hah877298-a11y/handheld-thermal-imager/01_设计说明/打样与工艺说明.md

# 主板打样与工艺说明

版本 v1.2　导出日期 2026-10-25

## 一、板卡概述

| 项目 | 内容 |
|---|---|
| 主控 | STM32F103ZET6（LQFP-144，嘉立创 C8310） |
| 电源 | USB Micro-B 5V → F1 自恢复保险丝 0.5A → AMS1117-3.3（C498117）→ 3.3V |
| 显示 | 2.54mm 2×17 排母（LCD1），直插 ATK-MD0280 2.8 寸并口屏 |
| 存储 | TF 卡座 TF1（推拉式，C293569） |
| 人机 | 4 个轻触按键 SW1~SW4、2 个 LED、5V 有源蜂鸣器 LS1（Q1 SS8050 驱动） |
| 时钟 | 8MHz 主晶振 Y1 + 32.768kHz RTC 晶振 Y2 |
| 保护 | D2 USBLC6-2SC6（USB ESD）、D1 1N4148、L1 磁珠、C16/C19 储能 |
| 调试 | J1（5P）SWD + 串口，J2/J3（4P）备用 IO |

## 二、工艺参数（与嘉立创常规打样一致）

| 项目 | 参数 |
|---|---|
| 层数 | 2 层 |
| 外形尺寸 | 100.0 × 80.0 mm，四角 R3 圆弧 |
| 板厚 | 1.6 mm |
| 铜厚 | 1 oz（35 μm） |
| 材质 | FR-4 |
| 线宽 | 信号 8 mil，3.3V/5V 主干 20 mil |
| 最小间距 | 6 mil（设计规则按此校验） |
| 过孔 | 孔径 0.3 mm / 焊盘 0.7 mm（实测钻孔 12 mil、焊盘 27.6 mil） |
| 铺铜 | 顶层 +3V3，底层整层 GND（双面铺铜） |
| 阻焊/丝印 | 绿色阻焊 / 白色丝印（下单按默认即可） |

## 三、DRC 与自检结果

- PCB DRC：0 错误 0 违规，连续运行两次结果一致。
- 元件 57 个 / 焊盘 328 个 / 过孔 98 个 / 铺铜 2 块。
- 网络级核对：57 个器件逐引脚对比原理图网表，0 处差异；无未连接网络、无短路。
- 原理图 DRC：0 错误。剩余 43 条为警告（图元网格对齐、供应商编号标准化、同名网络标号、主控未使用引脚未加非连接叉），不影响电气连接与制板。
- 固件 Keil 全量重编译：Code=58058，RO=8210，RW=152，ZI=25168，0 error 0 warning。
- 板框闭合，100×80 mm 圆角矩形。
- Gerber 独立解压核对：顶层/底层铜皮、顶层/底层丝印、顶层/底层阻焊、板框、PTH/NPTH/VIA 三个钻孔文件齐全。

## 四、阻抗说明（如实说明）

本板为两层板，没有做 90 欧姆差分阻抗控制，也未串联 22 欧姆匹配电阻（D2 为 USBLC6 ESD 保护）。实测 USB_DP 约 57 mm + 座子侧 8 mm，USB_DM 约 74 mm + 座子侧 9 mm，各经过 2 个过孔。该长度与换层对 USB 2.0 全速（12 Mbps）一般仍可正常枚举，但信号完整性余量有限；若出现识别不稳，优先缩短 D-/D+ 走线、减少换层，或改四层板做阻抗控制。

## 五、交付文件位置

| 文件 | 位置 |
|---|---|
| Gerber 制板文件.zip | `02_原理图与PCB/`，嘉立创下单直接上传这个压缩包 |
| BOM物料清单.xlsx | `02_原理图与PCB/`，26 项 / 57 个位号 |
| SMT坐标文件.xlsx | `02_原理图与PCB/`，57 行，单位 mm |
| PCB版图_顶层底层.pdf | `02_原理图与PCB/`，顶层丝印 / 顶层铜皮 / 底层丝印 / 底层铜皮 |
| PCB预览/*.png | `02_原理图与PCB/PCB预览/`，四张单层图；底层无丝印内容属正常 |
| PCB_3D渲染图.png | `02_原理图与PCB/`，带元件 3D 效果图，用于汇报展示 |
| PCB_3D模型.step | `02_原理图与PCB/`，带元件，FreeCAD/SolidWorks 可直接打开 |
| 原理图.pdf | `02_原理图与PCB/` |
| EDA工程源文件.epro2 | `02_原理图与PCB/`，嘉立创 EDA 专业版，原理图 + PCB 全在里面 |
| 手焊物料清单.xlsx | `02_原理图与PCB/`，元件/模块/工具清单 + 焊接顺序 |
| ThermalImager_v1.2.hex | `04_烧录文件/`，ST-Link 直接烧录 |
| Keil 源码 | `03_固件工程/`，可直接编译 |

## 六、下单注意

1. 上传 Gerber 压缩包后系统会自动识别：2 层 / 100×80 mm / 1.6 mm，无需手工填层数。
2. 按老师要求自行焊接：下单时只选“PCB 打样”，不要勾选 SMT 贴片；元件按 `手焊物料清单.xlsx` 自行采购，全部为 0805 及以上封装，无 0402，适合手焊。
3. 若以后改走 SMT：USB1（Micro-B 母座）在 BOM 中没有立创编号，需在下单页面手动指定，或这一颗改手焊；J1/J2/J3/LCD1 排针排母建议手焊，SMT 时可以不贴。
4. 蜂鸣器 LS1 是 5V 有源蜂鸣器 TMB12A05，由 Q1 三极管驱动，不要装成无源蜂鸣器。
5. TF 卡座为推拉式（SD-47352-101），贴片时注意方向，丝印 1 脚有标记。
6. 红外模块用 GY-MCU90640（MLX90640），I2C 模式：PS 脚接 GND 后重新上电，共 5 根线。

## 七、已知限制

1. 底层没有丝印，全部丝印在顶层，不影响打板。
2. 屏幕用 2×17 排母直插，装配时注意排母高度和外壳开窗。
3. 本板为毕业设计验证板，未做 EMC 认证测试。
4. 电源支路存在局部线宽不足 20 mil 的情况：+3V3 / +5V / USB_5V / VDDA 主干为 20 mil，但芯片引脚附近的分支为 10~12 mil；GND 部分支路为 8 mil。DRC 通过，常规电流下可用，若后续加大负载或改版，应把电源分支统一加粗到 20 mil 以上。
5. 顶层铺铜为 +3V3 而非 GND，底层为完整 GND 平面；顶层 GND 焊盘已就近打地过孔连接底层。
6. USB 差分对走线偏长且各换层 2 次，详见第四节，属于已知余量不足项。

## 八、版本变更

- v1.2　全量复核原理图/网表/PCB/固件；PCB DRC 归零；重编译固件；补充固件与焊接清单；修正过孔与 USB 说明。
- v1.1　修正 SW4 的 WK_UP 网络并补线，清理 SW3/SW4 悬空焊盘上的误接网络，重铺双面铜皮，重新导出全部制造文件。
- v1.0　首版交付。
