hah877298-a11y/handheld-thermal-imager/01_设计说明/功能验收记录/功能5_冻结与SD卡拍照.md

# 功能 5 联调验收记录（画面冻结 / SD 卡拍照）

- 日期：2026-10-07
- 硬件：正点原子精英板 STM32F103ZET6（板载 SD 卡座，SDIO PC8~12+PD2）+ 16GB SD 卡（FAT32）+ GY-MCU90640
- 固件：SDIO 驱动（教程实验 38 移植）+ FatFs（实验 39 移植，单盘化）+ 自写 BMP 模块 + WK_UP 冻结/拍照
- 观测：LCD 冻结画面 + 蜂鸣提示 + 串口日志 + 电脑端 BMP 打开验证

## 一、验收结果（对照 spec 第 8 节 6 条，全部通过）

| # | 标准 | 结果 |
|---|---|---|
| 1 | SD 卡识别 | ✓ `SD OK, size=15193MB`（16GB 卡正确识别） |
| 2 | BMP 电脑可打开、内容与屏上一致 | ✓ 256×192、24bpp、147,510 字节；铁红热图+双色准心与屏上一致、无颠倒 |
| 3 | 文件名递增不覆盖 | ✓ 0001→0007 递增；启动扫描已有最大编号防重启覆盖 |
| 4 | 冻结/解冻交互正确，蜂鸣提示 | ✓ WK_UP 按下冻结+拍照+"滴"；再按 RESUME 恢复；串口 `SAVED/RESUME` 完整记录 |
| 5 | 无卡/写失败不挂死 | ✓ `SD init FAIL`/`FATFS mount FAIL`/`SAVE FAIL` 提示路径齐备 |
| 6 | 帧率无影响 | ✓ 冻结时帧循环暂停（无 F= 输出）；解冻后 3.94Hz / r=45ms 恢复，全程无 -8 |

## 二、联调中解决的关键问题

1. **SDIO 驱动依赖**：教程驱动引用 DMA 库函数 → 工程补注册 `stm32f10x_dma.c`（驱动本身无 malloc 依赖，已核实）
2. **diskio.c 单盘化**：教程为双盘版（SD + W25QXX SPI Flash），去除 w25qxx/malloc 依赖（EX_FLASH 分支加 `#if _VOLUMES > 1` 编译守卫），`ff_memalloc/free` 用 512B 静态缓冲替换
3. **ffconf 精简**：`_VOLUMES=1`、`_CODE_PAGE=1`（ASCII 文件名，免 170KB cc936 码表）、`_USE_LFN=0`（8.3 短名）、`_USE_MKFS=0`
4. **挂载对象生命周期**：FATFS 对象必须全局存活（局部对象出块即失效），挂载改用全局 `s_fs`
5. **BMP 24bpp 字节序**：首版按 RGB 序写像素 → 红蓝通道互换、铁红变蓝调；BMP 规范为 **BGR**，修复后颜色完全正确
6. **视频条纹现象**（非缺陷）：LCD 每帧 24 条带自上而下重刷（~15ms），手机相机 30fps 抓拍会撞上"上半屏新帧/下半屏旧帧"的中间态 → 视频出现水平色带；肉眼无感（视觉暂留），属显示刷新与相机帧率的时间混叠，论文可作"显示刷新机制"讨论素材

## 三、性能与资源

- 拍照耗时：冻结态内完成，SDIO 4bit 写 147KB ≈ 100~200ms（含逐行重渲染），不影响实时帧率
- 内存：全系统 RAM 24.6KB/64KB；拍照无需整帧大缓冲（从冻结的 768 点色阶场逐行重渲染，行缓冲仅 768B）

## 四、遗留事项

- [ ] 素材存档（冻结瞬间拍屏 + 电脑 BMP 打开截图 → `docs/截图存档/功能5/`）

## 五、毕设六大功能完成总览

| 功能 | 状态 |
|---|---|
| 1. MLX90640 实时读取 | ✅ 2026-10-03 验收 |
| 2. 双线性插值热力图 | ✅ 2026-10-05 验收 |
| 3. 高低温自动追踪 | ✅ 2026-10-05 验收 |
| 4. 按键切换调色板 | ✅ 2026-10-07 验收 |
| 5. 冻结 / SD 拍照 | ✅ 2026-10-07 验收（本记录） |
| 6. 超温预警 | ✅ 2026-10-07 验收 |
