hah877298-a11y/handheld-thermal-imager/01_设计说明/功能验收记录/功能6_超温预警.md

# 功能 6 联调验收记录（超温预警）

- 日期：2026-10-07
- 硬件：正点原子精英板 STM32F103ZET6（蜂鸣器 PB8）+ GY-MCU90640（PS 接 GND）
- 固件：HARDWARE/BEEP 蜂鸣器驱动 + main.c 报警状态机（施密特迟滞），-O2
- 观测：蜂鸣器 + LED0 + 热图边框颜色 + 串口 ALARM ON/OFF

## 一、验收结果（对照 spec 第 5 节 5 条，全部通过）

| # | 标准 | 结果 |
|---|---|---|
| 1 | 触发/解除阈值正确（50 进 48 出） | ✓ 串口实录：`ALARM ON tmax=60.5`（热水杯入画）→ `ALARM OFF`（移出） |
| 2 | 红边框/白边框切换、蜂鸣响/停 | ✓ 触发时边框红+蜂鸣断续响，解除恢复白+静默（现象符合） |
| 3 | 串口 ALARM ON/OFF 打印 | ✓ 触发/解除各打一行，带 tmax 值 |
| 4 | 帧率不受影响 | ✓ 3.94Hz（F 间隔 2.03s/8 帧），r=46ms，全程无 -8 |
| 5 | 场景拍屏 + 串口截图 | ✓ 已存 `docs/截图存档/功能6/` |

实测序列（杯子进出视野）：`ON(60.5) → OFF → ON(58.4) → OFF`——每次进出只触发/解除一次，无边界抖振，迟滞带 (48,50) 工作正常。

## 二、实现要点（论文素材）

- **施密特迟滞**：触发 50°C / 解除 48°C，2°C 迟滞带内保持原状态，防阈值边界抖动反复报警
- **三级报警联动**：蜂鸣器 ~2Hz 断续（帧计数 bit1 翻转驱动）、LED0 闪烁（复用帧循环）、热图边框红/白切换（仅状态切换时 4 次 LCD_Fill 重画，帧率零影响）
- 报警状态机 ~15 行纯逻辑，`tmax` 复用功能 2 的统计结果，无新增计算开销

## 三、遗留事项

- [x] 素材存档（红边框拍屏 + 串口 ALARM 序列截图 → `docs/截图存档/功能6/`）
- 可选升级（不阻塞毕设）：串口命令调阈值（发送 `T=55.5` 实时设置），论文可写"人机交互接口"
