hah877298-a11y/handheld-thermal-imager/02_原理图与PCB/PCB版图_顶层底层.pdf

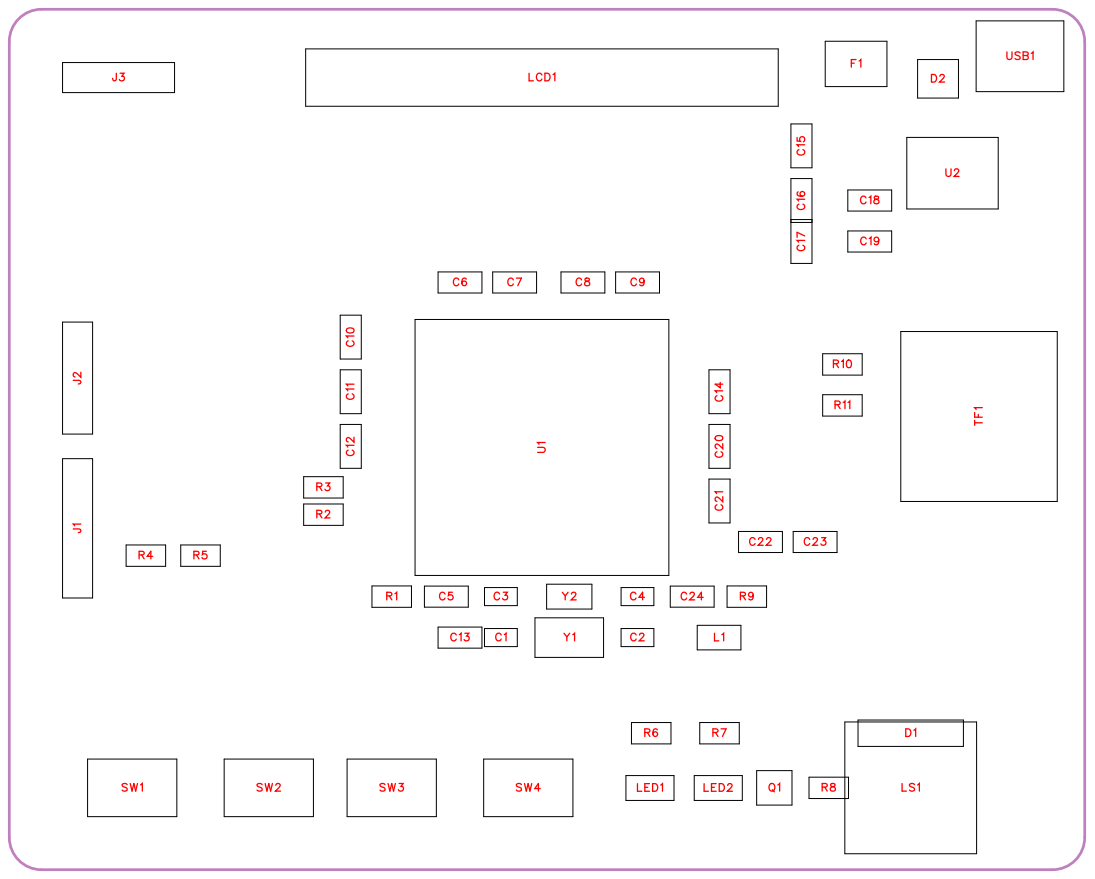
[picture p2: page 1]

No. | Quantity | Comment | Designator | Footprint | Value | Manufacture r Part | Manufacture r | Supplier Part | Supplier
1 | 2 | 22pF | C1,C2 | C0603 | 22pF | 0603N220J50 0 | N°Ñ(Walsin) | C107451 | LCSC
2 | 2 | 10pF | C3,C4 | C0603 | 10pF | CL10C100CB8 NNNC | SAMSUNG( ) C318677 | | LCSC
3 | 13 | 100nF | C5,C6,C8,C9,C10,C11,C12, C13,C15,C18,C22,C23,C24 | C0805 | 100nF | CC0805KKX7R 0BB104 | YAGEO(ýè) | C106243 | LCSC
4 | 4 | 10uF | C7,C14,C17,C20 | C0805 | 10uF | GRM21BR70J1 06KE76L | muRata(Q0) | C97916 | LCSC
5 | 2 | 22uF | C16,C19 | C0805 | 22uF | CL21A226MAQ NNNE | SAMSUNG( ) C45783 | | LCSC
6 | 1 | 4.7uF | C21 | C0805 | 4.7uF | EMK212B7475 KG-T | TAIYO YUDEN(*ñ) | C92762 | LCSC
7 | 1 | 1N4148 | D1 | DO-35_BD2.0 -L4.2-P8.20 -D0.5-RD | | 1N4148TR | onsemi(‰îŽ) | C84410 | LCSC
8 | 1 | USBLC6-2SC6D2 | | SOT-23-6_L2 .9-W1.6-P0. 95-LS2.8-BR | | USBLC6-2SC6ST(ÕJüS) | | C7519 | LCSC
9 | 1 | 0.5A | F1 | F1812 | | JK-MSMD050-30 | JK(ÑÑ) | C369168 | LCSC
10 | 1 | HDR1x5 | J1 | HDR-TH_5P-P 2.54-V-M | | MTP125-1105 S1 | MINTRON(U) C358687 | | LCSC
11 | 2 | HDR1x4 | J2,J3 | HDR-TH_4P-P 2.54-V-M | | | | C492403
12 | 1 | 600R@100MHzL1 | | L0805 | | GZ2012D601T F | Sunlord(zÜ) | C1017 | LCSC
13 | 1 | 2x17P | LCD1 | HDR-TH_34P-P2.54-V-F-R 2-C17-S2.54 -1 | | DS1023-2*17 SF11 | CONNFLY | C92264 | LCSC
14 | 2 | LED | LED1,LED2 | LED0805-R-R D | | SZYY0805R | yongyu(8ÕI5) Tj | T* () C434431 | LCSC
15 | 1 | BUZZER | LS1 | BUZ-TH_BD12 .0-P7.60-D0 .6-FD | | TMB12A05 | YUEXIN(¦¨) | C781860 | LCSC
16 | 1 | SS8050 | Q1 | SOT-23-3_L2 .9-W1.3-P1. 90-LS2.4-BR | | SS8050 | LGE(•I) | C402304 | LCSC
17 | 6 | 10k | R1,R2,R3,R9,R10,R11 | R0805 | 10k | RMCF0805FT1 0K0 | SEI(Stackpo) Tj | T* (le) Tj T* (Electronics) Tj | LCSC | T* (Inc.) C237755
18 | 2 | 4.7k | R4,R5 | R0805 | 4.7k | AC0805FR-07 4K7L | YAGEO(ýè) | C140869 | LCSC
19 | 3 | 1k | R6,R7,R8 | R0805 | 1k | ARG05BTC100 1 | I‰(Viking) | C309081 | LCSC

20 | 4 | TS-1187A | SW1,SW2,SW3,SW4 | SW-SMD_4P-L 5.1-W5.1-P3 .70-LS6.5-T L-2 | | TS-1187A-C-C-B | XKB Connect ivity(-ýd) | C318889 | LCSC
21 | 1 | TF-CARD | TF1 | SD-SMD_SD-4 7352-101 | | 473521001 | MOLEX | C293569 | LCSC
22 | 1 | STM32F103ZE T6 | U1 | LQFP-144_L2 0.0-W20.0-P 0.50-LS22.0 -BL | STM32F103ZE T6 | STM32F103ZE T6 | STMicroelec tronics | C8310 | LCSC
23 | 1 | AMS1117-3.3 | U2 | PG-SOT223-4 _L6.5-W3.5-P2.30-LS7.0 -BR | | AMS1117-3.3 | HGC(N ) | C498117 | LCSC
24 | 1 | USB_Micro-B | USB1 | USB_Micro
25 | 1 | 8MHz | Y1 | OSC-SMD_2P-L5.0-W3.2 | 8MHz | XSHEELNANF-8MHZ | TAITIEN(ðz5) Tj | T* (P) C242219 | LCSC
26 | 1 | 32.768kHz | Y2 | CRYSTAL-SMD _L3.2-W1.5-1 | 32.768kHz | SC-32S32.76 8kHz20PPM9p F | Seiko(¾å) | C97605 | LCSC

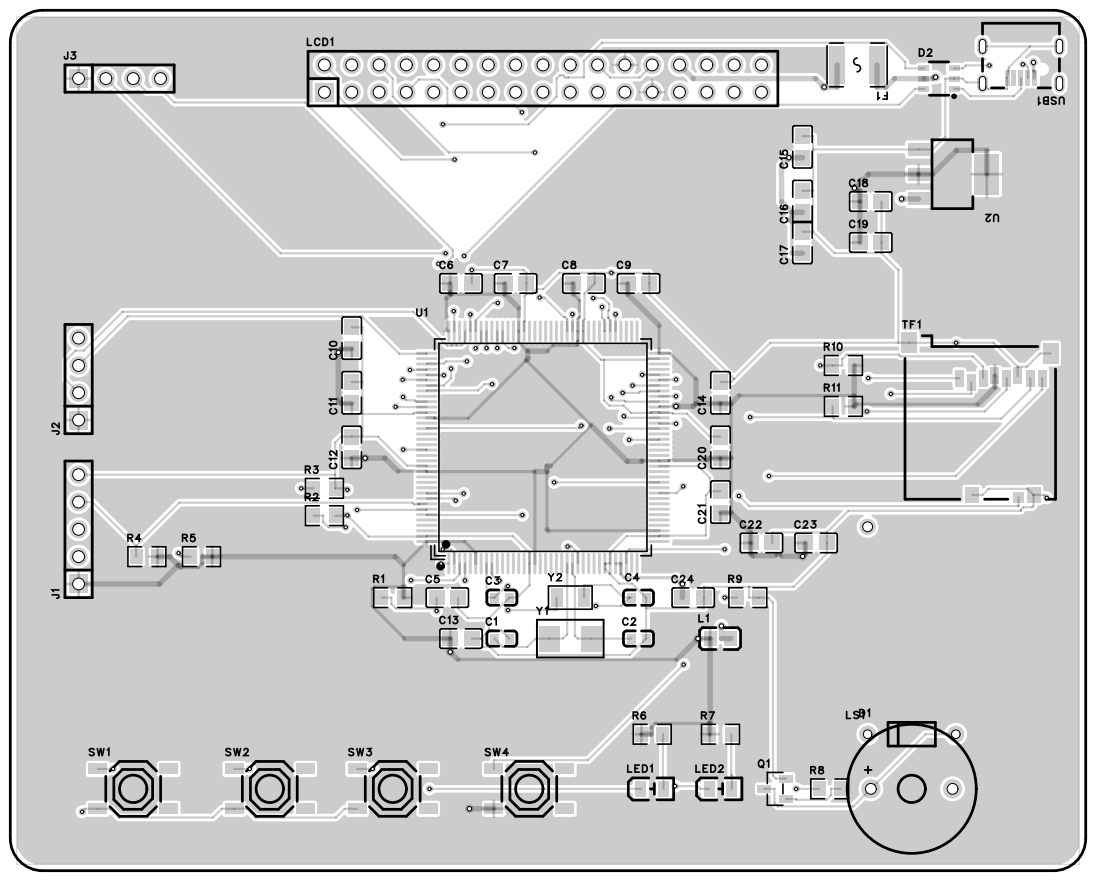
[picture p3: page 5]

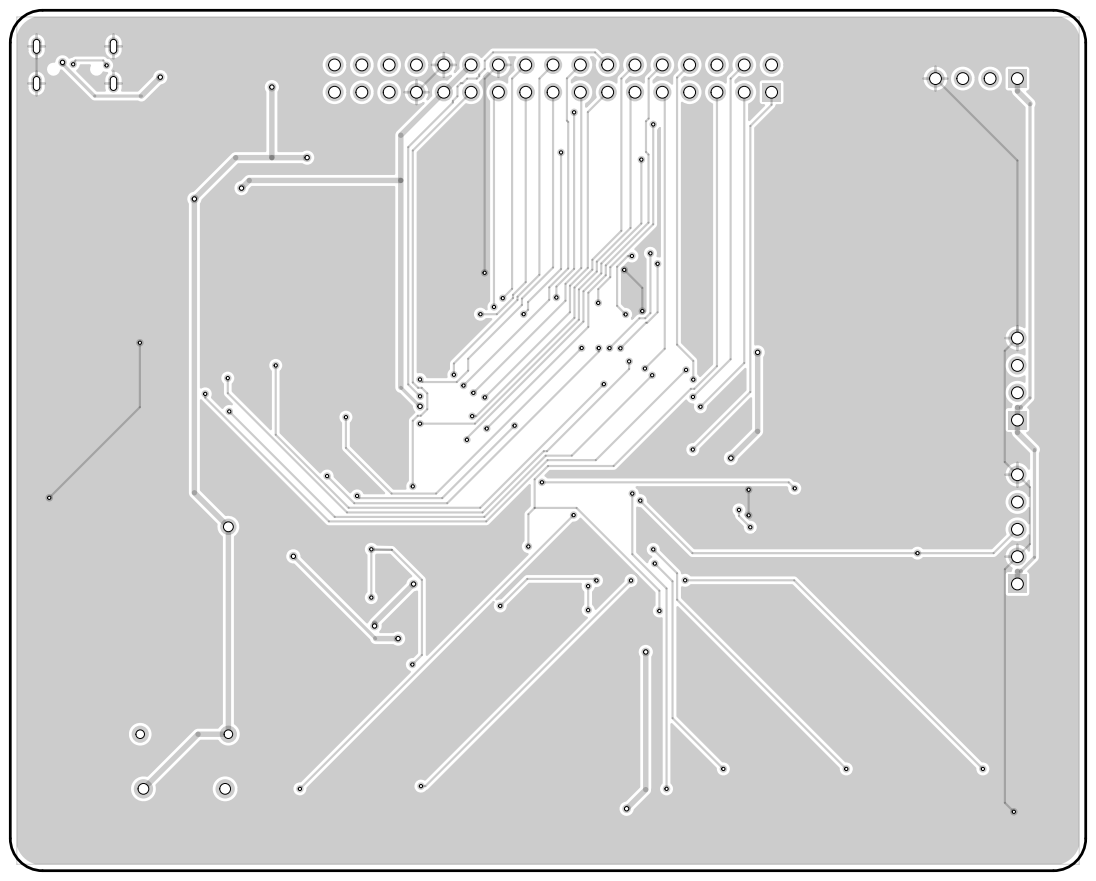
[picture p4: page 6]

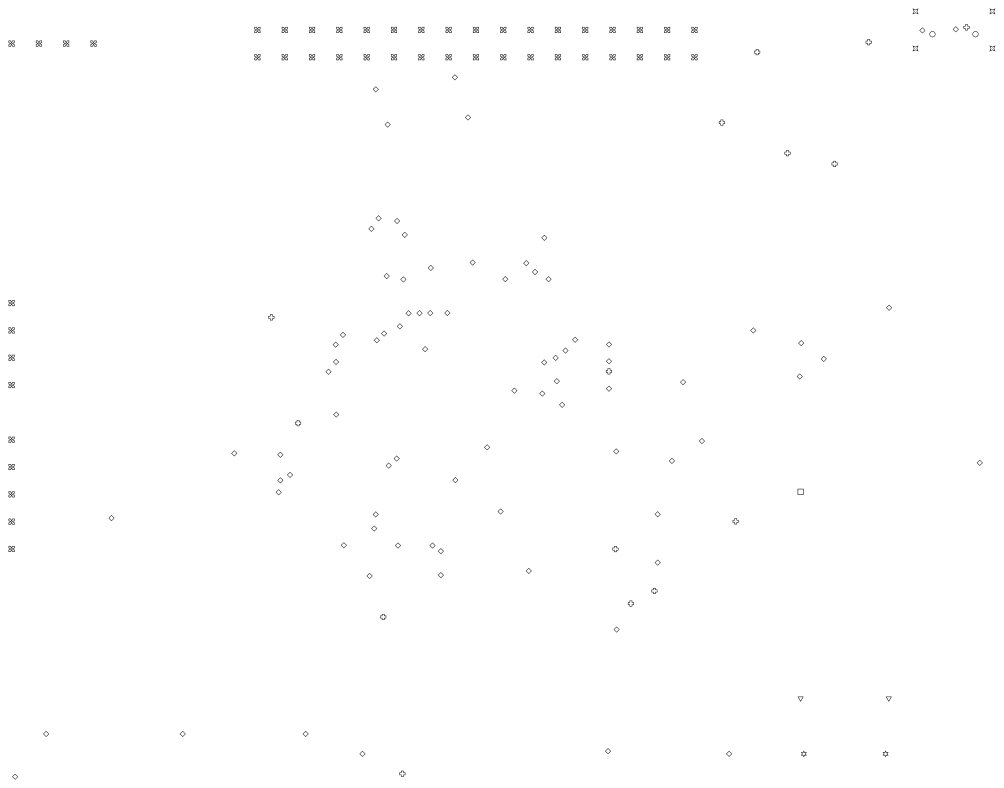
[picture p5: page 7]
