hah877298-a11y/handheld-thermal-imager/01_设计说明/功能验收证据/功能1/墙-LCD.jpg

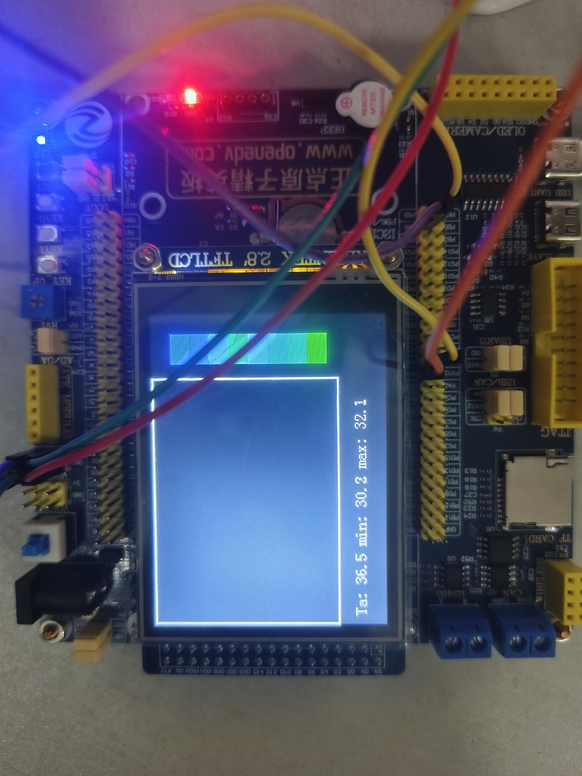
01_设计说明/功能验收证据/功能1/墙-LCD.jpg
