hah877298-a11y/handheld-thermal-imager/01_设计说明/功能验收证据/功能2/室温（按key0后）.jpg

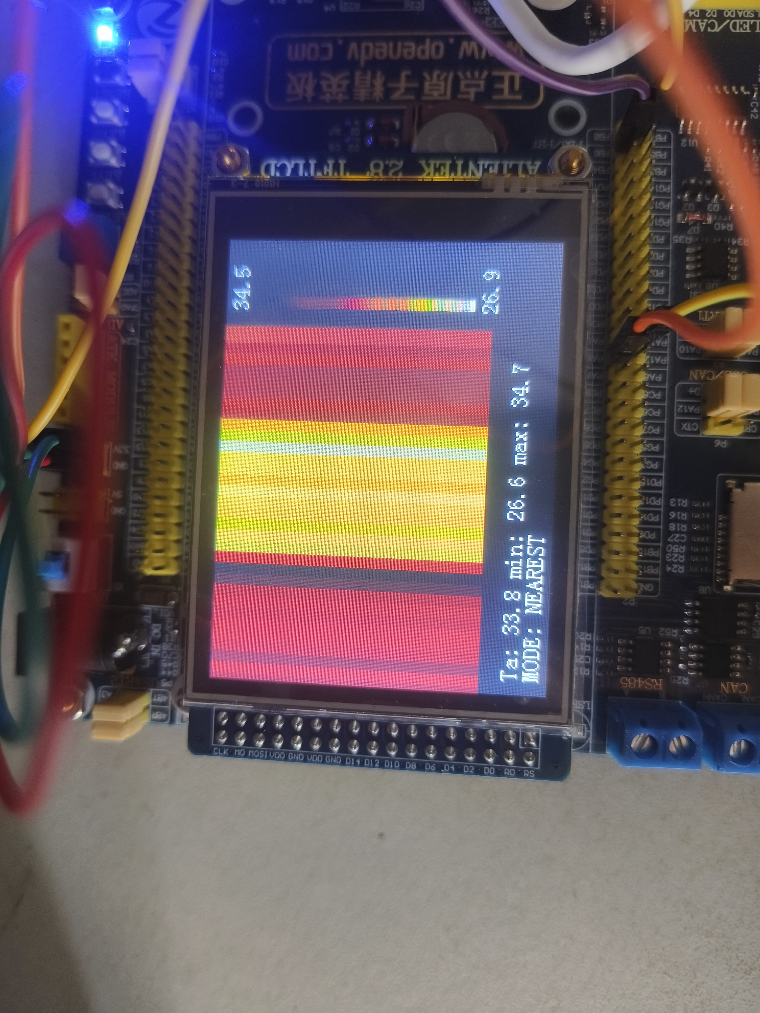
01_设计说明/功能验收证据/功能2/室温（按key0后）.jpg
