hah877298-a11y/handheld-thermal-imager/01_设计说明/功能验收证据/功能4/串口.jpg

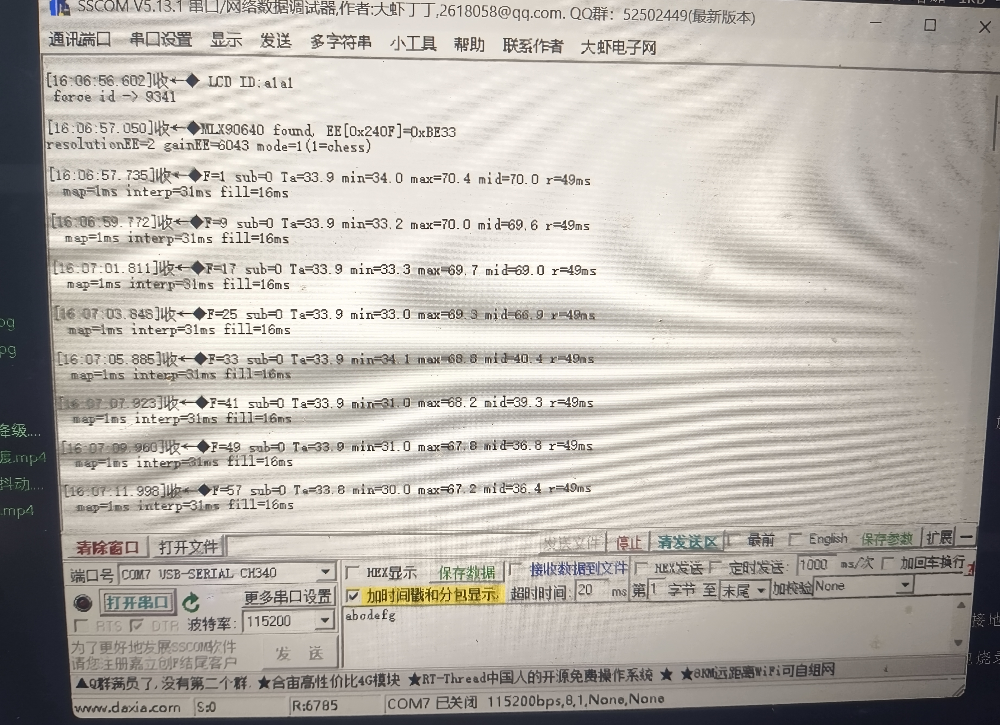
01_设计说明/功能验收证据/功能4/串口.jpg
