hah877298-a11y/handheld-thermal-imager/02_原理图与PCB/PCB预览/底层丝印.png

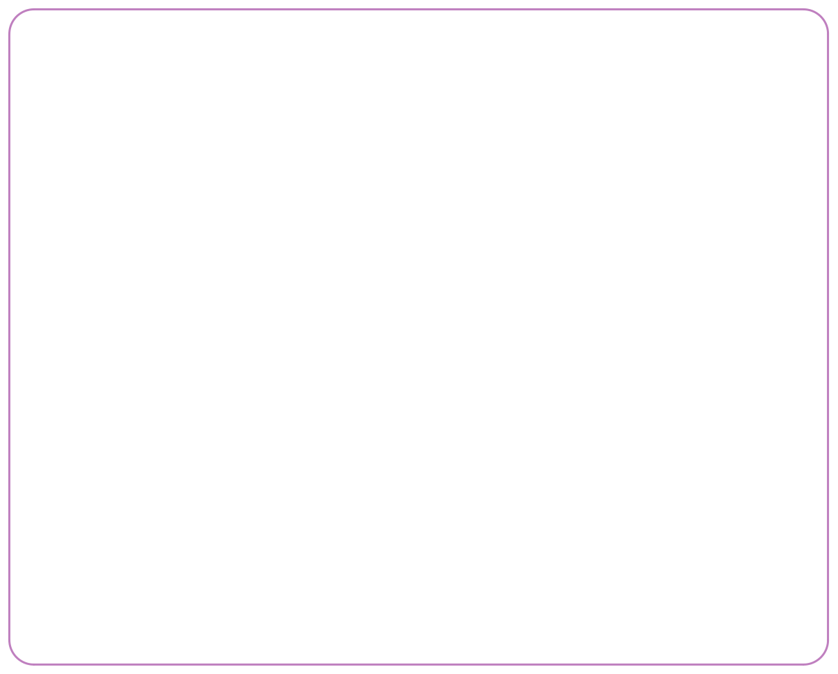
02_原理图与PCB/PCB预览/底层丝印.png
