hah877298-a11y/handheld-thermal-imager/02_原理图与PCB/器件方向标注.png

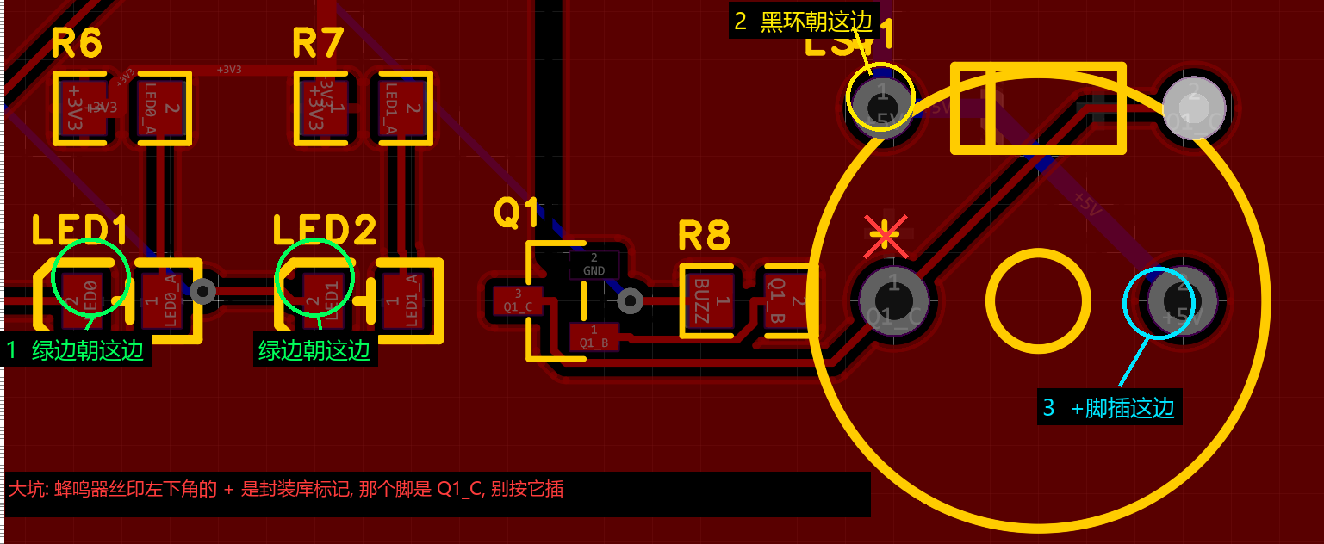
02_原理图与PCB/器件方向标注.png
