hah877298-a11y/handheld-thermal-imager/02_原理图与PCB/BOM物料清单.xlsx

No. | Quantity | Comment | Designator | Footprint | Value | Manufacturer Part | Manufacturer | Supplier Part | Supplier
1 | 2 | 22pF | C1,C2 | C0603 | 22pF | 0603N220J500 | 华新科(Walsin) | C107451 | LCSC
2 | 2 | 10pF | C3,C4 | C0603 | 10pF | CL10C100CB8NNNC | SAMSUNG(三星) | C318677 | LCSC
3 | 13 | 100nF | C5,C6,C8,C9,C10,C11,C12,C13,C15,C18,C22,C23,C24 | C0805 | 100nF | CC0805KKX7R0BB104 | YAGEO(国巨) | C106243 | LCSC
4 | 4 | 10uF | C7,C14,C17,C20 | C0805 | 10uF | GRM21BR70J106KE76L | muRata(村田) | C97916 | LCSC
5 | 2 | 22uF | C16,C19 | C0805 | 22uF | CL21A226MAQNNNE | SAMSUNG(三星) | C45783 | LCSC
6 | 1 | 4.7uF | C21 | C0805 | 4.7uF | EMK212B7475KG-T | TAIYO YUDEN(太诱) | C92762 | LCSC
7 | 1 | 1N4148 | D1 | DO-35_BD2.0-L4.2-P8.20-D0.5-RD |  | 1N4148TR | onsemi(安森美) | C84410 | LCSC
8 | 1 | USBLC6-2SC6 | D2 | SOT-23-6_L2.9-W1.6-P0.95-LS2.8-BR |  | USBLC6-2SC6 | ST(意法半导体) | C7519 | LCSC
9 | 1 | 0.5A | F1 | F1812 |  | JK-MSMD050-30 | JK(金科) | C369168 | LCSC
10 | 1 | HDR1x5 | J1 | HDR-TH_5P-P2.54-V-M |  | MTP125-1105S1 | MINTRON(明硕) | C358687 | LCSC
11 | 2 | HDR1x4 | J2,J3 | HDR-TH_4P-P2.54-V-M |  |  |  | C492403
12 | 1 | 600R@100MHz | L1 | L0805 |  | GZ2012D601TF | Sunlord(顺络) | C1017 | LCSC
13 | 1 | 2x17P | LCD1 | HDR-TH_34P-P2.54-V-F-R2-C17-S2.54-1 |  | DS1023-2*17SF11 | CONNFLY | C92264 | LCSC
14 | 2 | LED | LED1,LED2 | LED0805-R-RD |  | SZYY0805R | yongyu(永裕光电) | C434431 | LCSC
15 | 1 | BUZZER | LS1 | BUZ-TH_BD12.0-P7.60-D0.6-FD |  | TMB12A05 | YUEXIN(悦馨) | C781860 | LCSC
16 | 1 | SS8050 | Q1 | SOT-23-3_L2.9-W1.3-P1.90-LS2.4-BR |  | SS8050 | LGE(鲁光) | C402304 | LCSC
17 | 6 | 10k | R1,R2,R3,R9,R10,R11 | R0805 | 10k | RMCF0805FT10K0 | SEI(Stackpole Electronics Inc.) | C237755 | LCSC
18 | 2 | 4.7k | R4,R5 | R0805 | 4.7k | AC0805FR-074K7L | YAGEO(国巨) | C140869 | LCSC
19 | 3 | 1k | R6,R7,R8 | R0805 | 1k | ARG05BTC1001 | 光颉(Viking) | C309081 | LCSC
20 | 4 | TS-1187A | SW1,SW2,SW3,SW4 | SW-SMD_4P-L5.1-W5.1-P3.70-LS6.5-TL-2 |  | TS-1187A-C-C-B | XKB Connectivity(中国星坤) | C318889 | LCSC
21 | 1 | TF-CARD | TF1 | SD-SMD_SD-47352-101 |  | 473521001 | MOLEX | C293569 | LCSC
22 | 1 | STM32F103ZET6 | U1 | LQFP-144_L20.0-W20.0-P0.50-LS22.0-BL | STM32F103ZET6 | STM32F103ZET6 | STMicroelectronics | C8310 | LCSC
23 | 1 | AMS1117-3.3 | U2 | PG-SOT223-4_L6.5-W3.5-P2.30-LS7.0-BR |  | AMS1117-3.3 | HGC(华冠) | C498117 | LCSC
24 | 1 | USB_Micro-B | USB1 | USB_Micro
25 | 1 | 8MHz | Y1 | OSC-SMD_2P-L5.0-W3.2 | 8MHz | XSHEELNANF-8MHZ | TAITIEN(泰艺电子) | C242219 | LCSC
26 | 1 | 32.768kHz | Y2 | CRYSTAL-SMD_L3.2-W1.5-1 | 32.768kHz | SC-32S32.768kHz20PPM9pF | Seiko(精工) | C97605 | LCSC
