hah877298-a11y/handheld-thermal-imager/02_原理图与PCB/手焊物料清单.xlsx

Sheet: 现有与补买
现有器件核对与补买清单（2026-10-26）
类别 | 项目 | 规格 / 型号 | 数量 | 立创编号 | 参考价(元) | 结论 / 备注
现有核对 | ST-Link V2 仿真器 | 套件里的"仿真器" | 1 | — | — | 能用，接 J1 的 SWD 四线烧录
现有核对 | 母对母杜邦线 | 20cm | 若干 | — | — | 能用，接 MLX90640 模块和排针
现有核对 | 公对公 / 公对母杜邦线 | 20cm | 若干 | — | — | 备用，屏幕和排针都用母对母
现有核对 | 面包板、螺丝刀、鳄鱼夹 | — | — | — | — | 本项目用不上
现有核对 | C8T6 系统板、USB-TTL | — | — | — | — | 用不上，板上自带 ZET6 和 USB 座
现有核对 | 套件电阻(直插 1/4W) | — | — | — | — | 不能用：板上是 0805/0603 贴片
现有核对 | 两脚按键(照片左图) | 直插 2 脚 | 4 | — | — | 不能用：板上是 TS-1187A 贴片 4 脚，脚距 3.7mm，对不上也立不住
现有核对 | 5mm 直插 LED | — | — | — | — | 不能用：板上是 0805 贴片 LED
现有核对 | 蜂鸣器模块 | 套件小板 | — | — | — | 不能用：板上是 12mm 直插有源 TMB12A05
现有核对 | 0.96 寸 OLED、热敏模块 | — | — | — | — | 不能用：屏幕要 ATK-MD0280 2.8 寸 34P，测温要 MLX90640
板上必买 | STM32F103ZET6 | LQFP-144 0.5mm | 1 | C8310 | 30~45 | 全板最贵一颗，务必买正品
板上必买 | AMS1117-3.3 | SOT-223 | 1 | C498117 | 0.5
板上必买 | 22pF 贴片电容 | 0603 | 2 | C107451 | 0.1 | 8MHz 晶振负载电容，注意是 0603
板上必买 | 10pF 贴片电容 | 0603 | 2 | C318677 | 0.1 | 32.768k 负载电容，注意是 0603
板上必买 | 100nF 贴片电容 | 0805 | 13 | C106243 | 0.05 | 去耦，数量最多
板上必买 | 10uF 贴片电容 | 0805 | 4 | C97916 | 0.3
板上必买 | 22uF 贴片电容 | 0805 | 2 | C45783 | 1.2
板上必买 | 4.7uF 贴片电容 | 0805 | 1 | C92762 | 0.4
板上必买 | 10k 电阻 | 0805 | 6 | C237755 | 0.05
板上必买 | 4.7k 电阻 | 0805 | 2 | C140869 | 0.05 | I2C 上拉
板上必买 | 1k 电阻 | 0805 | 3 | C309081 | 0.05
板上必买 | 600R@100MHz 磁珠 | 0805 | 1 | C1017 | 0.2
板上必买 | 红色 LED | 0805 | 2 | C434431 | 0.1
板上必买 | 0.5A 自恢复保险丝 | 1812 | 1 | C369168 | 0.6
板上必买 | 1N4148 二极管 | DO-35 直插 | 1 | C84410 | 0.1 | 有极性，色环为负极
板上必买 | USBLC6-2SC6 ESD | SOT-23-6 | 1 | C7519 | 1.0
板上必买 | SS8050 三极管 | SOT-23 | 1 | C402304 | 0.2 | 驱动蜂鸣器
板上必买 | TS-1187A 轻触按键 | 贴片 4 脚 5.1x5.1 | 4 | C318889 | 0.2 | 替换你手上的两脚按键，建议买 10 只备损
板上必买 | MicroSD 卡座 | 贴片 SD-47352-101 | 1 | C293569 | 1.5 | 推拉式，认丝印 1 脚
板上必买 | Micro-B 母座 | 贴片 5P | 1 | 无编号 | 0.5 | BOM 里没编号，按实物图挑同款焊盘
板上必买 | 8MHz 无源晶振 | 贴片 5032 | 1 | C242219 | 1.5
板上必买 | 32.768kHz 晶振 | 贴片 3215 | 1 | C97605 | 2.0
板上必买 | 2x17 双排母 2.54 | 直插 34P | 1 | C92264 | 2.0 | 插 ATK-MD0280 屏幕
板上必买 | 1x5 排针 2.54 | 直插 | 1 | C358687 | 0.3 | SWD + 串口
板上必买 | 1x4 排针 2.54 | 直插 | 2 | C492403 | 0.2 | 备用 IO
板上必买 | 5V 有源蜂鸣器 | 直插 12mm TMB12A05 | 1 | C781860 | 1.5 | 必须是有源，别买无源
外部模块 | 2.8 寸 TFT LCD | ATK-MD0280 34P 2x17 | 1 | — | 45~60 | 别用套件里的 0.96 寸屏
外部模块 | 红外测温模块 | GY-MCU90640 (MLX90640) | 1 | — | 130~200 | 要 I2C 版，PS 脚接 GND 后重新上电
外部模块 | MicroSD 卡 | 8~32GB FAT32 | 1 | — | 15~30 | 32GB 以上格式化 exFAT 会初始化失败
工具 | 恒温烙铁 | 60W 以上，配尖头 | 1 | — | 60~110 | 没有就必须买
工具 | 焊锡丝 | 0.6mm 含铅或免洗 | 1 | — | 15~25 | 0.5mm 间距用细锡
工具 | 助焊剂 / 助焊笔 | — | 1 | — | 10~20 | 拖焊 LQFP 必需
工具 | 吸锡带 | 2mm | 1 | — | 5~10 | 引脚连锡时救场
工具 | 镊子 | 尖头 + 弯头 | 各1 | — | 10~20 | 贴片元件取放
工具 | 数字万用表 | 带通断档 | 1 | — | 30~60 | 上电前量 3V3 对地是否短路
工具 | 热风枪 / 风枪焊台 | 850 系列 | 1 | — | 150~250 | 0.5mm 间距 144 脚建议用风枪，或花 10~20 元找手机维修店帮吹 U1
工具 | 洗板水 / 无水酒精 | 500ml | 1 | — | 10 | 焊完清助焊剂
说明：价格为淘宝/立创参考价，仅估算，以实际下单为准。板上元件合计约 60~90 元（不含运费），外部模块 190~290 元，工具若全无约 280~500 元。
关键：0603 的 C1~C4 不要买成 0805；按键必须买 TS-1187A 贴片 4 脚，两脚插件装不上；蜂鸣器必须有源 5V。

Sheet: 板上元件
板上元件清单（共 26 项 / 57 个位号，全部随 PCB 一起采购）
序号 | 位号 | 数量 | 元件名称 / 数值 | 封装 | 立创编号 | 类型 | 极性 / 方向 | 焊接备注
1 | C1,C2 | 2 | 22pF 贴片电容 | 0603 | C107451 | 贴片 | 无极性 | 晶振负载电容，尽量贴近 Y1
2 | C3,C4 | 2 | 10pF 贴片电容 | 0603 | C318677 | 贴片 | 无极性 | 32.768kHz 晶振负载电容
3 | C5,C6,C8,C9,C10,C11,C12,C13,C15,C18,C22,C23,C24 | 13 | 100nF (0.1uF) 贴片电容 | 0805 | C106243 | 贴片 | 无极性 | 每个电源脚一颗，紧贴芯片放置
4 | C7,C14,C17,C20 | 4 | 10uF 贴片电容 | 0805 | C97916 | 贴片 | 无极性 | 电源滤波
5 | C16,C19 | 2 | 22uF 贴片电容 | 0805 | C45783 | 贴片 | 无极性 | 输入端储能，MLCC 无极性
6 | C21 | 1 | 4.7uF 贴片电容 | 0805 | C92762 | 贴片 | 无极性 | AMS1117 输出滤波
7 | D1 | 1 | 1N4148 开关二极管 | DO-35 直插 | C84410 | 直插 | 有极性：色环为阴极 | 丝印竖线一侧为阴极
8 | D2 | 1 | USBLC6-2SC6 ESD 保护 | SOT-23-6 | C7519 | 贴片 | 有方向：1 脚标记 | 靠近 USB 座放置
9 | F1 | 1 | 0.5A 自恢复保险丝 | 1812 | C369168 | 贴片 | 无极性 | USB 5V 输入串联
10 | J1 | 1 | 2.54mm 单排针 1x5 | 直插 1x5 | C358687 | 直插 | 有方向：1 脚方焊盘 | SWD + 串口调试口
11 | J2,J3 | 2 | 2.54mm 单排针 1x4 | 直插 1x4 | C492403 | 直插 | 有方向：1 脚方焊盘 | 备用 IO 引出
12 | L1 | 1 | 600R@100MHz 磁珠 | 0805 | C1017 | 贴片 | 无极性 | USB 电源滤波
13 | LCD1 | 1 | 2.54mm 双排母 2x17 | 直插 2x17 | C92264 | 直插 | 有方向：1 脚方焊盘 | 插 ATK-MD0280 屏幕模块
14 | LED1,LED2 | 2 | 红色 LED | 0805 | C434431 | 贴片 | 有极性：丝印缺口/短线为阴极 | 阴极朝 GND 方向
15 | LS1 | 1 | 5V 有源蜂鸣器 TMB12A05 | 直插 Φ12mm | C781860 | 直插 | 有极性：正极标记 | 必须买有源，不要买无源
16 | Q1 | 1 | SS8050 NPN 三极管 | SOT-23 | C402304 | 贴片 | 有方向：1 脚标记 | 驱动蜂鸣器
17 | R1,R2,R3,R9,R10,R11 | 6 | 10kΩ 电阻 | 0805 | C237755 | 贴片 | 无极性 | 上拉/下拉电阻
18 | R4,R5 | 2 | 4.7kΩ 电阻 | 0805 | C140869 | 贴片 | 无极性 | I2C 上拉
19 | R6,R7,R8 | 3 | 1kΩ 电阻 | 0805 | C309081 | 贴片 | 无极性 | LED 限流 / 三极管基极
20 | SW1,SW2,SW3,SW4 | 4 | 轻触按键 TS-1187A | 贴片 5.1x5.1mm | C318889 | 贴片 | 无极性 | 四脚按键，注意按帽方向
21 | TF1 | 1 | MicroSD 卡座（推拉式） | 贴片 SD-47352-101 | C293569 | 贴片 | 有方向：1 脚标记 | 丝印 1 脚对准板边标记
22 | U1 | 1 | STM32F103ZET6 主控 | LQFP-144 0.5mm | C8310 | 贴片 | 有方向：1 脚圆点 | 0.5mm 间距，建议拖焊 + 吸锡带
23 | U2 | 1 | AMS1117-3.3 稳压器 | SOT-223 | C498117 | 贴片 | 有方向：1 脚标记 | 注意散热焊盘朝铜皮
24 | USB1 | 1 | Micro-B 母座 5P | 贴片 Micro-B | 无（需自选） | 贴片 | 有方向：缺口朝板边 | BOM 无立创编号，按封装自选同款
25 | Y1 | 1 | 8MHz 无源晶振 | 贴片 5032 | C242219 | 贴片 | 无极性 | 紧贴 U1 晶振脚
26 | Y2 | 1 | 32.768kHz 无源晶振 | 贴片 3215 | C97605 | 贴片 | 无极性 | RTC 晶振，远离发热器件
说明：立创编号可直接在嘉立创/立创商城搜索下单；USB1 无立创编号，按“Micro-B 5P 贴片母座”自选同封装即可。总数量 57 与 BOM、坐标文件一致。

Sheet: 外部模块
需要另外购买的外部模块与线材（不焊在板上）
序号 | 名称 | 型号 / 规格 | 数量 | 备注
1 | 2.8 寸 TFT LCD 模块 | ATK-MD0280（34P 并口，2x17 排针） | 1 块 | 正点原子或同规格 ILI9341 并口模块；23 脚为 BL_CTRL 背光控制
2 | 红外热成像模块 | GY-MCU90640（MLX90640 BAA/BAB） | 1 块 | I2C 模式：PS 脚接 GND 后重新上电；5 线 VCC/GND/SCL/SDA/PS
3 | MicroSD 卡 | 8GB-32GB，FAT32 | 1 张 | 大于 32GB 需格式化为 FAT32，否则文件系统初始化失败
4 | ST-Link V2 调试器 | ST-Link V2（SWD 4 线） | 1 个 | 接 J1 的 3V3/SWDIO/SWCLK/GND，用于烧录与调试
5 | 杜邦线 | 母对母 20cm | 至少 5 根 | 连接 MLX90640 模块；屏幕直插排母不需要
6 | USB Micro-B 数据线 | 带数据传输功能 | 1 根 | 只能充电的线无法识别串口/供电调试
7 | 5V USB 电源 | 5V/1A 以上手机充电头 | 1 个 | 也可由电脑 USB 口供电，屏幕全亮时建议 1A
红外模块务必确认是 I2C 版本（PS 接 GND），不是串口版本；屏幕必须是 34P 2x17 并口，不是 SPI 版。

Sheet: 工具耗材
手焊工具与耗材（按已有工具跳过）
序号 | 名称 | 规格 | 数量 | 用途 / 备注
1 | 可调温电烙铁 | 60W，带 T12/936 头 | 1 把 | 焊接 LQFP-144 建议 330-350°C，刀头或马蹄头
2 | 焊锡丝 | 0.6mm，含松香 | 1 卷 | 细焊锡适合 0.5mm 间距引脚
3 | 助焊剂 | 免清洗助焊笔或针管 | 1 支 | 拖焊 LQFP 必需
4 | 吸锡带 | 2mm 宽 | 1 卷 | 清理 LQFP 连锡
5 | 镊子 | 尖头 + 弯头 | 各 1 把 | 贴片元件夹取
6 | 放大镜 / 手机微距 | 10 倍以上 | 1 个 | 检查 0.5mm 引脚连锡
7 | 数字万用表 | 带通断/直流电压档 | 1 台 | 上电前测短路，上电后测 3.3V
8 | 斜口钳 | 小号 | 1 把 | 剪排针、元件脚
9 | 洗板水 / 无水酒精 | 500ml | 1 瓶 | 焊后清洗助焊剂残留
10 | 防静电手环 | 可选 | 1 个 | 北方干燥环境建议使用
11 | 热风枪 | 可选，850 型 | 1 台 | 仅拆焊用；本板全部可电烙铁完成
标“可选”的两项没有也能完成整板焊接。

Sheet: 焊接顺序
建议焊接顺序（先电源、后主控、再外设，分阶段上电验证）
步骤 | 阶段 | 焊接内容 / 操作
1 | 来料检查 | 对照本表清点 57 个位号；万用表测 USB 5V 与 GND、3V3 与 GND 均不短路
2 | 电源部分 | USB1、F1、D1、L1、C16、C19、U2、C7/C14/C17/C20、C21 及电源脚 100nF
3 | 首次上电测试 | 只焊电源部分时插 USB，测 U2 输出 3.3V±0.1V；正常后再焊后面器件
4 | 主控 U1 | 先焊四角定位，再加助焊剂拖焊，吸锡带清连锡；焊完测 3V3-GND 不短路
5 | 晶振 | Y1 + C1/C2，Y2 + C3/C4，尽量贴近 U1 对应引脚，缩短环路
6 | 阻容 | 全部 0805 电阻电容按位号焊接，注意 R4/R5 为 4.7k，其余 10k/1k 不要混
7 | 人机交互 | SW1-SW4、LED1/LED2（注意极性）、R6/R7、Q1、R8、LS1（有源蜂鸣器）
8 | 存储与保护 | TF1（注意方向）、D2 USBLC6（靠近 USB 座）
9 | 接插件 | J1/J2/J3 排针、LCD1 双排母；排母先插上屏幕再焊，保证对位
10 | 烧录联调 | ST-Link 接 J1 烧录 固件_ThermalImager_v1.2.hex；依次测屏、按键、LED、蜂鸣器、SD、红外模块
关键：第 3 步必须先测到 3.3V 再焊 U1；U1 焊完再测一次 3V3 对 GND 不短路，避免整板返工。
