hah877298-a11y/handheld-thermal-imager/02_原理图与PCB/PCB_3D模型.step

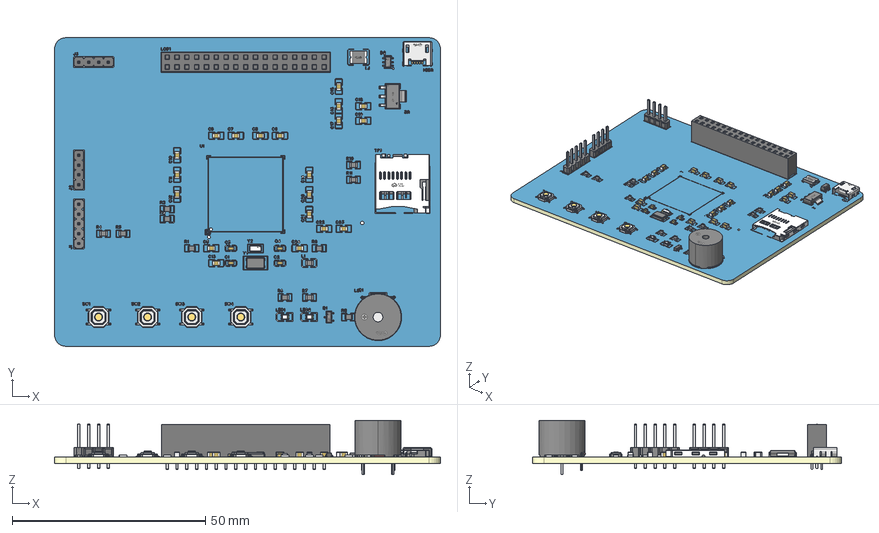
[picture p27: CAD file, 2026-11-04]
02_原理图与PCB/PCB_3D模型.step
100.0 x 80.0 x 14.0 mm
Board~pi6h
TopCopper~pi6h
BottomCopper~pi6h
TopSilkscreen~pi6h x 280
BottomSilkscreen~pi6h
TopFpcStiffener~pi6h
BottomFpcStiffener~pi6h
F1812~F1812_L4.5-W3.2-H1.0~kiP1
BUZ-TH_BD12.0-P7.60-D0.6-FD~BUZ-TH_D12.0-H9.5-P7.60~emkh
L0805~R0805_L2.0-W1.3-H0.6~YULm x 12
HDR-TH_5P-P2.54-V-M~HDR-TH_5P-P2.54-M-LI-1X5P~YDaC
C0603~C0603_L1.6-W0.8-H0.8~aZXp x 4
SW-SMD_4P-L5.1-W5.1-P3.70-LS6.5-TL-2~SW-SMD_4P-L5.2-W5.2-H1.5-LS6.4-P3.70~Tb1R x 4
C0805~C0805_L2.0-W1.3-H1.3~2Rtb x 20
SOT-23-3_L2.9-W1.3-P1.90-LS2.4-BR~SOT-23-3P_L2.9-W1.3-H1.0-LS2.4-P0.95~jdOb
HDR-TH_34P-P2.54-V-F-R2-C17-S2.54-1~HDR-TH_34P-P2.54-F-LI-2X17P~iKQQ
DO-35_BD2.0-L4.2-P8.20-D0.5-RD~DO-35_D1.9-L3.9-P8.2~hUUb
USB_Micro~MINI-USB-SMD_MICRO-4P-DIP~i1DE
LED0805-R-RD~LED0805-RD~PFW7 x 2
HDR-TH_4P-P2.54-V-M~HDR-TH_4P-P2.54-M-LI-1X4P~zc4y x 2
PG-SOT223-4_L6.5-W3.5-P2.30-LS7.0-BR~SOT-223-4P_L6.5-W3.5-H1.6-LS7.0-P2.30~01X5
OSC-SMD_2P-L5.0-W3.2~OSC-SMD-2P_L5.0-W3.2-H1.4~0gnj
CRYSTAL-SMD_L3.2-W1.5-1~CRYSTAL-SMD_L3.2-W1.5-1~sxPM
SD-SMD_SD-47352-101~SD-SMD_SD-47352-101~EpP3
SOT-23-6_L2.9-W1.6-P0.95-LS2.8-BR~SOT-23-6_L2.9-W1.6-H1.5-LS2.8-P0.95~knkJ
