hah877298-a11y/handheld-thermal-imager/02_原理图与PCB/原理图.pdf

1

2

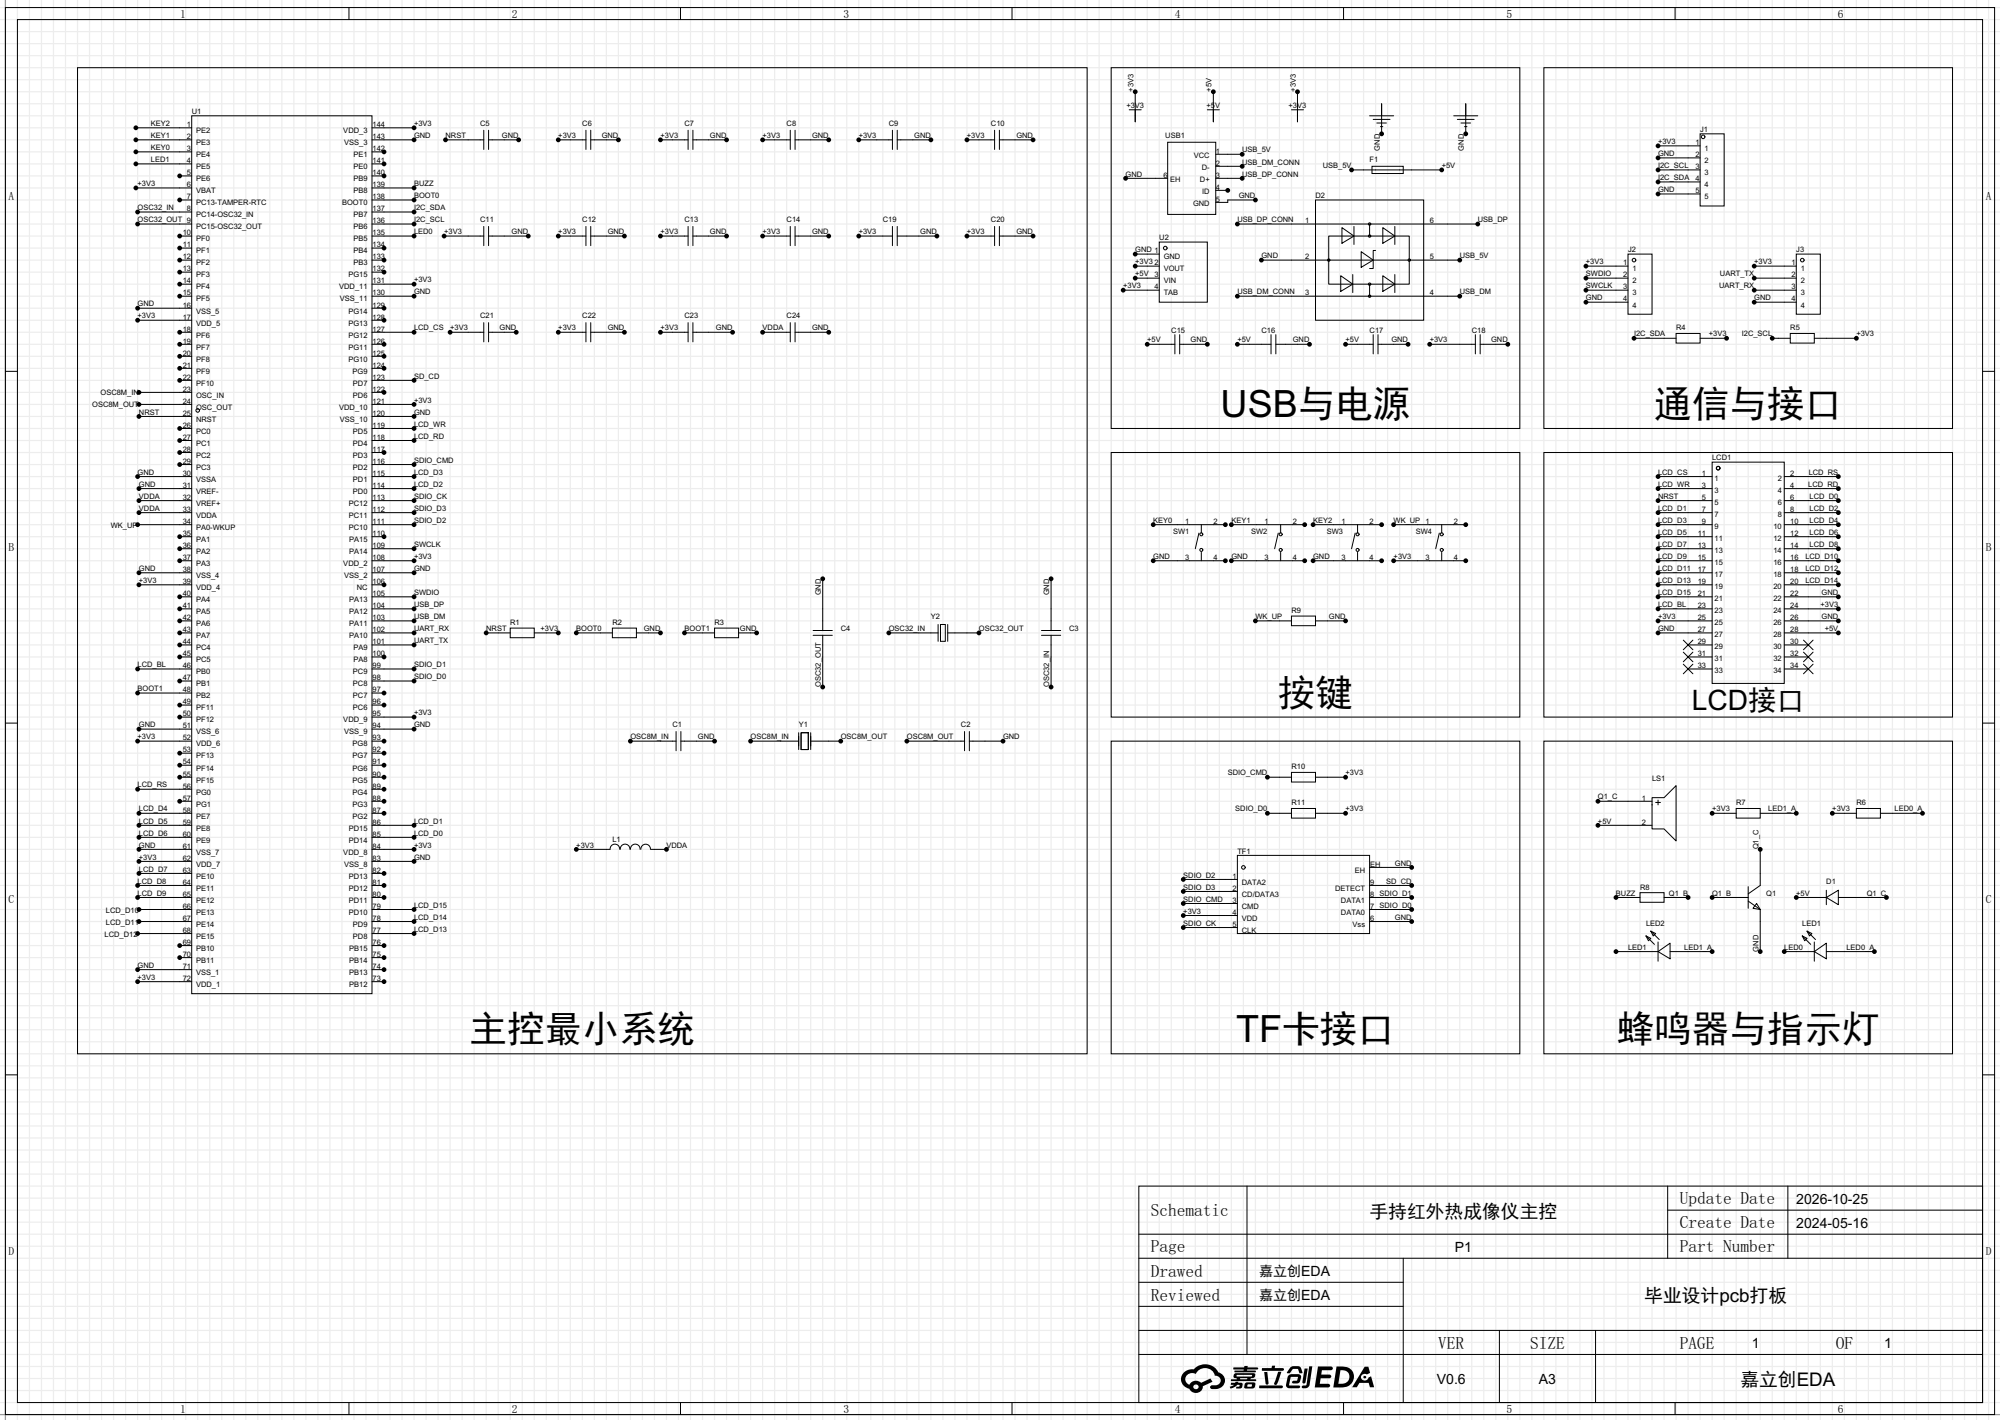
[picture p28: page 1]

+3V3 | 2
+5V | 3
