hah877298-a11y/handheld-thermal-imager/03_固件工程/HARDWARE/LCD/lcd.c

#include "lcd.h"
#include "stdlib.h"
#include "font.h" 
#include "usart.h"	 
#include "delay.h"	   
//////////////////////////////////////////////////////////////////////////////////	 
//锟斤拷锟斤拷锟斤拷只锟斤拷学习使锟矫ｏ拷未锟斤拷锟斤拷锟斤拷锟斤拷锟缴ｏ拷锟斤拷锟斤拷锟斤拷锟斤拷锟斤拷锟斤拷锟轿猴拷锟斤拷途
//ALIENTEK 战锟斤拷STM32F103锟斤拷锟斤拷锟斤拷V3
//2.4锟斤拷/2.8锟斤拷/3.5锟斤拷/4.3锟斤拷/7锟斤拷 TFT液锟斤拷锟斤拷锟斤拷	  
//支锟斤拷锟斤拷锟斤拷IC锟酵号帮拷锟斤拷:ILI9341/ILI9325/RM68042/RM68021/ILI9320/ILI9328/LGDP4531/LGDP4535/
//                  SPFD5408/1505/B505/C505/NT35310/NT35510/SSD1963锟斤拷		    
//锟斤拷锟斤拷原锟斤拷@ALIENTEK
//锟斤拷锟斤拷锟斤拷坛:www.openedv.com
//锟斤拷锟斤拷锟斤拷锟斤拷:2010/7/4
//锟芥本锟斤拷V2.9
//锟斤拷权锟斤拷锟叫ｏ拷锟斤拷锟斤拷鼐锟斤拷锟
//Copyright(C) 锟斤拷锟斤拷锟斤拷锟斤拷锟斤拷锟斤拷锟接科硷拷锟斤拷锟睫癸拷司 2014-2024
//All rights reserved	
//********************************************************************************
//V1.2锟睫革拷说锟斤拷
//支锟斤拷锟斤拷SPFD5408锟斤拷锟斤拷锟斤拷,锟斤拷锟斤拷锟揭猴拷锟絀D直锟接达拷印锟斤拷HEX锟斤拷式.锟斤拷锟斤拷榭碙CD锟斤拷锟斤拷IC.
//V1.3
//锟斤拷锟斤拷锟剿匡拷锟斤拷IO锟斤拷支锟斤拷
//锟睫革拷锟剿憋拷锟斤拷锟斤拷频募锟斤拷裕锟斤拷锟斤拷锟斤拷锟絍1.8锟斤拷锟皆猴拷目锟斤拷锟斤拷锟芥本锟斤拷
//锟斤拷锟斤拷1.8锟芥本之前(锟斤拷锟斤拷锟斤拷1.8)锟斤拷液锟斤拷模锟斤拷,锟斤拷锟睫革拷LCD_Init锟斤拷锟斤拷锟斤拷LCD_LED=1;为LCD_LED=1;
//V1.4
//锟睫革拷锟斤拷LCD_ShowChar锟斤拷锟斤拷锟斤拷使锟矫伙拷锟姐功锟杰伙拷锟街凤拷锟斤拷
//锟斤拷锟斤拷锟剿猴拷锟斤拷锟斤拷锟斤拷示锟斤拷支锟斤拷
//V1.5 20110730
//1,锟睫革拷锟斤拷B505液锟斤拷锟斤拷锟斤拷色锟斤拷锟斤拷锟絙ug.
//2,锟睫革拷锟剿匡拷锟斤拷IO锟斤拷锟斤拷锟斤拷锟斤拷锟斤拷锟斤拷锟矫凤拷式.
//V1.6 20111116
//1,锟斤拷锟斤拷锟絃GDP4535液锟斤拷锟斤拷锟斤拷锟斤拷支锟斤拷
//V1.7 20120713
//1,锟斤拷锟斤拷LCD_RD_DATA锟斤拷锟斤拷
//2,锟斤拷锟接讹拷ILI9341锟斤拷支锟斤拷
//3,锟斤拷锟斤拷ILI9325锟侥讹拷锟斤拷锟斤拷锟斤拷锟斤拷锟斤拷
//4,锟斤拷锟斤拷LCD_Scan_Dir锟斤拷锟斤拷(锟斤拷锟斤拷使锟斤拷)	  
//6,锟斤拷锟斤拷锟睫革拷锟剿诧拷锟斤拷原锟斤拷锟侥猴拷锟斤拷,锟斤拷锟斤拷应9341锟侥诧拷锟斤拷
//V1.8 20120905
//1,锟斤拷锟斤拷LCD锟斤拷要锟斤拷锟斤拷锟斤拷锟矫结构锟斤拷lcddev
//2,锟斤拷锟斤拷LCD_Display_Dir锟斤拷锟斤拷,支锟斤拷锟斤拷锟竭猴拷锟斤拷锟斤拷锟叫伙拷
//V1.9 20120911
//1,锟斤拷锟斤拷RM68042锟斤拷锟斤拷锟斤拷ID:6804锟斤拷锟斤拷锟斤拷锟斤拷6804锟斤拷支锟街猴拷锟斤拷锟斤拷示锟斤拷锟斤拷原锟津：改憋拷扫锟借方式锟斤拷
//锟斤拷锟斤拷6804锟斤拷锟斤拷锟斤拷锟斤拷失效锟斤拷锟皆癸拷锟杰多方锟斤拷锟斤拷锟斤拷锟叫ｏ拷锟斤拷时锟睫解。
//V2.0 20120924
//锟节诧拷硬锟斤拷锟斤拷位锟斤拷锟斤拷锟斤拷锟,ILI9341锟斤拷ID锟斤拷取锟结被锟斤拷锟斤拷锟9300,锟睫革拷LCD_Init,锟斤拷锟睫凤拷识锟斤拷
//锟斤拷锟斤拷锟斤拷锟斤拷锟斤拷锟絀D为9300/锟角凤拷ID锟斤拷,强锟斤拷指锟斤拷锟斤拷锟斤拷IC为ILI9341锟斤拷执锟斤拷9341锟侥筹拷始锟斤拷锟斤拷
//V2.1 20120930
//锟斤拷锟斤拷ILI9325锟斤拷锟斤拷色锟斤拷bug锟斤拷
//V2.2 20121007
//锟斤拷锟斤拷LCD_Scan_Dir锟斤拷bug锟斤拷
//V2.3 20130120
//锟斤拷锟斤拷6804支锟街猴拷锟斤拷锟斤拷示
//V2.4 20131120
//1,锟斤拷锟斤拷NT35310锟斤拷ID:5310锟斤拷锟斤拷锟斤拷锟斤拷锟斤拷支锟斤拷
//2,锟斤拷锟斤拷LCD_Set_Window锟斤拷锟斤拷,锟斤拷锟斤拷锟斤拷锟矫达拷锟斤拷,锟皆匡拷锟斤拷锟斤拷锟,锟饺斤拷锟斤拷锟斤拷,锟斤拷锟角该猴拷锟斤拷锟节猴拷锟斤拷时,锟斤拷支锟斤拷6804.
//V2.5 20140211
//1,锟斤拷锟斤拷NT35510锟斤拷ID:5510锟斤拷锟斤拷锟斤拷锟斤拷锟斤拷支锟斤拷
//V2.6 20140504
//1,锟斤拷锟斤拷ASCII 24*24锟斤拷锟斤拷锟街э拷锟(锟斤拷锟斤拷锟斤拷锟斤拷锟矫伙拷锟斤拷锟斤拷锟斤拷锟斤拷锟斤拷锟斤拷)  
//2,锟睫改诧拷锟街猴拷锟斤拷锟斤拷锟斤拷,锟斤拷支锟斤拷MDK -O2锟脚伙拷
//3,锟斤拷锟9341/35310/35510,写时锟斤拷锟斤拷锟斤拷为锟斤拷锟,锟斤拷锟斤拷锟杰碉拷锟斤拷锟斤拷俣锟
//4,去锟斤拷锟斤拷SSD1289锟斤拷支锟斤拷,锟斤拷为1289实锟斤拷锟斤拷太锟斤拷锟斤拷,锟斤拷锟斤拷锟斤拷要1us...锟斤拷直锟斤拷锟斤拷.锟斤拷锟绞猴拷F4使锟斤拷
//5,锟斤拷锟斤拷68042锟斤拷C505锟斤拷IC锟侥讹拷锟斤拷色锟斤拷锟斤拷锟斤拷bug.
//V2.7 20140710
//1,锟斤拷锟斤拷LCD_Color_Fill锟斤拷锟斤拷锟斤拷一锟斤拷bug. 
//2,锟斤拷锟斤拷LCD_Scan_Dir锟斤拷锟斤拷锟斤拷一锟斤拷bug.
//V2.8 20140721
//1,锟斤拷锟組DK使锟斤拷-O2锟脚伙拷时LCD_ReadPoint锟斤拷锟斤拷锟斤拷锟斤拷失效锟斤拷锟斤拷锟斤拷.
//2,锟斤拷锟斤拷LCD_Scan_Dir锟斤拷锟斤拷时锟斤拷锟矫碉拷扫锟借方式锟斤拷示锟斤拷全锟斤拷bug.
//V2.9 20141130
//1,锟斤拷锟斤拷锟斤拷SSD1963 LCD锟斤拷支锟斤拷.
//2,锟斤拷锟斤拷LCD_SSD_BackLightSet锟斤拷锟斤拷
//3,取锟斤拷ILI93XX锟斤拷Rxx锟侥达拷锟斤拷锟斤拷锟斤拷
//////////////////////////////////////////////////////////////////////////////////	 

//LCD锟侥伙拷锟斤拷锟斤拷色锟酵憋拷锟斤拷色	   
u16 POINT_COLOR=0x0000;	//锟斤拷锟斤拷锟斤拷色
u16 BACK_COLOR=0xFFFF;  //锟斤拷锟斤拷色 
  
//锟斤拷锟斤拷LCD锟斤拷要锟斤拷锟斤拷
//默锟斤拷为锟斤拷锟斤拷
_lcd_dev lcddev;
	 
//写锟侥达拷锟斤拷锟斤拷锟斤拷
//regval:锟侥达拷锟斤拷值
void LCD_WR_REG(u16 regval)
{   
	LCD->LCD_REG=regval;//写锟斤拷要写锟侥寄达拷锟斤拷锟斤拷锟	 
}
//写LCD锟斤拷锟斤拷
//data:要写锟斤拷锟街
void LCD_WR_DATA(u16 data)
{	 
	LCD->LCD_RAM=data;		 
}
//锟斤拷LCD锟斤拷锟斤拷
//锟斤拷锟斤拷值:锟斤拷锟斤拷锟斤拷值
u16 LCD_RD_DATA(void)
{
	vu16 ram;			//锟斤拷止锟斤拷锟脚伙拷
	ram=LCD->LCD_RAM;	
	return ram;	 
}					   
//写锟侥达拷锟斤拷
//LCD_Reg:锟侥达拷锟斤拷锟斤拷址
//LCD_RegValue:要写锟斤拷锟斤拷锟斤拷锟
void LCD_WriteReg(u16 LCD_Reg,u16 LCD_RegValue)
{	
	LCD->LCD_REG = LCD_Reg;		//写锟斤拷要写锟侥寄达拷锟斤拷锟斤拷锟	 
	LCD->LCD_RAM = LCD_RegValue;//写锟斤拷锟斤拷锟斤拷	    		 
}	   
//锟斤拷锟侥达拷锟斤拷
//LCD_Reg:锟侥达拷锟斤拷锟斤拷址
//锟斤拷锟斤拷值:锟斤拷锟斤拷锟斤拷锟斤拷锟斤拷
u16 LCD_ReadReg(u16 LCD_Reg)
{										   
	LCD_WR_REG(LCD_Reg);		//写锟斤拷要锟斤拷锟侥寄达拷锟斤拷锟斤拷锟
	delay_us(5);		  
	return LCD_RD_DATA();		//锟斤拷锟截讹拷锟斤拷锟斤拷值
}   
//锟斤拷始写GRAM
void LCD_WriteRAM_Prepare(void)
{
 	LCD->LCD_REG=lcddev.wramcmd;	  
}	 
//LCD写GRAM
//RGB_Code:锟斤拷色值
void LCD_WriteRAM(u16 RGB_Code)
{							    
	LCD->LCD_RAM = (lcddev.id==0X9341)?~RGB_Code:RGB_Code;//写十锟斤拷位GRAM
}
//锟斤拷ILI93xx锟斤拷锟斤拷锟斤拷锟斤拷锟斤拷为GBR锟斤拷式锟斤拷锟斤拷锟斤拷锟斤拷写锟斤拷锟绞憋拷锟轿猂GB锟斤拷式锟斤拷
//通锟斤拷锟矫猴拷锟斤拷转锟斤拷
//c:GBR锟斤拷式锟斤拷锟斤拷色值
//锟斤拷锟斤拷值锟斤拷RGB锟斤拷式锟斤拷锟斤拷色值
u16 LCD_BGR2RGB(u16 c)
{
	u16  r,g,b,rgb;   
	b=(c>>0)&0x1f;
	g=(c>>5)&0x3f;
	r=(c>>11)&0x1f;	 
	rgb=(b<<11)+(g<<5)+(r<<0);		 
	return(rgb);
} 
//锟斤拷mdk -O1时锟斤拷锟脚伙拷时锟斤拷要锟斤拷锟斤拷
//锟斤拷时i
void opt_delay(u8 i)
{
	while(i--);
}
//锟斤拷取锟斤拷某锟斤拷锟斤拷锟缴值	 
//x,y:锟斤拷锟斤拷
//锟斤拷锟斤拷值:锟剿碉拷锟斤拷锟缴
u16 LCD_ReadPoint(u16 x,u16 y)
{
 	u16 r=0,g=0,b=0;
	if(x>=lcddev.width||y>=lcddev.height)return 0;	//锟斤拷锟斤拷锟剿凤拷围,直锟接凤拷锟斤拷		   
	LCD_SetCursor(x,y);	    
	if(lcddev.id==0X9341||lcddev.id==0X6804||lcddev.id==0X5310||lcddev.id==0X1963)LCD_WR_REG(0X2E);//9341/6804/3510/1963 锟斤拷锟酵讹拷GRAM指锟斤拷
	else if(lcddev.id==0X5510)LCD_WR_REG(0X2E00);	//5510 锟斤拷锟酵讹拷GRAM指锟斤拷
	else LCD_WR_REG(0X22);      		 			//锟斤拷锟斤拷IC锟斤拷锟酵讹拷GRAM指锟斤拷
	if(lcddev.id==0X9320)opt_delay(2);				//FOR 9320,锟斤拷时2us	    
 	r=LCD_RD_DATA();								//dummy Read	   
	if(lcddev.id==0X1963)return r;					//1963直锟接讹拷锟酵匡拷锟斤拷 
	opt_delay(2);	  
 	r=LCD_RD_DATA();  		  						//实锟斤拷锟斤拷锟斤拷锟斤拷色
 	if(lcddev.id==0X9341||lcddev.id==0X5310||lcddev.id==0X5510)		//9341/NT35310/NT35510要锟斤拷2锟轿讹拷锟斤拷
 	{
		opt_delay(2);	  
		b=LCD_RD_DATA(); 
		g=r&0XFF;		//锟斤拷锟斤拷9341/5310/5510,锟斤拷一锟轿讹拷取锟斤拷锟斤拷RG锟斤拷值,R锟斤拷前,G锟节猴拷,锟斤拷占8位
		g<<=8;
	} 
	if(lcddev.id==0X9325||lcddev.id==0X4535||lcddev.id==0X4531||lcddev.id==0XB505||lcddev.id==0XC505)return r;	//锟解几锟斤拷IC直锟接凤拷锟斤拷锟斤拷色值
	else if(lcddev.id==0X9341||lcddev.id==0X5310||lcddev.id==0X5510)return (((r>>11)<<11)|((g>>10)<<5)|(b>>11));//ILI9341/NT35310/NT35510锟斤拷要锟斤拷式转锟斤拷一锟斤拷
	else return LCD_BGR2RGB(r);						//锟斤拷锟斤拷IC
}			 
//LCD锟斤拷锟斤拷锟斤拷示
void LCD_DisplayOn(void)
{					   
	if(lcddev.id==0X9341||lcddev.id==0X6804||lcddev.id==0X5310||lcddev.id==0X1963)LCD_WR_REG(0X29);	//锟斤拷锟斤拷锟斤拷示
	else if(lcddev.id==0X5510)LCD_WR_REG(0X2900);	//锟斤拷锟斤拷锟斤拷示
	else LCD_WriteReg(0X07,0x0173); 				 	//锟斤拷锟斤拷锟斤拷示
}	 
//LCD锟截憋拷锟斤拷示
void LCD_DisplayOff(void)
{	   
	if(lcddev.id==0X9341||lcddev.id==0X6804||lcddev.id==0X5310||lcddev.id==0X1963)LCD_WR_REG(0X28);	//锟截憋拷锟斤拷示
	else if(lcddev.id==0X5510)LCD_WR_REG(0X2800);	//锟截憋拷锟斤拷示
	else LCD_WriteReg(0X07,0x0);//锟截憋拷锟斤拷示 
}   
//锟斤拷锟矫癸拷锟轿伙拷锟
//Xpos:锟斤拷锟斤拷锟斤拷
//Ypos:锟斤拷锟斤拷锟斤拷
void LCD_SetCursor(u16 Xpos, u16 Ypos)
{
 	if(lcddev.id==0X9341||lcddev.id==0X5310)
	{		    
		LCD_WR_REG(lcddev.setxcmd); 
		LCD_WR_DATA(Xpos>>8);LCD_WR_DATA(Xpos&0XFF); 			 
		LCD_WR_REG(lcddev.setycmd); 
		LCD_WR_DATA(Ypos>>8);LCD_WR_DATA(Ypos&0XFF); 		
	}else if(lcddev.id==0X6804)
	{
		if(lcddev.dir==1)Xpos=lcddev.width-1-Xpos;//锟斤拷锟斤拷时锟斤拷锟斤拷
		LCD_WR_REG(lcddev.setxcmd); 
		LCD_WR_DATA(Xpos>>8);LCD_WR_DATA(Xpos&0XFF); 
		LCD_WR_REG(lcddev.setycmd); 
		LCD_WR_DATA(Ypos>>8);LCD_WR_DATA(Ypos&0XFF); 
	}else if(lcddev.id==0X1963)
	{  			 		
		if(lcddev.dir==0)//x锟斤拷锟斤拷锟斤拷要锟戒换
		{
			Xpos=lcddev.width-1-Xpos;
			LCD_WR_REG(lcddev.setxcmd); 
			LCD_WR_DATA(0);LCD_WR_DATA(0); 		
			LCD_WR_DATA(Xpos>>8);LCD_WR_DATA(Xpos&0XFF);		 	 
		}else
		{
			LCD_WR_REG(lcddev.setxcmd); 
			LCD_WR_DATA(Xpos>>8);LCD_WR_DATA(Xpos&0XFF); 		
			LCD_WR_DATA((lcddev.width-1)>>8);LCD_WR_DATA((lcddev.width-1)&0XFF);		 	 			
		}	
		LCD_WR_REG(lcddev.setycmd); 
		LCD_WR_DATA(Ypos>>8);LCD_WR_DATA(Ypos&0XFF); 		
		LCD_WR_DATA((lcddev.height-1)>>8);LCD_WR_DATA((lcddev.height-1)&0XFF); 			 		
		
	}else if(lcddev.id==0X5510)
	{
		LCD_WR_REG(lcddev.setxcmd);LCD_WR_DATA(Xpos>>8); 		
		LCD_WR_REG(lcddev.setxcmd+1);LCD_WR_DATA(Xpos&0XFF);			 
		LCD_WR_REG(lcddev.setycmd);LCD_WR_DATA(Ypos>>8);  		
		LCD_WR_REG(lcddev.setycmd+1);LCD_WR_DATA(Ypos&0XFF);			
	}else
	{
		if(lcddev.dir==1)Xpos=lcddev.width-1-Xpos;//锟斤拷锟斤拷锟斤拷实锟斤拷锟角碉拷转x,y锟斤拷锟斤拷
		LCD_WriteReg(lcddev.setxcmd, Xpos);
		LCD_WriteReg(lcddev.setycmd, Ypos);
	}	 
} 		 
//锟斤拷锟斤拷LCD锟斤拷锟皆讹拷扫锟借方锟斤拷
//注锟斤拷:锟斤拷锟斤拷锟斤拷锟斤拷锟斤拷锟杰伙拷锟杰碉拷锟剿猴拷锟斤拷锟斤拷锟矫碉拷影锟斤拷(锟斤拷锟斤拷锟斤拷9341/6804锟斤拷锟斤拷锟斤拷锟斤拷锟斤拷),
//锟斤拷锟斤拷,一锟斤拷锟斤拷锟斤拷为L2R_U2D锟斤拷锟斤拷,锟斤拷锟斤拷锟斤拷锟轿锟斤拷锟斤拷扫锟借方式,锟斤拷锟杰碉拷锟斤拷锟斤拷示锟斤拷锟斤拷锟斤拷.
//dir:0~7,锟斤拷锟斤拷8锟斤拷锟斤拷锟斤拷(锟斤拷锟藉定锟斤拷锟絣cd.h)
//9320/9325/9328/4531/4535/1505/b505/5408/9341/5310/5510/1963锟斤拷IC锟窖撅拷实锟绞诧拷锟斤拷	   	   
void LCD_Scan_Dir(u8 dir)
{
	u16 regval=0;
	u16 dirreg=0;
	u16 temp;  
	if((lcddev.dir==1&&lcddev.id!=0X6804&&lcddev.id!=0X1963)||(lcddev.dir==0&&lcddev.id==0X1963))//锟斤拷锟斤拷时锟斤拷锟斤拷6804锟斤拷1963锟斤拷锟侥憋拷扫锟借方锟斤拷锟斤拷锟斤拷时1963锟侥变方锟斤拷
	{			   
		switch(dir)//锟斤拷锟斤拷转锟斤拷
		{
			case 0:dir=6;break;
			case 1:dir=7;break;
			case 2:dir=4;break;
			case 3:dir=5;break;
			case 4:dir=1;break;
			case 5:dir=0;break;
			case 6:dir=3;break;
			case 7:dir=2;break;	     
		}
	} 
	if(lcddev.id==0x9341||lcddev.id==0X6804||lcddev.id==0X5310||lcddev.id==0X5510||lcddev.id==0X1963)//9341/6804/5310/5510/1963,锟斤拷锟解处锟斤拷
	{
		switch(dir)
		{
			case L2R_U2D://锟斤拷锟斤拷锟斤拷,锟斤拷锟较碉拷锟斤拷
				if(lcddev.id==0X9341)regval|=(1<<7)|(1<<6)|(0<<5);else regval|=(0<<7)|(0<<6)|(0<<5);
				break;
			case L2R_D2U://锟斤拷锟斤拷锟斤拷,锟斤拷锟铰碉拷锟斤拷
				regval|=(1<<7)|(0<<6)|(0<<5); 
				break;
			case R2L_U2D://锟斤拷锟揭碉拷锟斤拷,锟斤拷锟较碉拷锟斤拷
				regval|=(0<<7)|(1<<6)|(0<<5); 
				break;
			case R2L_D2U://锟斤拷锟揭碉拷锟斤拷,锟斤拷锟铰碉拷锟斤拷
				regval|=(1<<7)|(1<<6)|(0<<5); 
				break;	 
			case U2D_L2R://锟斤拷锟较碉拷锟斤拷,锟斤拷锟斤拷锟斤拷
				regval|=(0<<7)|(0<<6)|(1<<5); 
				break;
			case U2D_R2L://锟斤拷锟较碉拷锟斤拷,锟斤拷锟揭碉拷锟斤拷
				regval|=(0<<7)|(1<<6)|(1<<5); 
				break;
			case D2U_L2R://锟斤拷锟铰碉拷锟斤拷,锟斤拷锟斤拷锟斤拷
				regval|=(1<<7)|(0<<6)|(1<<5); 
				break;
			case D2U_R2L://锟斤拷锟铰碉拷锟斤拷,锟斤拷锟揭碉拷锟斤拷
				regval|=(1<<7)|(1<<6)|(1<<5); 
				break;	 
		}
		if(lcddev.id==0X5510)dirreg=0X3600;
		else dirreg=0X36;
 		if((lcddev.id!=0X5310)&&(lcddev.id!=0X5510)&&(lcddev.id!=0X1963))regval|=0X08;//5310/5510/1963锟斤拷锟斤拷要BGR   
		if(lcddev.id==0X6804)regval|=0x02;//6804锟斤拷BIT6锟斤拷9341锟侥凤拷锟斤拷	   
		LCD_WriteReg(dirreg,regval);
		if(lcddev.id!=0X1963&&lcddev.id!=0X9341)//9341: skip swap, display mapping is identity at MADCTL=0xA8
		{
			if(regval&0X20)
			{
				if(lcddev.width<lcddev.height)//锟斤拷锟斤拷X,Y
				{
					temp=lcddev.width;
					lcddev.width=lcddev.height;
					lcddev.height=temp;
				}
			}else  
			{
				if(lcddev.width>lcddev.height)//锟斤拷锟斤拷X,Y
				{
					temp=lcddev.width;
					lcddev.width=lcddev.height;
					lcddev.height=temp;
				}
			}  
		}
		if(lcddev.id==0X5510)
		{
			LCD_WR_REG(lcddev.setxcmd);LCD_WR_DATA(0); 
			LCD_WR_REG(lcddev.setxcmd+1);LCD_WR_DATA(0); 
			LCD_WR_REG(lcddev.setxcmd+2);LCD_WR_DATA((lcddev.width-1)>>8); 
			LCD_WR_REG(lcddev.setxcmd+3);LCD_WR_DATA((lcddev.width-1)&0XFF); 
			LCD_WR_REG(lcddev.setycmd);LCD_WR_DATA(0); 
			LCD_WR_REG(lcddev.setycmd+1);LCD_WR_DATA(0); 
			LCD_WR_REG(lcddev.setycmd+2);LCD_WR_DATA((lcddev.height-1)>>8); 
			LCD_WR_REG(lcddev.setycmd+3);LCD_WR_DATA((lcddev.height-1)&0XFF);
		}else
		{
			LCD_WR_REG(lcddev.setxcmd); 
			LCD_WR_DATA(0);LCD_WR_DATA(0);
			LCD_WR_DATA((lcddev.height-1)>>8);LCD_WR_DATA((lcddev.height-1)&0XFF);
			LCD_WR_REG(lcddev.setycmd); 
			LCD_WR_DATA(0);LCD_WR_DATA(0);
			LCD_WR_DATA((lcddev.width-1)>>8);LCD_WR_DATA((lcddev.width-1)&0XFF);  
		}
  	}else 
	{
		switch(dir)
		{
			case L2R_U2D://锟斤拷锟斤拷锟斤拷,锟斤拷锟较碉拷锟斤拷
				regval|=(1<<5)|(1<<4)|(0<<3); 
				break;
			case L2R_D2U://锟斤拷锟斤拷锟斤拷,锟斤拷锟铰碉拷锟斤拷
				regval|=(0<<5)|(1<<4)|(0<<3); 
				break;
			case R2L_U2D://锟斤拷锟揭碉拷锟斤拷,锟斤拷锟较碉拷锟斤拷
				regval|=(1<<5)|(0<<4)|(0<<3);
				break;
			case R2L_D2U://锟斤拷锟揭碉拷锟斤拷,锟斤拷锟铰碉拷锟斤拷
				regval|=(0<<5)|(0<<4)|(0<<3); 
				break;	 
			case U2D_L2R://锟斤拷锟较碉拷锟斤拷,锟斤拷锟斤拷锟斤拷
				regval|=(1<<5)|(1<<4)|(1<<3); 
				break;
			case U2D_R2L://锟斤拷锟较碉拷锟斤拷,锟斤拷锟揭碉拷锟斤拷
				regval|=(1<<5)|(0<<4)|(1<<3); 
				break;
			case D2U_L2R://锟斤拷锟铰碉拷锟斤拷,锟斤拷锟斤拷锟斤拷
				regval|=(0<<5)|(1<<4)|(1<<3); 
				break;
			case D2U_R2L://锟斤拷锟铰碉拷锟斤拷,锟斤拷锟揭碉拷锟斤拷
				regval|=(0<<5)|(0<<4)|(1<<3); 
				break;	 
		} 
		dirreg=0X03;
		regval|=1<<12; 
		LCD_WriteReg(dirreg,regval);
	}
}     
//锟斤拷锟斤拷
//x,y:锟斤拷锟斤拷
//POINT_COLOR:锟剿碉拷锟斤拷锟缴
void LCD_DrawPoint(u16 x,u16 y)
{
	LCD_SetCursor(x,y);		//锟斤拷锟矫癸拷锟轿伙拷锟 
	LCD_WriteRAM_Prepare();	//锟斤拷始写锟斤拷GRAM
	LCD->LCD_RAM=POINT_COLOR; 
}
//锟斤拷锟劫伙拷锟斤拷
//x,y:锟斤拷锟斤拷
//color:锟斤拷色
void LCD_Fast_DrawPoint(u16 x,u16 y,u16 color)
{
	if(lcddev.id==0X9341)color=~color;	//stuck inversion: software complement
	if(lcddev.id==0X9341||lcddev.id==0X5310)
	{
		LCD_WR_REG(lcddev.setxcmd); 
		LCD_WR_DATA(x>>8);LCD_WR_DATA(x&0XFF);  			 
		LCD_WR_REG(lcddev.setycmd); 
		LCD_WR_DATA(y>>8);LCD_WR_DATA(y&0XFF); 		 	 
	}else if(lcddev.id==0X5510)
	{
		LCD_WR_REG(lcddev.setxcmd);LCD_WR_DATA(x>>8);  
		LCD_WR_REG(lcddev.setxcmd+1);LCD_WR_DATA(x&0XFF);	  
		LCD_WR_REG(lcddev.setycmd);LCD_WR_DATA(y>>8);  
		LCD_WR_REG(lcddev.setycmd+1);LCD_WR_DATA(y&0XFF); 
	}else if(lcddev.id==0X1963)
	{
		if(lcddev.dir==0)x=lcddev.width-1-x;
		LCD_WR_REG(lcddev.setxcmd); 
		LCD_WR_DATA(x>>8);LCD_WR_DATA(x&0XFF); 		
		LCD_WR_DATA(x>>8);LCD_WR_DATA(x&0XFF); 		
		LCD_WR_REG(lcddev.setycmd); 
		LCD_WR_DATA(y>>8);LCD_WR_DATA(y&0XFF); 		
		LCD_WR_DATA(y>>8);LCD_WR_DATA(y&0XFF); 		
	}else if(lcddev.id==0X6804)
	{		    
		if(lcddev.dir==1)x=lcddev.width-1-x;//锟斤拷锟斤拷时锟斤拷锟斤拷
		LCD_WR_REG(lcddev.setxcmd); 
		LCD_WR_DATA(x>>8);LCD_WR_DATA(x&0XFF);			 
		LCD_WR_REG(lcddev.setycmd); 
		LCD_WR_DATA(y>>8);LCD_WR_DATA(y&0XFF); 		
	}else
	{
 		if(lcddev.dir==1)x=lcddev.width-1-x;//锟斤拷锟斤拷锟斤拷实锟斤拷锟角碉拷转x,y锟斤拷锟斤拷
		LCD_WriteReg(lcddev.setxcmd,x);
		LCD_WriteReg(lcddev.setycmd,y);
	}			 
	LCD->LCD_REG=lcddev.wramcmd; 
	LCD->LCD_RAM=color; 
}	 
//SSD1963 锟斤拷锟斤拷锟斤拷锟斤拷
//pwm:锟斤拷锟斤拷燃锟,0~100.越锟斤拷越锟斤拷.
void LCD_SSD_BackLightSet(u8 pwm)
{	
	LCD_WR_REG(0xBE);	//锟斤拷锟斤拷PWM锟斤拷锟
	LCD_WR_DATA(0x05);	//1锟斤拷锟斤拷PWM频锟斤拷
	LCD_WR_DATA(pwm*2.55);//2锟斤拷锟斤拷PWM占锟秸憋拷
	LCD_WR_DATA(0x01);	//3锟斤拷锟斤拷C
	LCD_WR_DATA(0xFF);	//4锟斤拷锟斤拷D
	LCD_WR_DATA(0x00);	//5锟斤拷锟斤拷E
	LCD_WR_DATA(0x00);	//6锟斤拷锟斤拷F
}

//锟斤拷锟斤拷LCD锟斤拷示锟斤拷锟斤拷
//dir:0,锟斤拷锟斤拷锟斤拷1,锟斤拷锟斤拷
void LCD_Display_Dir(u8 dir)
{
	if(dir==0)			//锟斤拷锟斤拷
	{
		lcddev.dir=0;	//锟斤拷锟斤拷
		lcddev.width=240;
		lcddev.height=320;
		if(lcddev.id==0X9341){lcddev.width=320;lcddev.height=240;}	//landscape 320x240 for thermal imager
		if(lcddev.id==0X9341||lcddev.id==0X6804||lcddev.id==0X5310)
		{
			lcddev.wramcmd=0X2C;
	 		lcddev.setxcmd=0X2A;
			lcddev.setycmd=0X2B;  	 
			if(lcddev.id==0X6804||lcddev.id==0X5310)
			{
				lcddev.width=320;
				lcddev.height=480;
			}
		}else if(lcddev.id==0x5510)
		{
			lcddev.wramcmd=0X2C00;
	 		lcddev.setxcmd=0X2A00;
			lcddev.setycmd=0X2B00; 
			lcddev.width=480;
			lcddev.height=800;
		}else if(lcddev.id==0X1963)
		{
			lcddev.wramcmd=0X2C;	//锟斤拷锟斤拷写锟斤拷GRAM锟斤拷指锟斤拷 
			lcddev.setxcmd=0X2B;	//锟斤拷锟斤拷写X锟斤拷锟斤拷指锟斤拷
			lcddev.setycmd=0X2A;	//锟斤拷锟斤拷写Y锟斤拷锟斤拷指锟斤拷
			lcddev.width=480;		//锟斤拷锟矫匡拷锟斤拷480
			lcddev.height=800;		//锟斤拷锟矫高讹拷800  
		}else
		{
			lcddev.wramcmd=0X22;
	 		lcddev.setxcmd=0X20;
			lcddev.setycmd=0X21;  
		}
	}else 				//锟斤拷锟斤拷
	{	  				
		lcddev.dir=1;	//锟斤拷锟斤拷
		lcddev.width=320;
		lcddev.height=240;
		if(lcddev.id==0X9341||lcddev.id==0X5310)
		{
			lcddev.wramcmd=0X2C;
	 		lcddev.setxcmd=0X2A;
			lcddev.setycmd=0X2B;  	 
		}else if(lcddev.id==0X6804)	 
		{
 			lcddev.wramcmd=0X2C;
	 		lcddev.setxcmd=0X2B;
			lcddev.setycmd=0X2A; 
		}else if(lcddev.id==0x5510)
		{
			lcddev.wramcmd=0X2C00;
	 		lcddev.setxcmd=0X2A00;
			lcddev.setycmd=0X2B00; 
			lcddev.width=800;
			lcddev.height=480;
		}else if(lcddev.id==0X1963)
		{
			lcddev.wramcmd=0X2C;	//锟斤拷锟斤拷写锟斤拷GRAM锟斤拷指锟斤拷 
			lcddev.setxcmd=0X2A;	//锟斤拷锟斤拷写X锟斤拷锟斤拷指锟斤拷
			lcddev.setycmd=0X2B;	//锟斤拷锟斤拷写Y锟斤拷锟斤拷指锟斤拷
			lcddev.width=800;		//锟斤拷锟矫匡拷锟斤拷800
			lcddev.height=480;		//锟斤拷锟矫高讹拷480  
		}else
		{
			lcddev.wramcmd=0X22;
	 		lcddev.setxcmd=0X21;
			lcddev.setycmd=0X20;  
		}
		if(lcddev.id==0X6804||lcddev.id==0X5310)
		{ 	 
			lcddev.width=480;
			lcddev.height=320; 			
		}
	} 
	if(lcddev.id==0X9341)LCD_WriteReg(0X36,0XC8);	//belt&braces: hw landscape, MY=1+MX=1
	LCD_Scan_Dir(DFT_SCAN_DIR);	//默锟斤拷扫锟借方锟斤拷
}	 
//锟斤拷锟矫达拷锟斤拷,锟斤拷锟皆讹拷锟斤拷锟矫伙拷锟斤拷锟斤拷锟疥到锟斤拷锟斤拷锟斤拷锟较斤拷(sx,sy).
//sx,sy:锟斤拷锟斤拷锟斤拷始锟斤拷锟斤拷(锟斤拷锟较斤拷)
//width,height:锟斤拷锟节匡拷锟饺和高讹拷,锟斤拷锟斤拷锟斤拷锟0!!
//锟斤拷锟斤拷锟叫:width*height. 
void LCD_Set_Window(u16 sx,u16 sy,u16 width,u16 height)
{    
	u8 hsareg,heareg,vsareg,veareg;
	u16 hsaval,heaval,vsaval,veaval; 
	u16 twidth,theight;
	twidth=sx+width-1;
	theight=sy+height-1;
	if(lcddev.id==0X9341||lcddev.id==0X5310||lcddev.id==0X6804||(lcddev.dir==1&&lcddev.id==0X1963))
	{
		LCD_WR_REG(lcddev.setxcmd); 
		LCD_WR_DATA(sx>>8); 
		LCD_WR_DATA(sx&0XFF);	 
		LCD_WR_DATA(twidth>>8); 
		LCD_WR_DATA(twidth&0XFF);  
		LCD_WR_REG(lcddev.setycmd); 
		LCD_WR_DATA(sy>>8); 
		LCD_WR_DATA(sy&0XFF); 
		LCD_WR_DATA(theight>>8); 
		LCD_WR_DATA(theight&0XFF); 
	}else if(lcddev.id==0X1963)//1963锟斤拷锟斤拷锟斤拷锟解处锟斤拷
	{
		sx=lcddev.width-width-sx; 
		height=sy+height-1; 
		LCD_WR_REG(lcddev.setxcmd); 
		LCD_WR_DATA(sx>>8); 
		LCD_WR_DATA(sx&0XFF);	 
		LCD_WR_DATA((sx+width-1)>>8); 
		LCD_WR_DATA((sx+width-1)&0XFF);  
		LCD_WR_REG(lcddev.setycmd); 
		LCD_WR_DATA(sy>>8); 
		LCD_WR_DATA(sy&0XFF); 
		LCD_WR_DATA(height>>8); 
		LCD_WR_DATA(height&0XFF); 		
	}else if(lcddev.id==0X5510)
	{
		LCD_WR_REG(lcddev.setxcmd);LCD_WR_DATA(sx>>8);  
		LCD_WR_REG(lcddev.setxcmd+1);LCD_WR_DATA(sx&0XFF);	  
		LCD_WR_REG(lcddev.setxcmd+2);LCD_WR_DATA(twidth>>8);   
		LCD_WR_REG(lcddev.setxcmd+3);LCD_WR_DATA(twidth&0XFF);   
		LCD_WR_REG(lcddev.setycmd);LCD_WR_DATA(sy>>8);   
		LCD_WR_REG(lcddev.setycmd+1);LCD_WR_DATA(sy&0XFF);  
		LCD_WR_REG(lcddev.setycmd+2);LCD_WR_DATA(theight>>8);   
		LCD_WR_REG(lcddev.setycmd+3);LCD_WR_DATA(theight&0XFF);  
	}else	//锟斤拷锟斤拷锟斤拷锟斤拷IC
	{
		if(lcddev.dir==1)//锟斤拷锟斤拷
		{
			//锟斤拷锟斤拷值
			hsaval=sy;				
			heaval=theight;
			vsaval=lcddev.width-twidth-1;
			veaval=lcddev.width-sx-1;				
		}else
		{ 
			hsaval=sx;				
			heaval=twidth;
			vsaval=sy;
			veaval=theight;
		} 
		hsareg=0X50;heareg=0X51;//水平锟斤拷锟津窗口寄达拷锟斤拷
		vsareg=0X52;veareg=0X53;//锟斤拷直锟斤拷锟津窗口寄达拷锟斤拷	   							  
		//锟斤拷锟矫寄达拷锟斤拷值
		LCD_WriteReg(hsareg,hsaval);
		LCD_WriteReg(heareg,heaval);
		LCD_WriteReg(vsareg,vsaval);
		LCD_WriteReg(veareg,veaval);		
		LCD_SetCursor(sx,sy);	//锟斤拷锟矫癸拷锟轿伙拷锟
	}
}
//锟斤拷始锟斤拷lcd
//锟矫筹拷始锟斤拷锟斤拷锟斤拷锟斤拷锟皆筹拷始锟斤拷锟斤拷锟斤拷ILI93XX液锟斤拷,锟斤拷锟斤拷锟斤拷锟斤拷锟斤拷锟斤拷锟角伙拷锟斤拷ILI9320锟斤拷!!!
//锟斤拷锟斤拷锟斤拷锟酵号碉拷锟斤拷锟斤拷芯片锟斤拷没锟叫诧拷锟斤拷! 
void LCD_Init(void)
{ 					
 	GPIO_InitTypeDef GPIO_InitStructure;
	FSMC_NORSRAMInitTypeDef  FSMC_NORSRAMInitStructure;
  FSMC_NORSRAMTimingInitTypeDef  readWriteTiming; 
	FSMC_NORSRAMTimingInitTypeDef  writeTiming;
	
  RCC_AHBPeriphClockCmd(RCC_AHBPeriph_FSMC,ENABLE);	//使锟斤拷FSMC时锟斤拷
	RCC_APB2PeriphClockCmd(RCC_APB2Periph_GPIOB|RCC_APB2Periph_GPIOD|RCC_APB2Periph_GPIOE|RCC_APB2Periph_GPIOG,ENABLE);//使锟斤拷PORTB,D,E,G锟皆硷拷AFIO锟斤拷锟矫癸拷锟斤拷时锟斤拷

 
 	GPIO_InitStructure.GPIO_Pin = GPIO_Pin_0;				 //PB0 锟斤拷锟斤拷锟斤拷锟 锟斤拷锟斤拷
 	GPIO_InitStructure.GPIO_Mode = GPIO_Mode_Out_PP; 		 //锟斤拷锟斤拷锟斤拷锟
 	GPIO_InitStructure.GPIO_Speed = GPIO_Speed_50MHz;
 	GPIO_Init(GPIOB, &GPIO_InitStructure);
	
 	//PORTD锟斤拷锟斤拷锟斤拷锟斤拷锟斤拷锟  
	GPIO_InitStructure.GPIO_Pin = GPIO_Pin_0|GPIO_Pin_1|GPIO_Pin_4|GPIO_Pin_5|GPIO_Pin_8|GPIO_Pin_9|GPIO_Pin_10|GPIO_Pin_14|GPIO_Pin_15;				 //	//PORTD锟斤拷锟斤拷锟斤拷锟斤拷锟斤拷锟  
 	GPIO_InitStructure.GPIO_Mode = GPIO_Mode_AF_PP; 		 //锟斤拷锟斤拷锟斤拷锟斤拷锟斤拷锟   
 	GPIO_InitStructure.GPIO_Speed = GPIO_Speed_50MHz;
 	GPIO_Init(GPIOD, &GPIO_InitStructure); 
  	 
	//PORTE锟斤拷锟斤拷锟斤拷锟斤拷锟斤拷锟  
	GPIO_InitStructure.GPIO_Pin = GPIO_Pin_7|GPIO_Pin_8|GPIO_Pin_9|GPIO_Pin_10|GPIO_Pin_11|GPIO_Pin_12|GPIO_Pin_13|GPIO_Pin_14|GPIO_Pin_15;				 //	//PORTD锟斤拷锟斤拷锟斤拷锟斤拷锟斤拷锟  
 	GPIO_InitStructure.GPIO_Mode = GPIO_Mode_AF_PP; 		 //锟斤拷锟斤拷锟斤拷锟斤拷锟斤拷锟   
 	GPIO_InitStructure.GPIO_Speed = GPIO_Speed_50MHz;
 	GPIO_Init(GPIOE, &GPIO_InitStructure);    	    	 											 

   	//	//PORTG12锟斤拷锟斤拷锟斤拷锟斤拷锟斤拷锟 A0	
	GPIO_InitStructure.GPIO_Pin = GPIO_Pin_0|GPIO_Pin_12;	 //	//PORTD锟斤拷锟斤拷锟斤拷锟斤拷锟斤拷锟  
 	GPIO_InitStructure.GPIO_Mode = GPIO_Mode_AF_PP; 		 //锟斤拷锟斤拷锟斤拷锟斤拷锟斤拷锟   
 	GPIO_InitStructure.GPIO_Speed = GPIO_Speed_50MHz;
 	GPIO_Init(GPIOG, &GPIO_InitStructure); 

	readWriteTiming.FSMC_AddressSetupTime = 0x0F;	 //锟斤拷址锟斤拷锟斤拷时锟戒（ADDSET锟斤拷为2锟斤拷HCLK 1/36M=27ns
  readWriteTiming.FSMC_AddressHoldTime = 0x00;	 //锟斤拷址锟斤拷锟斤拷时锟戒（ADDHLD锟斤拷模式A未锟矫碉拷	
  readWriteTiming.FSMC_DataSetupTime = 0x0f;		 // 锟斤拷锟捷憋拷锟斤拷时锟斤拷为16锟斤拷HCLK,锟斤拷为液锟斤拷锟斤拷锟斤拷IC锟侥讹拷锟斤拷锟捷碉拷时锟斤拷锟劫度诧拷锟斤拷太锟届，锟斤拷锟斤拷锟1289锟斤拷锟絀C锟斤拷
  readWriteTiming.FSMC_BusTurnAroundDuration = 0x00;
  readWriteTiming.FSMC_CLKDivision = 0x00;
  readWriteTiming.FSMC_DataLatency = 0x00;
  readWriteTiming.FSMC_AccessMode = FSMC_AccessMode_A;	 //模式A 
    

	writeTiming.FSMC_AddressSetupTime = 0x01;	 //锟斤拷址锟斤拷锟斤拷时锟戒（ADDSET锟斤拷为1锟斤拷HCLK  
  writeTiming.FSMC_AddressHoldTime = 0x00;	 //锟斤拷址锟斤拷锟斤拷时锟戒（A		
  writeTiming.FSMC_DataSetupTime = 0x02;		 ////锟斤拷锟捷憋拷锟斤拷时锟斤拷为4锟斤拷HCLK	
  writeTiming.FSMC_BusTurnAroundDuration = 0x00;
  writeTiming.FSMC_CLKDivision = 0x00;
  writeTiming.FSMC_DataLatency = 0x00;
  writeTiming.FSMC_AccessMode = FSMC_AccessMode_A;	 //模式A 

 
  FSMC_NORSRAMInitStructure.FSMC_Bank = FSMC_Bank1_NORSRAM4;//  锟斤拷锟斤拷锟斤拷锟斤拷使锟斤拷NE4 锟斤拷也锟酵讹拷应BTCR[6],[7]锟斤拷
  FSMC_NORSRAMInitStructure.FSMC_DataAddressMux = FSMC_DataAddressMux_Disable; // 锟斤拷锟斤拷锟斤拷锟斤拷锟捷碉拷址
  FSMC_NORSRAMInitStructure.FSMC_MemoryType =FSMC_MemoryType_SRAM;// FSMC_MemoryType_SRAM;  //SRAM   
  FSMC_NORSRAMInitStructure.FSMC_MemoryDataWidth = FSMC_MemoryDataWidth_16b;//锟芥储锟斤拷锟斤拷锟捷匡拷锟斤拷为16bit   
  FSMC_NORSRAMInitStructure.FSMC_BurstAccessMode =FSMC_BurstAccessMode_Disable;// FSMC_BurstAccessMode_Disable; 
  FSMC_NORSRAMInitStructure.FSMC_WaitSignalPolarity = FSMC_WaitSignalPolarity_Low;
	FSMC_NORSRAMInitStructure.FSMC_AsynchronousWait=FSMC_AsynchronousWait_Disable; 
  FSMC_NORSRAMInitStructure.FSMC_WrapMode = FSMC_WrapMode_Disable;   
  FSMC_NORSRAMInitStructure.FSMC_WaitSignalActive = FSMC_WaitSignalActive_BeforeWaitState;  
  FSMC_NORSRAMInitStructure.FSMC_WriteOperation = FSMC_WriteOperation_Enable;	//  锟芥储锟斤拷写使锟斤拷
  FSMC_NORSRAMInitStructure.FSMC_WaitSignal = FSMC_WaitSignal_Disable;   
  FSMC_NORSRAMInitStructure.FSMC_ExtendedMode = FSMC_ExtendedMode_Enable; // 锟斤拷写使锟矫诧拷同锟斤拷时锟斤拷
  FSMC_NORSRAMInitStructure.FSMC_WriteBurst = FSMC_WriteBurst_Disable; 
  FSMC_NORSRAMInitStructure.FSMC_ReadWriteTimingStruct = &readWriteTiming; //锟斤拷写时锟斤拷
  FSMC_NORSRAMInitStructure.FSMC_WriteTimingStruct = &writeTiming;  //写时锟斤拷

  FSMC_NORSRAMInit(&FSMC_NORSRAMInitStructure);  //锟斤拷始锟斤拷FSMC锟斤拷锟斤拷

 	FSMC_NORSRAMCmd(FSMC_Bank1_NORSRAM4, ENABLE);  // 使锟斤拷BANK1 
		
 
	delay_ms(50); 					// delay 50 ms 
  	lcddev.id=LCD_ReadReg(0x0000);	//锟斤拷ID锟斤拷9320/9325/9328/4531/4535锟斤拷IC锟斤拷   
  	if(lcddev.id<0XFF||lcddev.id==0XFFFF||lcddev.id==0X9300)//锟斤拷锟斤拷ID锟斤拷锟斤拷确,锟斤拷锟斤拷lcddev.id==0X9300锟叫断ｏ拷锟斤拷为9341锟斤拷未锟斤拷锟斤拷位锟斤拷锟斤拷锟斤拷禄岜伙拷锟斤拷锟9300
	{	
 		//锟斤拷锟斤拷9341 ID锟侥讹拷取		
		LCD_WR_REG(0XD3);				   
		lcddev.id=LCD_RD_DATA();	//dummy read 	
 		lcddev.id=LCD_RD_DATA();	//锟斤拷锟斤拷0X00
  		lcddev.id=LCD_RD_DATA();   	//锟斤拷取93								   
 		lcddev.id<<=8;
		lcddev.id|=LCD_RD_DATA();  	//锟斤拷取41 	   			   
 		if(lcddev.id!=0X9341)		//锟斤拷9341,锟斤拷锟斤拷锟角诧拷锟斤拷6804
		{	
 			LCD_WR_REG(0XBF);				   
			lcddev.id=LCD_RD_DATA(); 	//dummy read 	 
	 		lcddev.id=LCD_RD_DATA();   	//锟斤拷锟斤拷0X01			   
	 		lcddev.id=LCD_RD_DATA(); 	//锟斤拷锟斤拷0XD0 			  	
	  		lcddev.id=LCD_RD_DATA();	//锟斤拷锟斤拷锟斤拷锟0X68 
			lcddev.id<<=8;
	  		lcddev.id|=LCD_RD_DATA();	//锟斤拷锟斤拷锟斤拷锟0X04	  
			if(lcddev.id!=0X6804)		//也锟斤拷锟斤拷6804,锟斤拷锟皆匡拷锟斤拷锟角诧拷锟斤拷NT35310
			{ 
				LCD_WR_REG(0XD4);				   
				lcddev.id=LCD_RD_DATA();//dummy read  
				lcddev.id=LCD_RD_DATA();//锟斤拷锟斤拷0X01	 
				lcddev.id=LCD_RD_DATA();//锟斤拷锟斤拷0X53	
				lcddev.id<<=8;	 
				lcddev.id|=LCD_RD_DATA();	//锟斤拷锟斤拷锟斤拷锟0X10	 
				if(lcddev.id!=0X5310)		//也锟斤拷锟斤拷NT35310,锟斤拷锟皆匡拷锟斤拷锟角诧拷锟斤拷NT35510
				{
					LCD_WR_REG(0XDA00);	
					lcddev.id=LCD_RD_DATA();		//锟斤拷锟斤拷0X00	 
					LCD_WR_REG(0XDB00);	
					lcddev.id=LCD_RD_DATA();		//锟斤拷锟斤拷0X80
					lcddev.id<<=8;	
					LCD_WR_REG(0XDC00);	
					lcddev.id|=LCD_RD_DATA();		//锟斤拷锟斤拷0X00		
					if(lcddev.id==0x8000)lcddev.id=0x5510;//NT35510锟斤拷锟截碉拷ID锟斤拷8000H,为锟斤拷锟斤拷锟斤拷锟斤拷,锟斤拷锟斤拷强锟斤拷锟斤拷锟斤拷为5510
					if(lcddev.id!=0X5510)			//也锟斤拷锟斤拷NT5510,锟斤拷锟皆匡拷锟斤拷锟角诧拷锟斤拷SSD1963
					{
						LCD_WR_REG(0XA1);
						lcddev.id=LCD_RD_DATA();
						lcddev.id=LCD_RD_DATA();	//锟斤拷锟斤拷0X57
						lcddev.id<<=8;	 
						lcddev.id|=LCD_RD_DATA();	//锟斤拷锟斤拷0X61	
						if(lcddev.id==0X5761)lcddev.id=0X1963;//SSD1963锟斤拷锟截碉拷ID锟斤拷5761H,为锟斤拷锟斤拷锟斤拷锟斤拷,锟斤拷锟斤拷强锟斤拷锟斤拷锟斤拷为1963
					}
				}
			}
 		}  	
	} 
 	printf(" LCD ID:%x\r\n",lcddev.id);
	if(lcddev.id==0XA1A1||lcddev.id==0X0000||lcddev.id==0XFFFF)//compat: force unknown ID to 9341
	{
		printf(" force id -> 9341\r\n");
		lcddev.id=0X9341;
	} //锟斤拷印LCD ID   
	if(lcddev.id==0X9341)	//9341锟斤拷始锟斤拷
	{	 
		LCD_WR_REG(0xCF);  
		LCD_WR_DATA(0x00); 
		LCD_WR_DATA(0xC1); 
		LCD_WR_DATA(0X30); 
		LCD_WR_REG(0xED);  
		LCD_WR_DATA(0x64); 
		LCD_WR_DATA(0x03); 
		LCD_WR_DATA(0X12); 
		LCD_WR_DATA(0X81); 
		LCD_WR_REG(0xE8);  
		LCD_WR_DATA(0x85); 
		LCD_WR_DATA(0x10); 
		LCD_WR_DATA(0x7A); 
		LCD_WR_REG(0xCB);  
		LCD_WR_DATA(0x39); 
		LCD_WR_DATA(0x2C); 
		LCD_WR_DATA(0x00); 
		LCD_WR_DATA(0x34); 
		LCD_WR_DATA(0x02); 
		LCD_WR_REG(0xF7);  
		LCD_WR_DATA(0x20); 
		LCD_WR_REG(0xEA);  
		LCD_WR_DATA(0x00); 
		LCD_WR_DATA(0x00); 
		LCD_WR_REG(0xC0);    //Power control 
		LCD_WR_DATA(0x1B);   //VRH[5:0] 
		LCD_WR_REG(0xC1);    //Power control 
		LCD_WR_DATA(0x01);   //SAP[2:0];BT[3:0] 
		LCD_WR_REG(0xC5);    //VCM control 
		LCD_WR_DATA(0x30); 	 //3F
		LCD_WR_DATA(0x30); 	 //3C
		LCD_WR_REG(0xC7);    //VCM control2 
		LCD_WR_DATA(0XB7); 
		LCD_WR_REG(0x36);    // Memory Access Control 
		LCD_WR_DATA(0xC8);   //hw landscape: MY=1+MX=1, MV=0 (MY un-mirrors horizontal, MX un-flips vertical)
		LCD_WR_REG(0x3A);   
		LCD_WR_DATA(0x55); 
		LCD_WR_REG(0xB1);   
		LCD_WR_DATA(0x00);   
		LCD_WR_DATA(0x1A); 
		LCD_WR_REG(0xB6);    // Display Function Control 
		LCD_WR_DATA(0x0A); 
		LCD_WR_DATA(0xA2); 
		LCD_WR_REG(0xF2);    // 3Gamma Function Disable 
		LCD_WR_DATA(0x00); 
		LCD_WR_REG(0x26);    //Gamma curve selected 
		LCD_WR_DATA(0x01); 
		LCD_WR_REG(0xE0);    //Set Gamma 
		LCD_WR_DATA(0x0F); 
		LCD_WR_DATA(0x2A); 
		LCD_WR_DATA(0x28); 
		LCD_WR_DATA(0x08); 
		LCD_WR_DATA(0x0E); 
		LCD_WR_DATA(0x08); 
		LCD_WR_DATA(0x54); 
		LCD_WR_DATA(0XA9); 
		LCD_WR_DATA(0x43); 
		LCD_WR_DATA(0x0A); 
		LCD_WR_DATA(0x0F); 
		LCD_WR_DATA(0x00); 
		LCD_WR_DATA(0x00); 
		LCD_WR_DATA(0x00); 
		LCD_WR_DATA(0x00); 		 
		LCD_WR_REG(0XE1);    //Set Gamma 
		LCD_WR_DATA(0x00); 
		LCD_WR_DATA(0x15); 
		LCD_WR_DATA(0x17); 
		LCD_WR_DATA(0x07); 
		LCD_WR_DATA(0x11); 
		LCD_WR_DATA(0x06); 
		LCD_WR_DATA(0x2B); 
		LCD_WR_DATA(0x56); 
		LCD_WR_DATA(0x3C); 
		LCD_WR_DATA(0x05); 
		LCD_WR_DATA(0x10); 
		LCD_WR_DATA(0x0F); 
		LCD_WR_DATA(0x3F); 
		LCD_WR_DATA(0x3F); 
		LCD_WR_DATA(0x0F); 
		LCD_WR_REG(0x2B); 
		LCD_WR_DATA(0x00);
		LCD_WR_DATA(0x00);
		LCD_WR_DATA(0x00);
		LCD_WR_DATA(0xef);
		LCD_WR_REG(0x2A); 
		LCD_WR_DATA(0x00);
		LCD_WR_DATA(0x00);
		LCD_WR_DATA(0x01);
		LCD_WR_DATA(0x3f);	 
		LCD_WR_REG(0x33);   //VSCRDEF: vertical scroll disable, TFA=0 VSA=320 BFA=0
	LCD_WR_DATA(0x00);
	LCD_WR_DATA(0x00);
	LCD_WR_DATA(0x00);
	LCD_WR_DATA(0xF0);
	LCD_WR_DATA(0x00);
	LCD_WR_DATA(0x00);
	LCD_WR_REG(0x37);   //VSCRSADD: scroll offset = 0
	LCD_WR_DATA(0x00);
	LCD_WR_DATA(0x00);
	LCD_WR_REG(0x30);   //PTLAR: partial area = full screen (purge stuck partial state)
	LCD_WR_DATA(0x00);LCD_WR_DATA(0x00);	//SC=0
	LCD_WR_DATA(0x01);LCD_WR_DATA(0x3F);	//EC=319(hw landscape)
	LCD_WR_DATA(0x00);LCD_WR_DATA(0x00);	//SP=0
	LCD_WR_DATA(0x00);LCD_WR_DATA(0xEF);	//EP=239(hw landscape)
	//0x12 removed: Partial Mode ON poisoned this panel's state machine (freeze zones)
	LCD_WR_REG(0x13);   //Normal Display Mode ON
	LCD_WR_REG(0x11); //Exit Sleep
		delay_ms(120);
		LCD_WR_REG(0x29); //display on	
	}else if(lcddev.id==0x6804) //6804锟斤拷始锟斤拷
	{
		LCD_WR_REG(0X11);
		delay_ms(20);
		LCD_WR_REG(0XD0);//VCI1  VCL  VGH  VGL DDVDH VREG1OUT power amplitude setting
		LCD_WR_DATA(0X07); 
		LCD_WR_DATA(0X42); 
		LCD_WR_DATA(0X1D); 
		LCD_WR_REG(0XD1);//VCOMH VCOM_AC amplitude setting
		LCD_WR_DATA(0X00);
		LCD_WR_DATA(0X1a);
		LCD_WR_DATA(0X09); 
		LCD_WR_REG(0XD2);//Operational Amplifier Circuit Constant Current Adjust , charge pump frequency setting
		LCD_WR_DATA(0X01);
		LCD_WR_DATA(0X22);
		LCD_WR_REG(0XC0);//REV SM GS 
		LCD_WR_DATA(0X10);
		LCD_WR_DATA(0X3B);
		LCD_WR_DATA(0X00);
		LCD_WR_DATA(0X02);
		LCD_WR_DATA(0X11);
		
		LCD_WR_REG(0XC5);// Frame rate setting = 72HZ  when setting 0x03
		LCD_WR_DATA(0X03);
		
		LCD_WR_REG(0XC8);//Gamma setting
		LCD_WR_DATA(0X00);
		LCD_WR_DATA(0X25);
		LCD_WR_DATA(0X21);
		LCD_WR_DATA(0X05);
		LCD_WR_DATA(0X00);
		LCD_WR_DATA(0X0a);
		LCD_WR_DATA(0X65);
		LCD_WR_DATA(0X25);
		LCD_WR_DATA(0X77);
		LCD_WR_DATA(0X50);
		LCD_WR_DATA(0X0f);
		LCD_WR_DATA(0X00);	  
						  
   		LCD_WR_REG(0XF8);
		LCD_WR_DATA(0X01);	  

 		LCD_WR_REG(0XFE);
 		LCD_WR_DATA(0X00);
 		LCD_WR_DATA(0X02);
		
		LCD_WR_REG(0X20);//Exit invert mode

		LCD_WR_REG(0X36);
		LCD_WR_DATA(0X08);//原锟斤拷锟斤拷a
		
		LCD_WR_REG(0X3A);
		LCD_WR_DATA(0X55);//16位模式	  
		LCD_WR_REG(0X2B);
		LCD_WR_DATA(0X00);
		LCD_WR_DATA(0X00);
		LCD_WR_DATA(0X01);
		LCD_WR_DATA(0X3F);
		
		LCD_WR_REG(0X2A);
		LCD_WR_DATA(0X00);
		LCD_WR_DATA(0X00);
		LCD_WR_DATA(0X01);
		LCD_WR_DATA(0XDF);
		delay_ms(120);
		LCD_WR_REG(0X29); 	 
 	}else if(lcddev.id==0x5310)
	{ 
		LCD_WR_REG(0xED);
		LCD_WR_DATA(0x01);
		LCD_WR_DATA(0xFE);

		LCD_WR_REG(0xEE);
		LCD_WR_DATA(0xDE);
		LCD_WR_DATA(0x21);

		LCD_WR_REG(0xF1);
		LCD_WR_DATA(0x01);
		LCD_WR_REG(0xDF);
		LCD_WR_DATA(0x10);

		//VCOMvoltage//
		LCD_WR_REG(0xC4);
		LCD_WR_DATA(0x8F);	  //5f

		LCD_WR_REG(0xC6);
		LCD_WR_DATA(0x00);
		LCD_WR_DATA(0xE2);
		LCD_WR_DATA(0xE2);
		LCD_WR_DATA(0xE2);
		LCD_WR_REG(0xBF);
		LCD_WR_DATA(0xAA);

		LCD_WR_REG(0xB0);
		LCD_WR_DATA(0x0D);
		LCD_WR_DATA(0x00);
		LCD_WR_DATA(0x0D);
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

		LCD_WR_REG(0xF3);
		LCD_WR_DATA(0x00);

		LCD_WR_REG(0xF9);
		LCD_WR_DATA(0x06);
		LCD_WR_DATA(0x10);
		LCD_WR_DATA(0x29);
		LCD_WR_DATA(0x00);

		LCD_WR_REG(0x3A);
		LCD_WR_DATA(0x55);	//66

		LCD_WR_REG(0x11);
		delay_ms(100);
		LCD_WR_REG(0x29);
		LCD_WR_REG(0x35);
		LCD_WR_DATA(0x00);

		LCD_WR_REG(0x51);
		LCD_WR_DATA(0xFF);
		LCD_WR_REG(0x53);
		LCD_WR_DATA(0x2C);
		LCD_WR_REG(0x55);
		LCD_WR_DATA(0x82);
		LCD_WR_REG(0x2c);
	}else if(lcddev.id==0x5510)
	{
		LCD_WriteReg(0xF000,0x55);
		LCD_WriteReg(0xF001,0xAA);
		LCD_WriteReg(0xF002,0x52);
		LCD_WriteReg(0xF003,0x08);
		LCD_WriteReg(0xF004,0x01);
		//AVDD Set AVDD 5.2V
		LCD_WriteReg(0xB000,0x0D);
		LCD_WriteReg(0xB001,0x0D);
		LCD_WriteReg(0xB002,0x0D);
		//AVDD ratio
		LCD_WriteReg(0xB600,0x34);
		LCD_WriteReg(0xB601,0x34);
		LCD_WriteReg(0xB602,0x34);
		//AVEE -5.2V
		LCD_WriteReg(0xB100,0x0D);
		LCD_WriteReg(0xB101,0x0D);
		LCD_WriteReg(0xB102,0x0D);
		//AVEE ratio
		LCD_WriteReg(0xB700,0x34);
		LCD_WriteReg(0xB701,0x34);
		LCD_WriteReg(0xB702,0x34);
		//VCL -2.5V
		LCD_WriteReg(0xB200,0x00);
		LCD_WriteReg(0xB201,0x00);
		LCD_WriteReg(0xB202,0x00);
		//VCL ratio
		LCD_WriteReg(0xB800,0x24);
		LCD_WriteReg(0xB801,0x24);
		LCD_WriteReg(0xB802,0x24);
		//VGH 15V (Free pump)
		LCD_WriteReg(0xBF00,0x01);
		LCD_WriteReg(0xB300,0x0F);
		LCD_WriteReg(0xB301,0x0F);
		LCD_WriteReg(0xB302,0x0F);
		//VGH ratio
		LCD_WriteReg(0xB900,0x34);
		LCD_WriteReg(0xB901,0x34);
		LCD_WriteReg(0xB902,0x34);
		//VGL_REG -10V
		LCD_WriteReg(0xB500,0x08);
		LCD_WriteReg(0xB501,0x08);
		LCD_WriteReg(0xB502,0x08);
		LCD_WriteReg(0xC200,0x03);
		//VGLX ratio
		LCD_WriteReg(0xBA00,0x24);
		LCD_WriteReg(0xBA01,0x24);
		LCD_WriteReg(0xBA02,0x24);
		//VGMP/VGSP 4.5V/0V
		LCD_WriteReg(0xBC00,0x00);
		LCD_WriteReg(0xBC01,0x78);
		LCD_WriteReg(0xBC02,0x00);
		//VGMN/VGSN -4.5V/0V
		LCD_WriteReg(0xBD00,0x00);
		LCD_WriteReg(0xBD01,0x78);
		LCD_WriteReg(0xBD02,0x00);
		//VCOM
		LCD_WriteReg(0xBE00,0x00);
		LCD_WriteReg(0xBE01,0x64);
		//Gamma Setting
		LCD_WriteReg(0xD100,0x00);
		LCD_WriteReg(0xD101,0x33);
		LCD_WriteReg(0xD102,0x00);
		LCD_WriteReg(0xD103,0x34);
		LCD_WriteReg(0xD104,0x00);
		LCD_WriteReg(0xD105,0x3A);
		LCD_WriteReg(0xD106,0x00);
		LCD_WriteReg(0xD107,0x4A);
		LCD_WriteReg(0xD108,0x00);
		LCD_WriteReg(0xD109,0x5C);
		LCD_WriteReg(0xD10A,0x00);
		LCD_WriteReg(0xD10B,0x81);
		LCD_WriteReg(0xD10C,0x00);
		LCD_WriteReg(0xD10D,0xA6);
		LCD_WriteReg(0xD10E,0x00);
		LCD_WriteReg(0xD10F,0xE5);
		LCD_WriteReg(0xD110,0x01);
		LCD_WriteReg(0xD111,0x13);
		LCD_WriteReg(0xD112,0x01);
		LCD_WriteReg(0xD113,0x54);
		LCD_WriteReg(0xD114,0x01);
		LCD_WriteReg(0xD115,0x82);
		LCD_WriteReg(0xD116,0x01);
		LCD_WriteReg(0xD117,0xCA);
		LCD_WriteReg(0xD118,0x02);
		LCD_WriteReg(0xD119,0x00);
		LCD_WriteReg(0xD11A,0x02);
		LCD_WriteReg(0xD11B,0x01);
		LCD_WriteReg(0xD11C,0x02);
		LCD_WriteReg(0xD11D,0x34);
		LCD_WriteReg(0xD11E,0x02);
		LCD_WriteReg(0xD11F,0x67);
		LCD_WriteReg(0xD120,0x02);
		LCD_WriteReg(0xD121,0x84);
		LCD_WriteReg(0xD122,0x02);
		LCD_WriteReg(0xD123,0xA4);
		LCD_WriteReg(0xD124,0x02);
		LCD_WriteReg(0xD125,0xB7);
		LCD_WriteReg(0xD126,0x02);
		LCD_WriteReg(0xD127,0xCF);
		LCD_WriteReg(0xD128,0x02);
		LCD_WriteReg(0xD129,0xDE);
		LCD_WriteReg(0xD12A,0x02);
		LCD_WriteReg(0xD12B,0xF2);
		LCD_WriteReg(0xD12C,0x02);
		LCD_WriteReg(0xD12D,0xFE);
		LCD_WriteReg(0xD12E,0x03);
		LCD_WriteReg(0xD12F,0x10);
		LCD_WriteReg(0xD130,0x03);
		LCD_WriteReg(0xD131,0x33);
		LCD_WriteReg(0xD132,0x03);
		LCD_WriteReg(0xD133,0x6D);
		LCD_WriteReg(0xD200,0x00);
		LCD_WriteReg(0xD201,0x33);
		LCD_WriteReg(0xD202,0x00);
		LCD_WriteReg(0xD203,0x34);
		LCD_WriteReg(0xD204,0x00);
		LCD_WriteReg(0xD205,0x3A);
		LCD_WriteReg(0xD206,0x00);
		LCD_WriteReg(0xD207,0x4A);
		LCD_WriteReg(0xD208,0x00);
		LCD_WriteReg(0xD209,0x5C);
		LCD_WriteReg(0xD20A,0x00);

		LCD_WriteReg(0xD20B,0x81);
		LCD_WriteReg(0xD20C,0x00);
		LCD_WriteReg(0xD20D,0xA6);
		LCD_WriteReg(0xD20E,0x00);
		LCD_WriteReg(0xD20F,0xE5);
		LCD_WriteReg(0xD210,0x01);
		LCD_WriteReg(0xD211,0x13);
		LCD_WriteReg(0xD212,0x01);
		LCD_WriteReg(0xD213,0x54);
		LCD_WriteReg(0xD214,0x01);
		LCD_WriteReg(0xD215,0x82);
		LCD_WriteReg(0xD216,0x01);
		LCD_WriteReg(0xD217,0xCA);
		LCD_WriteReg(0xD218,0x02);
		LCD_WriteReg(0xD219,0x00);
		LCD_WriteReg(0xD21A,0x02);
		LCD_WriteReg(0xD21B,0x01);
		LCD_WriteReg(0xD21C,0x02);
		LCD_WriteReg(0xD21D,0x34);
		LCD_WriteReg(0xD21E,0x02);
		LCD_WriteReg(0xD21F,0x67);
		LCD_WriteReg(0xD220,0x02);
		LCD_WriteReg(0xD221,0x84);
		LCD_WriteReg(0xD222,0x02);
		LCD_WriteReg(0xD223,0xA4);
		LCD_WriteReg(0xD224,0x02);
		LCD_WriteReg(0xD225,0xB7);
		LCD_WriteReg(0xD226,0x02);
		LCD_WriteReg(0xD227,0xCF);
		LCD_WriteReg(0xD228,0x02);
		LCD_WriteReg(0xD229,0xDE);
		LCD_WriteReg(0xD22A,0x02);
		LCD_WriteReg(0xD22B,0xF2);
		LCD_WriteReg(0xD22C,0x02);
		LCD_WriteReg(0xD22D,0xFE);
		LCD_WriteReg(0xD22E,0x03);
		LCD_WriteReg(0xD22F,0x10);
		LCD_WriteReg(0xD230,0x03);
		LCD_WriteReg(0xD231,0x33);
		LCD_WriteReg(0xD232,0x03);
		LCD_WriteReg(0xD233,0x6D);
		LCD_WriteReg(0xD300,0x00);
		LCD_WriteReg(0xD301,0x33);
		LCD_WriteReg(0xD302,0x00);
		LCD_WriteReg(0xD303,0x34);
		LCD_WriteReg(0xD304,0x00);
		LCD_WriteReg(0xD305,0x3A);
		LCD_WriteReg(0xD306,0x00);
		LCD_WriteReg(0xD307,0x4A);
		LCD_WriteReg(0xD308,0x00);
		LCD_WriteReg(0xD309,0x5C);
		LCD_WriteReg(0xD30A,0x00);

		LCD_WriteReg(0xD30B,0x81);
		LCD_WriteReg(0xD30C,0x00);
		LCD_WriteReg(0xD30D,0xA6);
		LCD_WriteReg(0xD30E,0x00);
		LCD_WriteReg(0xD30F,0xE5);
		LCD_WriteReg(0xD310,0x01);
		LCD_WriteReg(0xD311,0x13);
		LCD_WriteReg(0xD312,0x01);
		LCD_WriteReg(0xD313,0x54);
		LCD_WriteReg(0xD314,0x01);
		LCD_WriteReg(0xD315,0x82);
		LCD_WriteReg(0xD316,0x01);
		LCD_WriteReg(0xD317,0xCA);
		LCD_WriteReg(0xD318,0x02);
		LCD_WriteReg(0xD319,0x00);
		LCD_WriteReg(0xD31A,0x02);
		LCD_WriteReg(0xD31B,0x01);
		LCD_WriteReg(0xD31C,0x02);
		LCD_WriteReg(0xD31D,0x34);
		LCD_WriteReg(0xD31E,0x02);
		LCD_WriteReg(0xD31F,0x67);
		LCD_WriteReg(0xD320,0x02);
		LCD_WriteReg(0xD321,0x84);
		LCD_WriteReg(0xD322,0x02);
		LCD_WriteReg(0xD323,0xA4);
		LCD_WriteReg(0xD324,0x02);
		LCD_WriteReg(0xD325,0xB7);
		LCD_WriteReg(0xD326,0x02);
		LCD_WriteReg(0xD327,0xCF);
		LCD_WriteReg(0xD328,0x02);
		LCD_WriteReg(0xD329,0xDE);
		LCD_WriteReg(0xD32A,0x02);
		LCD_WriteReg(0xD32B,0xF2);
		LCD_WriteReg(0xD32C,0x02);
		LCD_WriteReg(0xD32D,0xFE);
		LCD_WriteReg(0xD32E,0x03);
		LCD_WriteReg(0xD32F,0x10);
		LCD_WriteReg(0xD330,0x03);
		LCD_WriteReg(0xD331,0x33);
		LCD_WriteReg(0xD332,0x03);
		LCD_WriteReg(0xD333,0x6D);
		LCD_WriteReg(0xD400,0x00);
		LCD_WriteReg(0xD401,0x33);
		LCD_WriteReg(0xD402,0x00);
		LCD_WriteReg(0xD403,0x34);
		LCD_WriteReg(0xD404,0x00);
		LCD_WriteReg(0xD405,0x3A);
		LCD_WriteReg(0xD406,0x00);
		LCD_WriteReg(0xD407,0x4A);
		LCD_WriteReg(0xD408,0x00);
		LCD_WriteReg(0xD409,0x5C);
		LCD_WriteReg(0xD40A,0x00);
		LCD_WriteReg(0xD40B,0x81);

		LCD_WriteReg(0xD40C,0x00);
		LCD_WriteReg(0xD40D,0xA6);
		LCD_WriteReg(0xD40E,0x00);
		LCD_WriteReg(0xD40F,0xE5);
		LCD_WriteReg(0xD410,0x01);
		LCD_WriteReg(0xD411,0x13);
		LCD_WriteReg(0xD412,0x01);
		LCD_WriteReg(0xD413,0x54);
		LCD_WriteReg(0xD414,0x01);
		LCD_WriteReg(0xD415,0x82);
		LCD_WriteReg(0xD416,0x01);
		LCD_WriteReg(0xD417,0xCA);
		LCD_WriteReg(0xD418,0x02);
		LCD_WriteReg(0xD419,0x00);
		LCD_WriteReg(0xD41A,0x02);
		LCD_WriteReg(0xD41B,0x01);
		LCD_WriteReg(0xD41C,0x02);
		LCD_WriteReg(0xD41D,0x34);
		LCD_WriteReg(0xD41E,0x02);
		LCD_WriteReg(0xD41F,0x67);
		LCD_WriteReg(0xD420,0x02);
		LCD_WriteReg(0xD421,0x84);
		LCD_WriteReg(0xD422,0x02);
		LCD_WriteReg(0xD423,0xA4);
		LCD_WriteReg(0xD424,0x02);
		LCD_WriteReg(0xD425,0xB7);
		LCD_WriteReg(0xD426,0x02);
		LCD_WriteReg(0xD427,0xCF);
		LCD_WriteReg(0xD428,0x02);
		LCD_WriteReg(0xD429,0xDE);
		LCD_WriteReg(0xD42A,0x02);
		LCD_WriteReg(0xD42B,0xF2);
		LCD_WriteReg(0xD42C,0x02);
		LCD_WriteReg(0xD42D,0xFE);
		LCD_WriteReg(0xD42E,0x03);
		LCD_WriteReg(0xD42F,0x10);
		LCD_WriteReg(0xD430,0x03);
		LCD_WriteReg(0xD431,0x33);
		LCD_WriteReg(0xD432,0x03);
		LCD_WriteReg(0xD433,0x6D);
		LCD_WriteReg(0xD500,0x00);
		LCD_WriteReg(0xD501,0x33);
		LCD_WriteReg(0xD502,0x00);
		LCD_WriteReg(0xD503,0x34);
		LCD_WriteReg(0xD504,0x00);
		LCD_WriteReg(0xD505,0x3A);
		LCD_WriteReg(0xD506,0x00);
		LCD_WriteReg(0xD507,0x4A);
		LCD_WriteReg(0xD508,0x00);
		LCD_WriteReg(0xD509,0x5C);
		LCD_WriteReg(0xD50A,0x00);
		LCD_WriteReg(0xD50B,0x81);

		LCD_WriteReg(0xD50C,0x00);
		LCD_WriteReg(0xD50D,0xA6);
		LCD_WriteReg(0xD50E,0x00);
		LCD_WriteReg(0xD50F,0xE5);
		LCD_WriteReg(0xD510,0x01);
		LCD_WriteReg(0xD511,0x13);
		LCD_WriteReg(0xD512,0x01);
		LCD_WriteReg(0xD513,0x54);
		LCD_WriteReg(0xD514,0x01);
		LCD_WriteReg(0xD515,0x82);
		LCD_WriteReg(0xD516,0x01);
		LCD_WriteReg(0xD517,0xCA);
		LCD_WriteReg(0xD518,0x02);
		LCD_WriteReg(0xD519,0x00);
		LCD_WriteReg(0xD51A,0x02);
		LCD_WriteReg(0xD51B,0x01);
		LCD_WriteReg(0xD51C,0x02);
		LCD_WriteReg(0xD51D,0x34);
		LCD_WriteReg(0xD51E,0x02);
		LCD_WriteReg(0xD51F,0x67);
		LCD_WriteReg(0xD520,0x02);
		LCD_WriteReg(0xD521,0x84);
		LCD_WriteReg(0xD522,0x02);
		LCD_WriteReg(0xD523,0xA4);
		LCD_WriteReg(0xD524,0x02);
		LCD_WriteReg(0xD525,0xB7);
		LCD_WriteReg(0xD526,0x02);
		LCD_WriteReg(0xD527,0xCF);
		LCD_WriteReg(0xD528,0x02);
		LCD_WriteReg(0xD529,0xDE);
		LCD_WriteReg(0xD52A,0x02);
		LCD_WriteReg(0xD52B,0xF2);
		LCD_WriteReg(0xD52C,0x02);
		LCD_WriteReg(0xD52D,0xFE);
		LCD_WriteReg(0xD52E,0x03);
		LCD_WriteReg(0xD52F,0x10);
		LCD_WriteReg(0xD530,0x03);
		LCD_WriteReg(0xD531,0x33);
		LCD_WriteReg(0xD532,0x03);
		LCD_WriteReg(0xD533,0x6D);
		LCD_WriteReg(0xD600,0x00);
		LCD_WriteReg(0xD601,0x33);
		LCD_WriteReg(0xD602,0x00);
		LCD_WriteReg(0xD603,0x34);
		LCD_WriteReg(0xD604,0x00);
		LCD_WriteReg(0xD605,0x3A);
		LCD_WriteReg(0xD606,0x00);
		LCD_WriteReg(0xD607,0x4A);
		LCD_WriteReg(0xD608,0x00);
		LCD_WriteReg(0xD609,0x5C);
		LCD_WriteReg(0xD60A,0x00);
		LCD_WriteReg(0xD60B,0x81);

		LCD_WriteReg(0xD60C,0x00);
		LCD_WriteReg(0xD60D,0xA6);
		LCD_WriteReg(0xD60E,0x00);
		LCD_WriteReg(0xD60F,0xE5);
		LCD_WriteReg(0xD610,0x01);
		LCD_WriteReg(0xD611,0x13);
		LCD_WriteReg(0xD612,0x01);
		LCD_WriteReg(0xD613,0x54);
		LCD_WriteReg(0xD614,0x01);
		LCD_WriteReg(0xD615,0x82);
		LCD_WriteReg(0xD616,0x01);
		LCD_WriteReg(0xD617,0xCA);
		LCD_WriteReg(0xD618,0x02);
		LCD_WriteReg(0xD619,0x00);
		LCD_WriteReg(0xD61A,0x02);
		LCD_WriteReg(0xD61B,0x01);
		LCD_WriteReg(0xD61C,0x02);
		LCD_WriteReg(0xD61D,0x34);
		LCD_WriteReg(0xD61E,0x02);
		LCD_WriteReg(0xD61F,0x67);
		LCD_WriteReg(0xD620,0x02);
		LCD_WriteReg(0xD621,0x84);
		LCD_WriteReg(0xD622,0x02);
		LCD_WriteReg(0xD623,0xA4);
		LCD_WriteReg(0xD624,0x02);
		LCD_WriteReg(0xD625,0xB7);
		LCD_WriteReg(0xD626,0x02);
		LCD_WriteReg(0xD627,0xCF);
		LCD_WriteReg(0xD628,0x02);
		LCD_WriteReg(0xD629,0xDE);
		LCD_WriteReg(0xD62A,0x02);
		LCD_WriteReg(0xD62B,0xF2);
		LCD_WriteReg(0xD62C,0x02);
		LCD_WriteReg(0xD62D,0xFE);
		LCD_WriteReg(0xD62E,0x03);
		LCD_WriteReg(0xD62F,0x10);
		LCD_WriteReg(0xD630,0x03);
		LCD_WriteReg(0xD631,0x33);
		LCD_WriteReg(0xD632,0x03);
		LCD_WriteReg(0xD633,0x6D);
		//LV2 Page 0 enable
		LCD_WriteReg(0xF000,0x55);
		LCD_WriteReg(0xF001,0xAA);
		LCD_WriteReg(0xF002,0x52);
		LCD_WriteReg(0xF003,0x08);
		LCD_WriteReg(0xF004,0x00);
		//Display control
		LCD_WriteReg(0xB100, 0xCC);
		LCD_WriteReg(0xB101, 0x00);
		//Source hold time
		LCD_WriteReg(0xB600,0x05);
		//Gate EQ control
		LCD_WriteReg(0xB700,0x70);
		LCD_WriteReg(0xB701,0x70);
		//Source EQ control (Mode 2)
		LCD_WriteReg(0xB800,0x01);
		LCD_WriteReg(0xB801,0x03);
		LCD_WriteReg(0xB802,0x03);
		LCD_WriteReg(0xB803,0x03);
		//Inversion mode (2-dot)
		LCD_WriteReg(0xBC00,0x02);
		LCD_WriteReg(0xBC01,0x00);
		LCD_WriteReg(0xBC02,0x00);
		//Timing control 4H w/ 4-delay
		LCD_WriteReg(0xC900,0xD0);
		LCD_WriteReg(0xC901,0x02);
		LCD_WriteReg(0xC902,0x50);
		LCD_WriteReg(0xC903,0x50);
		LCD_WriteReg(0xC904,0x50);
		LCD_WriteReg(0x3500,0x00);
		LCD_WriteReg(0x3A00,0x55);  //16-bit/pixel
		LCD_WR_REG(0x1100);
		delay_us(120);
		LCD_WR_REG(0x2900);
	}else if(lcddev.id==0x9325)//9325
	{
		LCD_WriteReg(0x00E5,0x78F0); 
		LCD_WriteReg(0x0001,0x0100); 
		LCD_WriteReg(0x0002,0x0700); 
		LCD_WriteReg(0x0003,0x1030); 
		LCD_WriteReg(0x0004,0x0000); 
		LCD_WriteReg(0x0008,0x0202);  
		LCD_WriteReg(0x0009,0x0000);
		LCD_WriteReg(0x000A,0x0000); 
		LCD_WriteReg(0x000C,0x0000); 
		LCD_WriteReg(0x000D,0x0000);
		LCD_WriteReg(0x000F,0x0000);
		//power on sequence VGHVGL
		LCD_WriteReg(0x0010,0x0000);   
		LCD_WriteReg(0x0011,0x0007);  
		LCD_WriteReg(0x0012,0x0000);  
		LCD_WriteReg(0x0013,0x0000); 
		LCD_WriteReg(0x0007,0x0000); 
		//vgh 
		LCD_WriteReg(0x0010,0x1690);   
		LCD_WriteReg(0x0011,0x0227);
		//delayms(100);
		//vregiout 
		LCD_WriteReg(0x0012,0x009D); //0x001b
		//delayms(100); 
		//vom amplitude
		LCD_WriteReg(0x0013,0x1900);
		//delayms(100); 
		//vom H
		LCD_WriteReg(0x0029,0x0025); 
		LCD_WriteReg(0x002B,0x000D); 
		//gamma
		LCD_WriteReg(0x0030,0x0007);
		LCD_WriteReg(0x0031,0x0303);
		LCD_WriteReg(0x0032,0x0003);// 0006
		LCD_WriteReg(0x0035,0x0206);
		LCD_WriteReg(0x0036,0x0008);
		LCD_WriteReg(0x0037,0x0406); 
		LCD_WriteReg(0x0038,0x0304);//0200
		LCD_WriteReg(0x0039,0x0007); 
		LCD_WriteReg(0x003C,0x0602);// 0504
		LCD_WriteReg(0x003D,0x0008); 
		//ram
		LCD_WriteReg(0x0050,0x0000); 
		LCD_WriteReg(0x0051,0x00EF);
		LCD_WriteReg(0x0052,0x0000); 
		LCD_WriteReg(0x0053,0x013F);  
		LCD_WriteReg(0x0060,0xA700); 
		LCD_WriteReg(0x0061,0x0001); 
		LCD_WriteReg(0x006A,0x0000); 
		//
		LCD_WriteReg(0x0080,0x0000); 
		LCD_WriteReg(0x0081,0x0000); 
		LCD_WriteReg(0x0082,0x0000); 
		LCD_WriteReg(0x0083,0x0000); 
		LCD_WriteReg(0x0084,0x0000); 
		LCD_WriteReg(0x0085,0x0000); 
		//
		LCD_WriteReg(0x0090,0x0010); 
		LCD_WriteReg(0x0092,0x0600); 
		
		LCD_WriteReg(0x0007,0x0133);
		LCD_WriteReg(0x00,0x0022);//
	}else if(lcddev.id==0x9328)//ILI9328   OK  
	{
  		LCD_WriteReg(0x00EC,0x108F);// internal timeing      
 		LCD_WriteReg(0x00EF,0x1234);// ADD        
		//LCD_WriteReg(0x00e7,0x0010);      
        //LCD_WriteReg(0x0000,0x0001);//锟斤拷锟斤拷锟节诧拷时锟斤拷
        LCD_WriteReg(0x0001,0x0100);     
        LCD_WriteReg(0x0002,0x0700);//锟斤拷源锟斤拷锟斤拷                    
		//LCD_WriteReg(0x0003,(1<<3)|(1<<4) ); 	//65K  RGB
		//DRIVE TABLE(锟侥达拷锟斤拷 03H)
		//BIT3=AM BIT4:5=ID0:1
		//AM ID0 ID1   FUNCATION
		// 0  0   0	   R->L D->U
		// 1  0   0	   D->U	R->L
		// 0  1   0	   L->R D->U
		// 1  1   0    D->U	L->R
		// 0  0   1	   R->L U->D
		// 1  0   1    U->D	R->L
		// 0  1   1    L->R U->D 锟斤拷锟斤拷锟斤拷锟斤拷锟斤拷锟.
		// 1  1   1	   U->D	L->R
        LCD_WriteReg(0x0003,(1<<12)|(3<<4)|(0<<3) );//65K    
        LCD_WriteReg(0x0004,0x0000);                                   
        LCD_WriteReg(0x0008,0x0202);	           
        LCD_WriteReg(0x0009,0x0000);         
        LCD_WriteReg(0x000a,0x0000);//display setting         
        LCD_WriteReg(0x000c,0x0001);//display setting          
        LCD_WriteReg(0x000d,0x0000);//0f3c          
        LCD_WriteReg(0x000f,0x0000);
		//锟斤拷源锟斤拷锟斤拷
        LCD_WriteReg(0x0010,0x0000);   
        LCD_WriteReg(0x0011,0x0007);
        LCD_WriteReg(0x0012,0x0000);                                                                 
        LCD_WriteReg(0x0013,0x0000);                 
     	LCD_WriteReg(0x0007,0x0001);                 
       	delay_ms(50); 
        LCD_WriteReg(0x0010,0x1490);   
        LCD_WriteReg(0x0011,0x0227);
        delay_ms(50); 
        LCD_WriteReg(0x0012,0x008A);                  
        delay_ms(50); 
        LCD_WriteReg(0x0013,0x1a00);   
        LCD_WriteReg(0x0029,0x0006);
        LCD_WriteReg(0x002b,0x000d);
        delay_ms(50); 
        LCD_WriteReg(0x0020,0x0000);                                                            
        LCD_WriteReg(0x0021,0x0000);           
		delay_ms(50); 
		//伽锟斤拷校锟斤拷
        LCD_WriteReg(0x0030,0x0000); 
        LCD_WriteReg(0x0031,0x0604);   
        LCD_WriteReg(0x0032,0x0305);
        LCD_WriteReg(0x0035,0x0000);
        LCD_WriteReg(0x0036,0x0C09); 
        LCD_WriteReg(0x0037,0x0204);
        LCD_WriteReg(0x0038,0x0301);        
        LCD_WriteReg(0x0039,0x0707);     
        LCD_WriteReg(0x003c,0x0000);
        LCD_WriteReg(0x003d,0x0a0a);
        delay_ms(50); 
        LCD_WriteReg(0x0050,0x0000); //水平GRAM锟斤拷始位锟斤拷 
        LCD_WriteReg(0x0051,0x00ef); //水平GRAM锟斤拷止位锟斤拷                    
        LCD_WriteReg(0x0052,0x0000); //锟斤拷直GRAM锟斤拷始位锟斤拷                    
        LCD_WriteReg(0x0053,0x013f); //锟斤拷直GRAM锟斤拷止位锟斤拷  
 
         LCD_WriteReg(0x0060,0xa700);        
        LCD_WriteReg(0x0061,0x0001); 
        LCD_WriteReg(0x006a,0x0000);
        LCD_WriteReg(0x0080,0x0000);
        LCD_WriteReg(0x0081,0x0000);
        LCD_WriteReg(0x0082,0x0000);
        LCD_WriteReg(0x0083,0x0000);
        LCD_WriteReg(0x0084,0x0000);
        LCD_WriteReg(0x0085,0x0000);
      
        LCD_WriteReg(0x0090,0x0010);     
        LCD_WriteReg(0x0092,0x0600);  
        //锟斤拷锟斤拷锟斤拷示锟斤拷锟斤拷    
        LCD_WriteReg(0x0007,0x0133); 
	}else if(lcddev.id==0x9320)//锟斤拷锟斤拷OK.
	{
		LCD_WriteReg(0x00,0x0000);
		LCD_WriteReg(0x01,0x0100);	//Driver Output Contral.
		LCD_WriteReg(0x02,0x0700);	//LCD Driver Waveform Contral.
		LCD_WriteReg(0x03,0x1030);//Entry Mode Set.
		//LCD_WriteReg(0x03,0x1018);	//Entry Mode Set.
	
		LCD_WriteReg(0x04,0x0000);	//Scalling Contral.
		LCD_WriteReg(0x08,0x0202);	//Display Contral 2.(0x0207)
		LCD_WriteReg(0x09,0x0000);	//Display Contral 3.(0x0000)
		LCD_WriteReg(0x0a,0x0000);	//Frame Cycle Contal.(0x0000)
		LCD_WriteReg(0x0c,(1<<0));	//Extern Display Interface Contral 1.(0x0000)
		LCD_WriteReg(0x0d,0x0000);	//Frame Maker Position.
		LCD_WriteReg(0x0f,0x0000);	//Extern Display Interface Contral 2.	    
		delay_ms(50); 
		LCD_WriteReg(0x07,0x0101);	//Display Contral.
		delay_ms(50); 								  
		LCD_WriteReg(0x10,(1<<12)|(0<<8)|(1<<7)|(1<<6)|(0<<4));	//Power Control 1.(0x16b0)
		LCD_WriteReg(0x11,0x0007);								//Power Control 2.(0x0001)
		LCD_WriteReg(0x12,(1<<8)|(1<<4)|(0<<0));				//Power Control 3.(0x0138)
		LCD_WriteReg(0x13,0x0b00);								//Power Control 4.
		LCD_WriteReg(0x29,0x0000);								//Power Control 7.
	
		LCD_WriteReg(0x2b,(1<<14)|(1<<4));	    
		LCD_WriteReg(0x50,0);	//Set X Star
		//水平GRAM锟斤拷止位锟斤拷Set X End.
		LCD_WriteReg(0x51,239);	//Set Y Star
		LCD_WriteReg(0x52,0);	//Set Y End.t.
		LCD_WriteReg(0x53,319);	//
	
		LCD_WriteReg(0x60,0x2700);	//Driver Output Control.
		LCD_WriteReg(0x61,0x0001);	//Driver Output Control.
		LCD_WriteReg(0x6a,0x0000);	//Vertical Srcoll Control.
	
		LCD_WriteReg(0x80,0x0000);	//Display Position? Partial Display 1.
		LCD_WriteReg(0x81,0x0000);	//RAM Address Start? Partial Display 1.
		LCD_WriteReg(0x82,0x0000);	//RAM Address End-Partial Display 1.
		LCD_WriteReg(0x83,0x0000);	//Displsy Position? Partial Display 2.
		LCD_WriteReg(0x84,0x0000);	//RAM Address Start? Partial Display 2.
		LCD_WriteReg(0x85,0x0000);	//RAM Address End? Partial Display 2.
	
		LCD_WriteReg(0x90,(0<<7)|(16<<0));	//Frame Cycle Contral.(0x0013)
		LCD_WriteReg(0x92,0x0000);	//Panel Interface Contral 2.(0x0000)
		LCD_WriteReg(0x93,0x0001);	//Panel Interface Contral 3.
		LCD_WriteReg(0x95,0x0110);	//Frame Cycle Contral.(0x0110)
		LCD_WriteReg(0x97,(0<<8));	//
		LCD_WriteReg(0x98,0x0000);	//Frame Cycle Contral.	   
		LCD_WriteReg(0x07,0x0173);	//(0x0173)
	}else if(lcddev.id==0X9331)//OK |/|/|			 
	{
		LCD_WriteReg(0x00E7, 0x1014);
		LCD_WriteReg(0x0001, 0x0100); // set SS and SM bit
		LCD_WriteReg(0x0002, 0x0200); // set 1 line inversion
        LCD_WriteReg(0x0003,(1<<12)|(3<<4)|(1<<3));//65K    
		//LCD_WriteReg(0x0003, 0x1030); // set GRAM write direction and BGR=1.
		LCD_WriteReg(0x0008, 0x0202); // set the back porch and front porch
		LCD_WriteReg(0x0009, 0x0000); // set non-display area refresh cycle ISC[3:0]
		LCD_WriteReg(0x000A, 0x0000); // FMARK function
		LCD_WriteReg(0x000C, 0x0000); // RGB interface setting
		LCD_WriteReg(0x000D, 0x0000); // Frame marker Position
		LCD_WriteReg(0x000F, 0x0000); // RGB interface polarity
		//*************Power On sequence ****************//
		LCD_WriteReg(0x0010, 0x0000); // SAP, BT[3:0], AP, DSTB, SLP, STB
		LCD_WriteReg(0x0011, 0x0007); // DC1[2:0], DC0[2:0], VC[2:0]
		LCD_WriteReg(0x0012, 0x0000); // VREG1OUT voltage
		LCD_WriteReg(0x0013, 0x0000); // VDV[4:0] for VCOM amplitude
		delay_ms(200); // Dis-charge capacitor power voltage
		LCD_WriteReg(0x0010, 0x1690); // SAP, BT[3:0], AP, DSTB, SLP, STB
		LCD_WriteReg(0x0011, 0x0227); // DC1[2:0], DC0[2:0], VC[2:0]
		delay_ms(50); // Delay 50ms
		LCD_WriteReg(0x0012, 0x000C); // Internal reference voltage= Vci;
		delay_ms(50); // Delay 50ms
		LCD_WriteReg(0x0013, 0x0800); // Set VDV[4:0] for VCOM amplitude
		LCD_WriteReg(0x0029, 0x0011); // Set VCM[5:0] for VCOMH
		LCD_WriteReg(0x002B, 0x000B); // Set Frame Rate
		delay_ms(50); // Delay 50ms
		LCD_WriteReg(0x0020, 0x0000); // GRAM horizontal Address
		LCD_WriteReg(0x0021, 0x013f); // GRAM Vertical Address
		// ----------- Adjust the Gamma Curve ----------//
		LCD_WriteReg(0x0030, 0x0000);
		LCD_WriteReg(0x0031, 0x0106);
		LCD_WriteReg(0x0032, 0x0000);
		LCD_WriteReg(0x0035, 0x0204);
		LCD_WriteReg(0x0036, 0x160A);
		LCD_WriteReg(0x0037, 0x0707);
		LCD_WriteReg(0x0038, 0x0106);
		LCD_WriteReg(0x0039, 0x0707);
		LCD_WriteReg(0x003C, 0x0402);
		LCD_WriteReg(0x003D, 0x0C0F);
		//------------------ Set GRAM area ---------------//
		LCD_WriteReg(0x0050, 0x0000); // Horizontal GRAM Start Address
		LCD_WriteReg(0x0051, 0x00EF); // Horizontal GRAM End Address
		LCD_WriteReg(0x0052, 0x0000); // Vertical GRAM Start Address
		LCD_WriteReg(0x0053, 0x013F); // Vertical GRAM Start Address
		LCD_WriteReg(0x0060, 0x2700); // Gate Scan Line
		LCD_WriteReg(0x0061, 0x0001); // NDL,VLE, REV 
		LCD_WriteReg(0x006A, 0x0000); // set scrolling line
		//-------------- Partial Display Control ---------//
		LCD_WriteReg(0x0080, 0x0000);
		LCD_WriteReg(0x0081, 0x0000);
		LCD_WriteReg(0x0082, 0x0000);
		LCD_WriteReg(0x0083, 0x0000);
		LCD_WriteReg(0x0084, 0x0000);
		LCD_WriteReg(0x0085, 0x0000);
		//-------------- Panel Control -------------------//
		LCD_WriteReg(0x0090, 0x0010);
		LCD_WriteReg(0x0092, 0x0600);
		LCD_WriteReg(0x0007, 0x0133); // 262K color and display ON
	}else if(lcddev.id==0x5408)
	{
		LCD_WriteReg(0x01,0x0100);								  
		LCD_WriteReg(0x02,0x0700);//LCD Driving Waveform Contral 
		LCD_WriteReg(0x03,0x1030);//Entry Mode锟斤拷锟斤拷 	   
		//指锟斤拷锟斤拷锟斤拷锟斤拷锟斤拷锟斤拷隙锟斤拷碌锟斤拷远锟斤拷锟侥Ｊ
		//Normal Mode(Window Mode disable)
		//RGB锟斤拷式
		//16位锟斤拷锟斤拷2锟轿达拷锟斤拷锟8锟斤拷锟斤拷锟斤拷锟斤拷
		LCD_WriteReg(0x04,0x0000); //Scalling Control register     
		LCD_WriteReg(0x08,0x0207); //Display Control 2 
		LCD_WriteReg(0x09,0x0000); //Display Control 3	 
		LCD_WriteReg(0x0A,0x0000); //Frame Cycle Control	 
		LCD_WriteReg(0x0C,0x0000); //External Display Interface Control 1 
		LCD_WriteReg(0x0D,0x0000); //Frame Maker Position		 
		LCD_WriteReg(0x0F,0x0000); //External Display Interface Control 2 
 		delay_ms(20);
		//TFT 液锟斤拷锟斤拷色图锟斤拷锟斤拷示锟斤拷锟斤拷14
		LCD_WriteReg(0x10,0x16B0); //0x14B0 //Power Control 1
		LCD_WriteReg(0x11,0x0001); //0x0007 //Power Control 2
		LCD_WriteReg(0x17,0x0001); //0x0000 //Power Control 3
		LCD_WriteReg(0x12,0x0138); //0x013B //Power Control 4
		LCD_WriteReg(0x13,0x0800); //0x0800 //Power Control 5
		LCD_WriteReg(0x29,0x0009); //NVM read data 2
		LCD_WriteReg(0x2a,0x0009); //NVM read data 3
		LCD_WriteReg(0xa4,0x0000);	 
		LCD_WriteReg(0x50,0x0000); //锟斤拷锟矫诧拷锟斤拷锟斤拷锟节碉拷X锟结开始锟斤拷
		LCD_WriteReg(0x51,0x00EF); //锟斤拷锟矫诧拷锟斤拷锟斤拷锟节碉拷X锟斤拷锟斤拷锟斤拷锟
		LCD_WriteReg(0x52,0x0000); //锟斤拷锟矫诧拷锟斤拷锟斤拷锟节碉拷Y锟结开始锟斤拷
		LCD_WriteReg(0x53,0x013F); //锟斤拷锟矫诧拷锟斤拷锟斤拷锟节碉拷Y锟斤拷锟斤拷锟斤拷锟
		LCD_WriteReg(0x60,0x2700); //Driver Output Control
		//锟斤拷锟斤拷锟斤拷幕锟侥碉拷锟斤拷锟皆硷拷扫锟斤拷锟斤拷锟绞硷拷锟
		LCD_WriteReg(0x61,0x0001); //Driver Output Control
		LCD_WriteReg(0x6A,0x0000); //Vertical Scroll Control
		LCD_WriteReg(0x80,0x0000); //Display Position 锟紺 Partial Display 1
		LCD_WriteReg(0x81,0x0000); //RAM Address Start 锟紺 Partial Display 1
		LCD_WriteReg(0x82,0x0000); //RAM address End - Partial Display 1
		LCD_WriteReg(0x83,0x0000); //Display Position 锟紺 Partial Display 2
		LCD_WriteReg(0x84,0x0000); //RAM Address Start 锟紺 Partial Display 2
		LCD_WriteReg(0x85,0x0000); //RAM address End 锟紺 Partail Display2
		LCD_WriteReg(0x90,0x0013); //Frame Cycle Control
		LCD_WriteReg(0x92,0x0000);  //Panel Interface Control 2
		LCD_WriteReg(0x93,0x0003); //Panel Interface control 3
		LCD_WriteReg(0x95,0x0110);  //Frame Cycle Control
		LCD_WriteReg(0x07,0x0173);		 
		delay_ms(50);
	}	
	else if(lcddev.id==0x1505)//OK
	{
		// second release on 3/5  ,luminance is acceptable,water wave appear during camera preview
        LCD_WriteReg(0x0007,0x0000);
        delay_ms(50); 
        LCD_WriteReg(0x0012,0x011C);//0x011A   why need to set several times?
        LCD_WriteReg(0x00A4,0x0001);//NVM	 
        LCD_WriteReg(0x0008,0x000F);
        LCD_WriteReg(0x000A,0x0008);
        LCD_WriteReg(0x000D,0x0008);	    
  		//伽锟斤拷校锟斤拷
        LCD_WriteReg(0x0030,0x0707);
        LCD_WriteReg(0x0031,0x0007); //0x0707
        LCD_WriteReg(0x0032,0x0603); 
        LCD_WriteReg(0x0033,0x0700); 
        LCD_WriteReg(0x0034,0x0202); 
        LCD_WriteReg(0x0035,0x0002); //?0x0606
        LCD_WriteReg(0x0036,0x1F0F);
        LCD_WriteReg(0x0037,0x0707); //0x0f0f  0x0105
        LCD_WriteReg(0x0038,0x0000); 
        LCD_WriteReg(0x0039,0x0000); 
        LCD_WriteReg(0x003A,0x0707); 
        LCD_WriteReg(0x003B,0x0000); //0x0303
        LCD_WriteReg(0x003C,0x0007); //?0x0707
        LCD_WriteReg(0x003D,0x0000); //0x1313//0x1f08
        delay_ms(50); 
        LCD_WriteReg(0x0007,0x0001);
        LCD_WriteReg(0x0017,0x0001);//锟斤拷锟斤拷锟斤拷源
        delay_ms(50); 
  		//锟斤拷源锟斤拷锟斤拷
        LCD_WriteReg(0x0010,0x17A0); 
        LCD_WriteReg(0x0011,0x0217);//reference voltage VC[2:0]   Vciout = 1.00*Vcivl
        LCD_WriteReg(0x0012,0x011E);//0x011c  //Vreg1out = Vcilvl*1.80   is it the same as Vgama1out ?
        LCD_WriteReg(0x0013,0x0F00);//VDV[4:0]-->VCOM Amplitude VcomL = VcomH - Vcom Ampl
        LCD_WriteReg(0x002A,0x0000);  
        LCD_WriteReg(0x0029,0x000A);//0x0001F  Vcomh = VCM1[4:0]*Vreg1out    gate source voltage??
        LCD_WriteReg(0x0012,0x013E);// 0x013C  power supply on
        //Coordinates Control//
        LCD_WriteReg(0x0050,0x0000);//0x0e00
        LCD_WriteReg(0x0051,0x00EF); 
        LCD_WriteReg(0x0052,0x0000); 
        LCD_WriteReg(0x0053,0x013F); 
    	//Pannel Image Control//
        LCD_WriteReg(0x0060,0x2700); 
        LCD_WriteReg(0x0061,0x0001); 
        LCD_WriteReg(0x006A,0x0000); 
        LCD_WriteReg(0x0080,0x0000); 
    	//Partial Image Control//
        LCD_WriteReg(0x0081,0x0000); 
        LCD_WriteReg(0x0082,0x0000); 
        LCD_WriteReg(0x0083,0x0000); 
        LCD_WriteReg(0x0084,0x0000); 
        LCD_WriteReg(0x0085,0x0000); 
  		//Panel Interface Control//
        LCD_WriteReg(0x0090,0x0013);//0x0010 frenqucy
        LCD_WriteReg(0x0092,0x0300); 
        LCD_WriteReg(0x0093,0x0005); 
        LCD_WriteReg(0x0095,0x0000); 
        LCD_WriteReg(0x0097,0x0000); 
        LCD_WriteReg(0x0098,0x0000); 
  
        LCD_WriteReg(0x0001,0x0100); 
        LCD_WriteReg(0x0002,0x0700); 
        LCD_WriteReg(0x0003,0x1038);//扫锟借方锟斤拷 锟斤拷->锟斤拷  锟斤拷->锟斤拷 
        LCD_WriteReg(0x0004,0x0000); 
        LCD_WriteReg(0x000C,0x0000); 
        LCD_WriteReg(0x000F,0x0000); 
        LCD_WriteReg(0x0020,0x0000); 
        LCD_WriteReg(0x0021,0x0000); 
        LCD_WriteReg(0x0007,0x0021); 
        delay_ms(20);
        LCD_WriteReg(0x0007,0x0061); 
        delay_ms(20);
        LCD_WriteReg(0x0007,0x0173); 
        delay_ms(20);
	}else if(lcddev.id==0xB505)
	{
		LCD_WriteReg(0x0000,0x0000);
		LCD_WriteReg(0x0000,0x0000);
		LCD_WriteReg(0x0000,0x0000);
		LCD_WriteReg(0x0000,0x0000);
		
		LCD_WriteReg(0x00a4,0x0001);
		delay_ms(20);		  
		LCD_WriteReg(0x0060,0x2700);
		LCD_WriteReg(0x0008,0x0202);
		
		LCD_WriteReg(0x0030,0x0214);
		LCD_WriteReg(0x0031,0x3715);
		LCD_WriteReg(0x0032,0x0604);
		LCD_WriteReg(0x0033,0x0e16);
		LCD_WriteReg(0x0034,0x2211);
		LCD_WriteReg(0x0035,0x1500);
		LCD_WriteReg(0x0036,0x8507);
		LCD_WriteReg(0x0037,0x1407);
		LCD_WriteReg(0x0038,0x1403);
		LCD_WriteReg(0x0039,0x0020);
		
		LCD_WriteReg(0x0090,0x001a);
		LCD_WriteReg(0x0010,0x0000);
		LCD_WriteReg(0x0011,0x0007);
		LCD_WriteReg(0x0012,0x0000);
		LCD_WriteReg(0x0013,0x0000);
		delay_ms(20);
		
		LCD_WriteReg(0x0010,0x0730);
		LCD_WriteReg(0x0011,0x0137);
		delay_ms(20);
		
		LCD_WriteReg(0x0012,0x01b8);
		delay_ms(20);
		
		LCD_WriteReg(0x0013,0x0f00);
		LCD_WriteReg(0x002a,0x0080);
		LCD_WriteReg(0x0029,0x0048);
		delay_ms(20);
		
		LCD_WriteReg(0x0001,0x0100);
		LCD_WriteReg(0x0002,0x0700);
        LCD_WriteReg(0x0003,0x1038);//扫锟借方锟斤拷 锟斤拷->锟斤拷  锟斤拷->锟斤拷 
		LCD_WriteReg(0x0008,0x0202);
		LCD_WriteReg(0x000a,0x0000);
		LCD_WriteReg(0x000c,0x0000);
		LCD_WriteReg(0x000d,0x0000);
		LCD_WriteReg(0x000e,0x0030);
		LCD_WriteReg(0x0050,0x0000);
		LCD_WriteReg(0x0051,0x00ef);
		LCD_WriteReg(0x0052,0x0000);
		LCD_WriteReg(0x0053,0x013f);
		LCD_WriteReg(0x0060,0x2700);
		LCD_WriteReg(0x0061,0x0001);
		LCD_WriteReg(0x006a,0x0000);
		//LCD_WriteReg(0x0080,0x0000);
		//LCD_WriteReg(0x0081,0x0000);
		LCD_WriteReg(0x0090,0X0011);
		LCD_WriteReg(0x0092,0x0600);
		LCD_WriteReg(0x0093,0x0402);
		LCD_WriteReg(0x0094,0x0002);
		delay_ms(20);
		
		LCD_WriteReg(0x0007,0x0001);
		delay_ms(20);
		LCD_WriteReg(0x0007,0x0061);
		LCD_WriteReg(0x0007,0x0173);
		
		LCD_WriteReg(0x0020,0x0000);
		LCD_WriteReg(0x0021,0x0000);	  
		LCD_WriteReg(0x00,0x22);  
	}else if(lcddev.id==0xC505)
	{
		LCD_WriteReg(0x0000,0x0000);
		LCD_WriteReg(0x0000,0x0000);
		delay_ms(20);		  
		LCD_WriteReg(0x0000,0x0000);
		LCD_WriteReg(0x0000,0x0000);
		LCD_WriteReg(0x0000,0x0000);
		LCD_WriteReg(0x0000,0x0000);
 		LCD_WriteReg(0x00a4,0x0001);
		delay_ms(20);		  
		LCD_WriteReg(0x0060,0x2700);
		LCD_WriteReg(0x0008,0x0806);
		
		LCD_WriteReg(0x0030,0x0703);//gamma setting
		LCD_WriteReg(0x0031,0x0001);
		LCD_WriteReg(0x0032,0x0004);
		LCD_WriteReg(0x0033,0x0102);
		LCD_WriteReg(0x0034,0x0300);
		LCD_WriteReg(0x0035,0x0103);
		LCD_WriteReg(0x0036,0x001F);
		LCD_WriteReg(0x0037,0x0703);
		LCD_WriteReg(0x0038,0x0001);
		LCD_WriteReg(0x0039,0x0004);
		
		
		
		LCD_WriteReg(0x0090, 0x0015);	//80Hz
		LCD_WriteReg(0x0010, 0X0410);	//BT,AP
		LCD_WriteReg(0x0011,0x0247);	//DC1,DC0,VC
		LCD_WriteReg(0x0012, 0x01BC);
		LCD_WriteReg(0x0013, 0x0e00);
		delay_ms(120);
		LCD_WriteReg(0x0001, 0x0100);
		LCD_WriteReg(0x0002, 0x0200);
		LCD_WriteReg(0x0003, 0x1030);
		
		LCD_WriteReg(0x000A, 0x0008);
		LCD_WriteReg(0x000C, 0x0000);
		
		LCD_WriteReg(0x000E, 0x0020);
		LCD_WriteReg(0x000F, 0x0000);
		LCD_WriteReg(0x0020, 0x0000);	//H Start
		LCD_WriteReg(0x0021, 0x0000);	//V Start
		LCD_WriteReg(0x002A,0x003D);	//vcom2
		delay_ms(20);
		LCD_WriteReg(0x0029, 0x002d);
		LCD_WriteReg(0x0050, 0x0000);
		LCD_WriteReg(0x0051, 0xD0EF);
		LCD_WriteReg(0x0052, 0x0000);
		LCD_WriteReg(0x0053, 0x013F);
		LCD_WriteReg(0x0061, 0x0000);
		LCD_WriteReg(0x006A, 0x0000);
		LCD_WriteReg(0x0092,0x0300); 
 
 		LCD_WriteReg(0x0093, 0x0005);
		LCD_WriteReg(0x0007, 0x0100);
	}else if(lcddev.id==0x4531)//OK |/|/|
	{
		LCD_WriteReg(0X00,0X0001);   
		delay_ms(10);   
		LCD_WriteReg(0X10,0X1628);   
		LCD_WriteReg(0X12,0X000e);//0x0006    
		LCD_WriteReg(0X13,0X0A39);   
		delay_ms(10);   
		LCD_WriteReg(0X11,0X0040);   
		LCD_WriteReg(0X15,0X0050);   
		delay_ms(10);   
		LCD_WriteReg(0X12,0X001e);//16    
		delay_ms(10);   
		LCD_WriteReg(0X10,0X1620);   
		LCD_WriteReg(0X13,0X2A39);   
		delay_ms(10);   
		LCD_WriteReg(0X01,0X0100);   
		LCD_WriteReg(0X02,0X0300);   
		LCD_WriteReg(0X03,0X1038);//锟侥变方锟斤拷锟   
		LCD_WriteReg(0X08,0X0202);   
		LCD_WriteReg(0X0A,0X0008);   
		LCD_WriteReg(0X30,0X0000);   
		LCD_WriteReg(0X31,0X0402);   
		LCD_WriteReg(0X32,0X0106);   
		LCD_WriteReg(0X33,0X0503);   
		LCD_WriteReg(0X34,0X0104);   
		LCD_WriteReg(0X35,0X0301);   
		LCD_WriteReg(0X36,0X0707);   
		LCD_WriteReg(0X37,0X0305);   
		LCD_WriteReg(0X38,0X0208);   
		LCD_WriteReg(0X39,0X0F0B);   
		LCD_WriteReg(0X41,0X0002);   
		LCD_WriteReg(0X60,0X2700);   
		LCD_WriteReg(0X61,0X0001);   
		LCD_WriteReg(0X90,0X0210);   
		LCD_WriteReg(0X92,0X010A);   
		LCD_WriteReg(0X93,0X0004);   
		LCD_WriteReg(0XA0,0X0100);   
		LCD_WriteReg(0X07,0X0001);   
		LCD_WriteReg(0X07,0X0021);   
		LCD_WriteReg(0X07,0X0023);   
		LCD_WriteReg(0X07,0X0033);   
		LCD_WriteReg(0X07,0X0133);   
		LCD_WriteReg(0XA0,0X0000); 
	}else if(lcddev.id==0x4535)
	{			      
		LCD_WriteReg(0X15,0X0030);   
		LCD_WriteReg(0X9A,0X0010);   
 		LCD_WriteReg(0X11,0X0020);   
 		LCD_WriteReg(0X10,0X3428);   
		LCD_WriteReg(0X12,0X0002);//16    
 		LCD_WriteReg(0X13,0X1038);   
		delay_ms(40);   
		LCD_WriteReg(0X12,0X0012);//16    
		delay_ms(40);   
  		LCD_WriteReg(0X10,0X3420);   
 		LCD_WriteReg(0X13,0X3038);   
		delay_ms(70);   
		LCD_WriteReg(0X30,0X0000);   
		LCD_WriteReg(0X31,0X0402);   
		LCD_WriteReg(0X32,0X0307);   
		LCD_WriteReg(0X33,0X0304);   
		LCD_WriteReg(0X34,0X0004);   
		LCD_WriteReg(0X35,0X0401);   
		LCD_WriteReg(0X36,0X0707);   
		LCD_WriteReg(0X37,0X0305);   
		LCD_WriteReg(0X38,0X0610);   
		LCD_WriteReg(0X39,0X0610); 
		  
		LCD_WriteReg(0X01,0X0100);   
		LCD_WriteReg(0X02,0X0300);   
		LCD_WriteReg(0X03,0X1030);//锟侥变方锟斤拷锟   
		LCD_WriteReg(0X08,0X0808);   
		LCD_WriteReg(0X0A,0X0008);   
 		LCD_WriteReg(0X60,0X2700);   
		LCD_WriteReg(0X61,0X0001);   
		LCD_WriteReg(0X90,0X013E);   
		LCD_WriteReg(0X92,0X0100);   
		LCD_WriteReg(0X93,0X0100);   
 		LCD_WriteReg(0XA0,0X3000);   
 		LCD_WriteReg(0XA3,0X0010);   
		LCD_WriteReg(0X07,0X0001);   
		LCD_WriteReg(0X07,0X0021);   
		LCD_WriteReg(0X07,0X0023);   
		LCD_WriteReg(0X07,0X0033);   
		LCD_WriteReg(0X07,0X0133);   
	}else if(lcddev.id==0X1963)
	{
		LCD_WR_REG(0xE2);		//Set PLL with OSC = 10MHz (hardware),	Multiplier N = 35, 250MHz < VCO < 800MHz = OSC*(N+1), VCO = 300MHz
		LCD_WR_DATA(0x1D);		//锟斤拷锟斤拷1 
		LCD_WR_DATA(0x02);		//锟斤拷锟斤拷2 Divider M = 2, PLL = 300/(M+1) = 100MHz
		LCD_WR_DATA(0x04);		//锟斤拷锟斤拷3 Validate M and N values   
		delay_us(100);
		LCD_WR_REG(0xE0);		// Start PLL command
		LCD_WR_DATA(0x01);		// enable PLL
		delay_ms(10);
		LCD_WR_REG(0xE0);		// Start PLL command again
		LCD_WR_DATA(0x03);		// now, use PLL output as system clock	
		delay_ms(12);  
		LCD_WR_REG(0x01);		//锟斤拷锟斤拷位
		delay_ms(10);
		
		LCD_WR_REG(0xE6);		//锟斤拷锟斤拷锟斤拷锟斤拷频锟斤拷,33Mhz
		LCD_WR_DATA(0x2F);
		LCD_WR_DATA(0xFF);
		LCD_WR_DATA(0xFF);
		
		LCD_WR_REG(0xB0);		//锟斤拷锟斤拷LCD模式
		LCD_WR_DATA(0x20);		//24位模式
		LCD_WR_DATA(0x00);		//TFT 模式 
	
		LCD_WR_DATA((SSD_HOR_RESOLUTION-1)>>8);//锟斤拷锟斤拷LCD水平锟斤拷锟斤拷
		LCD_WR_DATA(SSD_HOR_RESOLUTION-1);		 
		LCD_WR_DATA((SSD_VER_RESOLUTION-1)>>8);//锟斤拷锟斤拷LCD锟斤拷直锟斤拷锟斤拷
		LCD_WR_DATA(SSD_VER_RESOLUTION-1);		 
		LCD_WR_DATA(0x00);		//RGB锟斤拷锟斤拷 
		
		LCD_WR_REG(0xB4);		//Set horizontal period
		LCD_WR_DATA((SSD_HT-1)>>8);
		LCD_WR_DATA(SSD_HT-1);
		LCD_WR_DATA(SSD_HPS>>8);
		LCD_WR_DATA(SSD_HPS);
		LCD_WR_DATA(SSD_HOR_PULSE_WIDTH-1);
		LCD_WR_DATA(0x00);
		LCD_WR_DATA(0x00);
		LCD_WR_DATA(0x00);
		LCD_WR_REG(0xB6);		//Set vertical period
		LCD_WR_DATA((SSD_VT-1)>>8);
		LCD_WR_DATA(SSD_VT-1);
		LCD_WR_DATA(SSD_VPS>>8);
		LCD_WR_DATA(SSD_VPS);
		LCD_WR_DATA(SSD_VER_FRONT_PORCH-1);
		LCD_WR_DATA(0x00);
		LCD_WR_DATA(0x00);
		
		LCD_WR_REG(0xF0);	//锟斤拷锟斤拷SSD1963锟斤拷CPU锟接匡拷为16bit  
		LCD_WR_DATA(0x03);	//16-bit(565 format) data for 16bpp 

		LCD_WR_REG(0x29);	//锟斤拷锟斤拷锟斤拷示
		//锟斤拷锟斤拷PWM锟斤拷锟  锟斤拷锟斤拷通锟斤拷占锟秸比可碉拷 
		LCD_WR_REG(0xD0);	//锟斤拷锟斤拷锟皆讹拷锟斤拷平锟斤拷DBC
		LCD_WR_DATA(0x00);	//disable
	
		LCD_WR_REG(0xBE);	//锟斤拷锟斤拷PWM锟斤拷锟
		LCD_WR_DATA(0x05);	//1锟斤拷锟斤拷PWM频锟斤拷
		LCD_WR_DATA(0xFE);	//2锟斤拷锟斤拷PWM占锟秸憋拷
		LCD_WR_DATA(0x01);	//3锟斤拷锟斤拷C
		LCD_WR_DATA(0x00);	//4锟斤拷锟斤拷D
		LCD_WR_DATA(0x00);	//5锟斤拷锟斤拷E 
		LCD_WR_DATA(0x00);	//6锟斤拷锟斤拷F 
		
		LCD_WR_REG(0xB8);	//锟斤拷锟斤拷GPIO锟斤拷锟斤拷
		LCD_WR_DATA(0x03);	//2锟斤拷IO锟斤拷锟斤拷锟矫筹拷锟斤拷锟
		LCD_WR_DATA(0x01);	//GPIO使锟斤拷锟斤拷锟斤拷锟斤拷IO锟斤拷锟斤拷 
		LCD_WR_REG(0xBA);
		LCD_WR_DATA(0X01);	//GPIO[1:0]=01,锟斤拷锟斤拷LCD锟斤拷锟斤拷
		
		LCD_SSD_BackLightSet(100);//锟斤拷锟斤拷锟斤拷锟斤拷为锟斤拷锟斤拷
	}		 
	LCD_Display_Dir(0);		//默锟斤拷为锟斤拷锟斤拷
	LCD_LED=1;
	delay_ms(50);		//item4: wait 50ms after regs configured, before GRAM wipe
	LCD_WR_REG(0x30);   //re-poke PTLAR with final MADCTL (0x08) active: full area
	LCD_WR_DATA(0x00);LCD_WR_DATA(0x00);	//SC=0
	LCD_WR_DATA(0x01);LCD_WR_DATA(0x3F);	//EC=319(hw landscape)
	LCD_WR_DATA(0x00);LCD_WR_DATA(0x00);	//SP=0
	LCD_WR_DATA(0x00);LCD_WR_DATA(0xEF);	//EP=239(hw landscape)
	LCD_WR_REG(0x13);   //Normal Display Mode ON
	LCD_Set_Window(0,0,lcddev.width,lcddev.height);	//canonical window 0..239 / 0..319				//锟斤拷锟斤拷锟斤拷锟斤拷
	LCD_Clear(BLACK);	//item4: wipe whole GRAM with 0 to clear residue garbage
	LCD_Clear(WHITE);	//final: deep wipe before returning to main
}  
//锟斤拷锟斤拷锟斤拷锟斤拷
//color:要锟斤拷锟斤拷锟斤拷锟斤拷锟缴
void LCD_Clear(u16 color)
{
	u32 index=0;      
	u32 totalpoint=lcddev.width;
	if(lcddev.id==0X9341)color=~color;	//stuck inversion: software complement
	totalpoint*=lcddev.height; 			//锟矫碉拷锟杰碉拷锟斤拷
	if((lcddev.id==0X6804)&&(lcddev.dir==1))//6804锟斤拷锟斤拷锟斤拷时锟斤拷锟斤拷锟解处锟斤拷  
	{						    
 		lcddev.dir=0;	 
 		lcddev.setxcmd=0X2A;
		lcddev.setycmd=0X2B;  	 			
		LCD_SetCursor(0x00,0x0000);		//锟斤拷锟矫癸拷锟轿伙拷锟  
 		lcddev.dir=1;	 
  		lcddev.setxcmd=0X2B;
		lcddev.setycmd=0X2A;  	 
 	}else LCD_SetCursor(0x00,0x0000);	//锟斤拷锟矫癸拷锟轿伙拷锟 
	LCD_WriteRAM_Prepare();     		//锟斤拷始写锟斤拷GRAM	 	  
	for(index=0;index<totalpoint;index++)
	{
		LCD->LCD_RAM=color;	
	}
}  
//锟斤拷指锟斤拷锟斤拷锟斤拷锟斤拷锟斤拷涞ワ拷锟斤拷锟缴
//(sx,sy),(ex,ey):锟斤拷锟斤拷锟轿对斤拷锟斤拷锟斤拷,锟斤拷锟斤拷锟叫∥:(ex-sx+1)*(ey-sy+1)   
//color:要锟斤拷锟斤拷锟斤拷色
void LCD_Fill(u16 sx,u16 sy,u16 ex,u16 ey,u16 color)
{          
	u16 i,j;
	u16 xlen=0;
		u16 temp;
	if(lcddev.id==0X9341)color=~color;	//stuck inversion: software complement
	if((lcddev.id==0X6804)&&(lcddev.dir==1))	//6804锟斤拷锟斤拷锟斤拷时锟斤拷锟斤拷锟解处锟斤拷  
	{
		temp=sx;
		sx=sy;
		sy=lcddev.width-ex-1;	  
		ex=ey;
		ey=lcddev.width-temp-1;
 		lcddev.dir=0;	 
 		lcddev.setxcmd=0X2A;
		lcddev.setycmd=0X2B;  	 			
		LCD_Fill(sx,sy,ex,ey,color);  
 		lcddev.dir=1;	 
  		lcddev.setxcmd=0X2B;
		lcddev.setycmd=0X2A;  	 
 	}else
	{
		xlen=ex-sx+1;
		for(i=sy;i<=ey;i++)
		{
		 	LCD_SetCursor(sx,i);      				//锟斤拷锟矫癸拷锟轿伙拷锟 
			LCD_WriteRAM_Prepare();     			//锟斤拷始写锟斤拷GRAM	  
			for(j=0;j<xlen;j++)LCD->LCD_RAM=color;	//锟斤拷示锟斤拷色 	    
		}
	}	 
}  
//锟斤拷指锟斤拷锟斤拷锟斤拷锟斤拷锟斤拷锟街革拷锟斤拷锟缴锟斤拷			 
//(sx,sy),(ex,ey):锟斤拷锟斤拷锟轿对斤拷锟斤拷锟斤拷,锟斤拷锟斤拷锟叫∥:(ex-sx+1)*(ey-sy+1)   
//color:要锟斤拷锟斤拷锟斤拷色
void LCD_Color_Fill(u16 sx,u16 sy,u16 ex,u16 ey,u16 *color)
{  
	u16 height,width;
	u16 i,j;
	width=ex-sx+1; 			//锟矫碉拷锟斤拷锟侥匡拷锟斤拷
	height=ey-sy+1;			//锟竭讹拷
 	for(i=0;i<height;i++)
	{
 		LCD_SetCursor(sx,sy+i);   	//锟斤拷锟矫癸拷锟轿伙拷锟 
		LCD_WriteRAM_Prepare();     //锟斤拷始写锟斤拷GRAM
		for(j=0;j<width;j++)LCD->LCD_RAM=(lcddev.id==0X9341)?~color[i*width+j]:color[i*width+j];//写锟斤拷锟斤拷锟斤拷 
	}		  
}  
//锟斤拷锟斤拷
//x1,y1:锟斤拷锟斤拷锟斤拷锟
//x2,y2:锟秸碉拷锟斤拷锟斤拷  
void LCD_DrawLine(u16 x1, u16 y1, u16 x2, u16 y2)
{
	u16 t; 
	int xerr=0,yerr=0,delta_x,delta_y,distance; 
	int incx,incy,uRow,uCol; 
	delta_x=x2-x1; //锟斤拷锟斤拷锟斤拷锟斤拷锟斤拷锟斤拷 
	delta_y=y2-y1; 
	uRow=x1; 
	uCol=y1; 
	if(delta_x>0)incx=1; //锟斤拷锟矫碉拷锟斤拷锟斤拷锟斤拷 
	else if(delta_x==0)incx=0;//锟斤拷直锟斤拷 
	else {incx=-1;delta_x=-delta_x;} 
	if(delta_y>0)incy=1; 
	else if(delta_y==0)incy=0;//水平锟斤拷 
	else{incy=-1;delta_y=-delta_y;} 
	if( delta_x>delta_y)distance=delta_x; //选取锟斤拷锟斤拷锟斤拷锟斤拷锟斤拷锟斤拷锟斤拷 
	else distance=delta_y; 
	for(t=0;t<=distance+1;t++ )//锟斤拷锟斤拷锟斤拷锟 
	{  
		LCD_DrawPoint(uRow,uCol);//锟斤拷锟斤拷 
		xerr+=delta_x ; 
		yerr+=delta_y ; 
		if(xerr>distance) 
		{ 
			xerr-=distance; 
			uRow+=incx; 
		} 
		if(yerr>distance) 
		{ 
			yerr-=distance; 
			uCol+=incy; 
		} 
	}  
}    
//锟斤拷锟斤拷锟斤拷	  
//(x1,y1),(x2,y2):锟斤拷锟轿的对斤拷锟斤拷锟斤拷
void LCD_DrawRectangle(u16 x1, u16 y1, u16 x2, u16 y2)
{
	LCD_DrawLine(x1,y1,x2,y1);
	LCD_DrawLine(x1,y1,x1,y2);
	LCD_DrawLine(x1,y2,x2,y2);
	LCD_DrawLine(x2,y1,x2,y2);
}
//锟斤拷指锟斤拷位锟矫伙拷一锟斤拷指锟斤拷锟斤拷小锟斤拷圆
//(x,y):锟斤拷锟侥碉拷
//r    :锟诫径
void LCD_Draw_Circle(u16 x0,u16 y0,u8 r)
{
	int a,b;
	int di;
	a=0;b=r;	  
	di=3-(r<<1);             //锟叫讹拷锟铰革拷锟斤拷位锟矫的憋拷志
	while(a<=b)
	{
		LCD_DrawPoint(x0+a,y0-b);             //5
 		LCD_DrawPoint(x0+b,y0-a);             //0           
		LCD_DrawPoint(x0+b,y0+a);             //4               
		LCD_DrawPoint(x0+a,y0+b);             //6 
		LCD_DrawPoint(x0-a,y0+b);             //1       
 		LCD_DrawPoint(x0-b,y0+a);             
		LCD_DrawPoint(x0-a,y0-b);             //2             
  		LCD_DrawPoint(x0-b,y0-a);             //7     	         
		a++;
		//使锟斤拷Bresenham锟姐法锟斤拷圆     
		if(di<0)di +=4*a+6;	  
		else
		{
			di+=10+4*(a-b);   
			b--;
		} 						    
	}
} 									  
//锟斤拷指锟斤拷位锟斤拷锟斤拷示一锟斤拷锟街凤拷
//x,y:锟斤拷始锟斤拷锟斤拷
//num:要锟斤拷示锟斤拷锟街凤拷:" "--->"~"
//size:锟斤拷锟斤拷锟叫 12/16/24
//mode:锟斤拷锟接凤拷式(1)锟斤拷锟角非碉拷锟接凤拷式(0)
void LCD_ShowChar(u16 x,u16 y,u8 num,u8 size,u8 mode)
{  							  
    u8 temp,t1,t;
	u16 y0=y;
	u8 csize=(size/8+((size%8)?1:0))*(size/2);		//锟矫碉拷锟斤拷锟斤拷一锟斤拷锟街凤拷锟斤拷应锟斤拷锟斤拷锟斤拷占锟斤拷锟街斤拷锟斤拷	
 	num=num-' ';//锟矫碉拷偏锟狡猴拷锟街碉拷锟紸SCII锟街匡拷锟角从空革拷始取模锟斤拷锟斤拷锟斤拷-' '锟斤拷锟角讹拷应锟街凤拷锟斤拷锟街库）
	for(t=0;t<csize;t++)
	{   
		if(size==12)temp=asc2_1206[num][t]; 	 	//锟斤拷锟斤拷1206锟斤拷锟斤拷
		else if(size==16)temp=asc2_1608[num][t];	//锟斤拷锟斤拷1608锟斤拷锟斤拷
		else if(size==24)temp=asc2_2412[num][t];	//锟斤拷锟斤拷2412锟斤拷锟斤拷
		else return;								//没锟叫碉拷锟街匡拷
		for(t1=0;t1<8;t1++)
		{			    
			if(temp&0x80)LCD_Fast_DrawPoint(x,y,POINT_COLOR);
			else if(mode==0)LCD_Fast_DrawPoint(x,y,BACK_COLOR);
			temp<<=1;
			y++;
			if(y>=lcddev.height)return;		//锟斤拷锟斤拷锟斤拷锟斤拷
			if((y-y0)==size)
			{
				y=y0;
				x++;
				if(x>=lcddev.width)return;	//锟斤拷锟斤拷锟斤拷锟斤拷
				break;
			}
		}  	 
	}  	    	   	 	  
}   
//m^n锟斤拷锟斤拷
//锟斤拷锟斤拷值:m^n锟轿凤拷.
u32 LCD_Pow(u8 m,u8 n)
{
	u32 result=1;	 
	while(n--)result*=m;    
	return result;
}			 
//锟斤拷示锟斤拷锟斤拷,锟斤拷位为0,锟斤拷锟斤拷示
//x,y :锟斤拷锟斤拷锟斤拷锟	 
//len :锟斤拷锟街碉拷位锟斤拷
//size:锟斤拷锟斤拷锟叫
//color:锟斤拷色 
//num:锟斤拷值(0~4294967295);	 
void LCD_ShowNum(u16 x,u16 y,u32 num,u8 len,u8 size)
{         	
	u8 t,temp;
	u8 enshow=0;						   
	for(t=0;t<len;t++)
	{
		temp=(num/LCD_Pow(10,len-t-1))%10;
		if(enshow==0&&t<(len-1))
		{
			if(temp==0)
			{
				LCD_ShowChar(x+(size/2)*t,y,' ',size,0);
				continue;
			}else enshow=1; 
		 	 
		}
	 	LCD_ShowChar(x+(size/2)*t,y,temp+'0',size,0); 
	}
} 
//锟斤拷示锟斤拷锟斤拷,锟斤拷位为0,锟斤拷锟斤拷锟斤拷示
//x,y:锟斤拷锟斤拷锟斤拷锟
//num:锟斤拷值(0~999999999);	 
//len:锟斤拷锟斤拷(锟斤拷要锟斤拷示锟斤拷位锟斤拷)
//size:锟斤拷锟斤拷锟叫
//mode:
//[7]:0,锟斤拷锟斤拷锟;1,锟斤拷锟0.
//[6:1]:锟斤拷锟斤拷
//[0]:0,锟角碉拷锟斤拷锟斤拷示;1,锟斤拷锟斤拷锟斤拷示.
void LCD_ShowxNum(u16 x,u16 y,u32 num,u8 len,u8 size,u8 mode)
{  
	u8 t,temp;
	u8 enshow=0;						   
	for(t=0;t<len;t++)
	{
		temp=(num/LCD_Pow(10,len-t-1))%10;
		if(enshow==0&&t<(len-1))
		{
			if(temp==0)
			{
				if(mode&0X80)LCD_ShowChar(x+(size/2)*t,y,'0',size,mode&0X01);  
				else LCD_ShowChar(x+(size/2)*t,y,' ',size,mode&0X01);  
 				continue;
			}else enshow=1; 
		 	 
		}
	 	LCD_ShowChar(x+(size/2)*t,y,temp+'0',size,mode&0X01); 
	}
} 
//锟斤拷示锟街凤拷锟斤拷
//x,y:锟斤拷锟斤拷锟斤拷锟
//width,height:锟斤拷锟斤拷锟叫  
//size:锟斤拷锟斤拷锟叫
//*p:锟街凤拷锟斤拷锟斤拷始锟斤拷址		  
void LCD_ShowString(u16 x,u16 y,u16 width,u16 height,u8 size,u8 *p)
{         
	u8 x0=x;
	width+=x;
	height+=y;
    while((*p<='~')&&(*p>=' '))//锟叫讹拷锟角诧拷锟角非凤拷锟街凤拷!
    {       
        if(x>=width){x=x0;y+=size;}
        if(y>=height)break;//锟剿筹拷
        LCD_ShowChar(x,y,*p,size,0);
        x+=size/2;
        p++;
    }  
}
