hah877298-a11y/handheld-thermal-imager/(commit log)

2026-11-04 初始提交：STM32 手持红外热成像仪（原理图/PCB/固件/交付文件）
    [BOM物料清单.xlsx, PCB_3D模型.step, SMT坐标文件.xlsx, 手焊物料清单.xlsx]
2026-11-04 README：3D 渲染图移到外观小节并缩放到 520px
